gridbugs/modular2/README.md

# Modular 2

A modular synthesizer, where modules are designed as close to bare PCBs as is
practical/safe. This is the spiritual successor to the [briefcase modular
synthesizer](https://github.com/gridbugs/briefcase-synth/).
