gridbugs/modular2/low-pass-filter/README.md

# Low-pass Filter

## Quirks

### V1

- The "Cutoff" potentiometer is reversed.
