gridbugs/modular2/oscillator/README.md

# Oscillator

## Quirks

### V1

- All the potentiometers are connected backwards, so use a flipped pot socket
  to connect them.
- The IDC power sockets don't connect the 5V rail between them. Connect a wire
  here so modules can be daisy chained after this one.
