gridbugs/modular2/power-supply/README.md

# Power Supply

## Quirks

### V1

- U1 is flipped on the silkscreen from how it should be connected. This means
  there's no space for a heat sink.
