gridbugs/modular2/flipped-pot-socket/README.md

# Flipped Pot Socket

The same as the Pot Socket but the sides of the potentiometer are flipped.
