gridbugs/modular2/pot-socket/pcb.stl

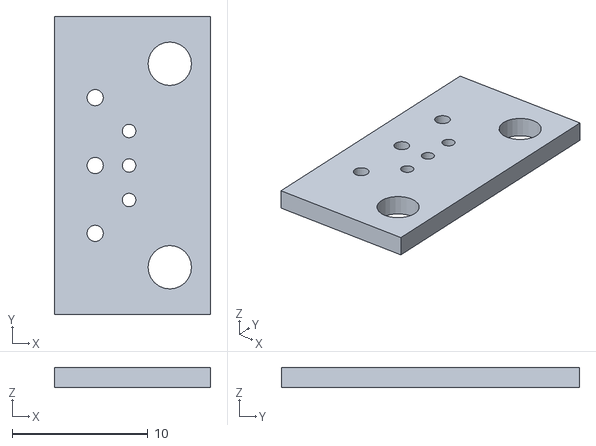
[picture p3: CAD file, 2025-12-11]
pot-socket/pcb.stl
11.5 x 22.0 x 1.51
