gridbugs/modular2/pot-socket/pot-socket.FCStd

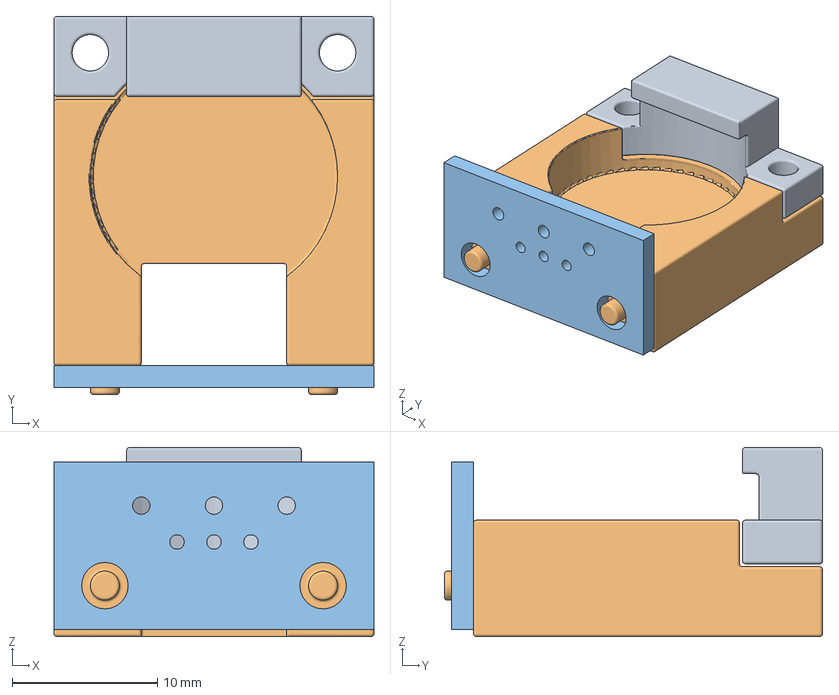
[picture p4: CAD file, 2025-12-11]
pot-socket/pot-socket.FCStd
22.0 x 26.0 x 13.0 mm
Base
pcb
