gridbugs/modular2/pot-socket/base.stl

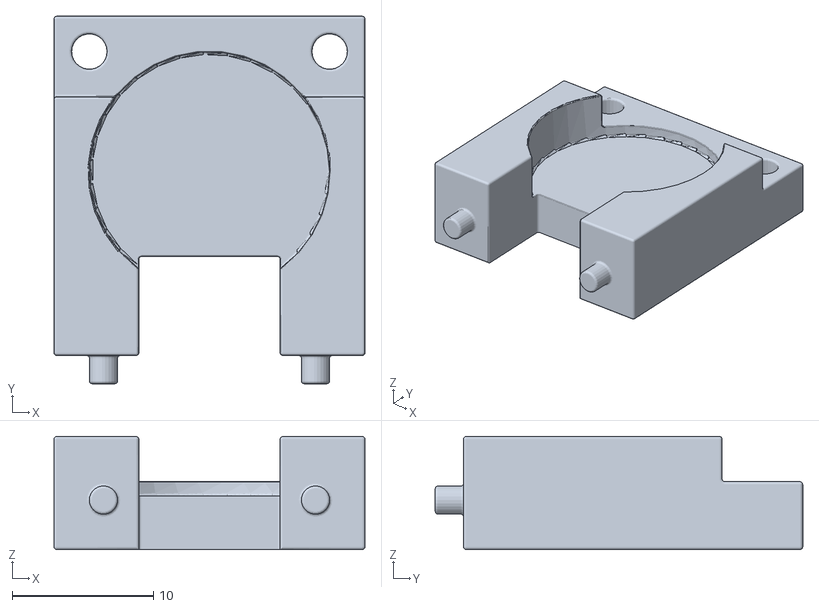
[picture p5: CAD file, 2025-12-03]
pot-socket/base.stl
22.0 x 26.0 x 8.00
