gridbugs/modular2/pot-socket/shell.stl

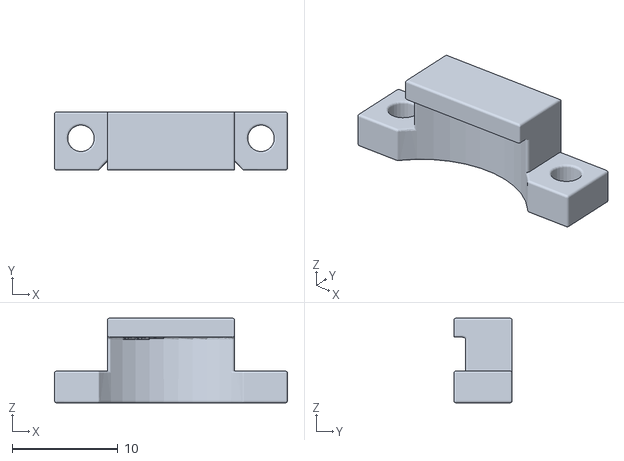
[picture p6: CAD file, 2025-12-03]
pot-socket/shell.stl
22.0 x 5.50 x 8.00
