gridbugs/modular2/gate-sequencer/output.pdf

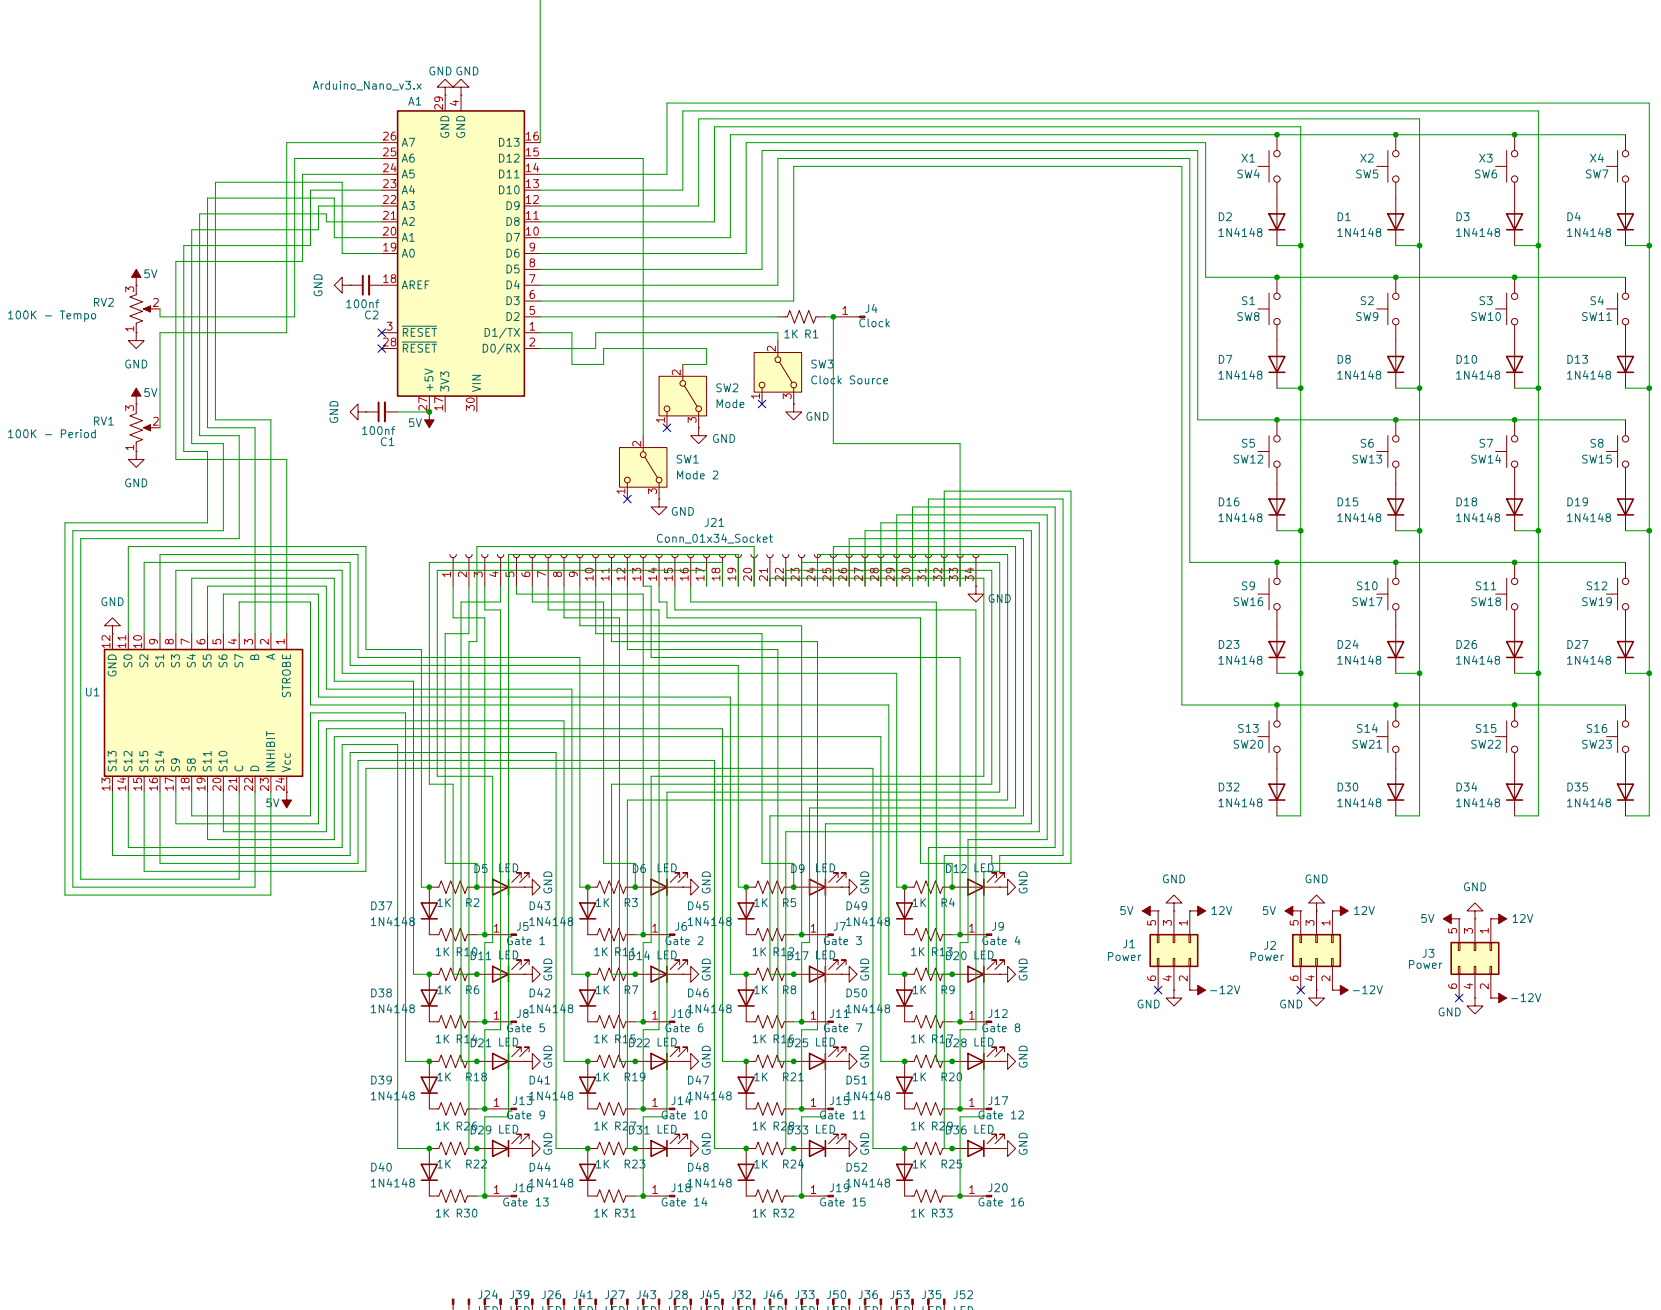
[picture p7: page 1]
