gridbugs/modular2/note-sequencer/output.pdf

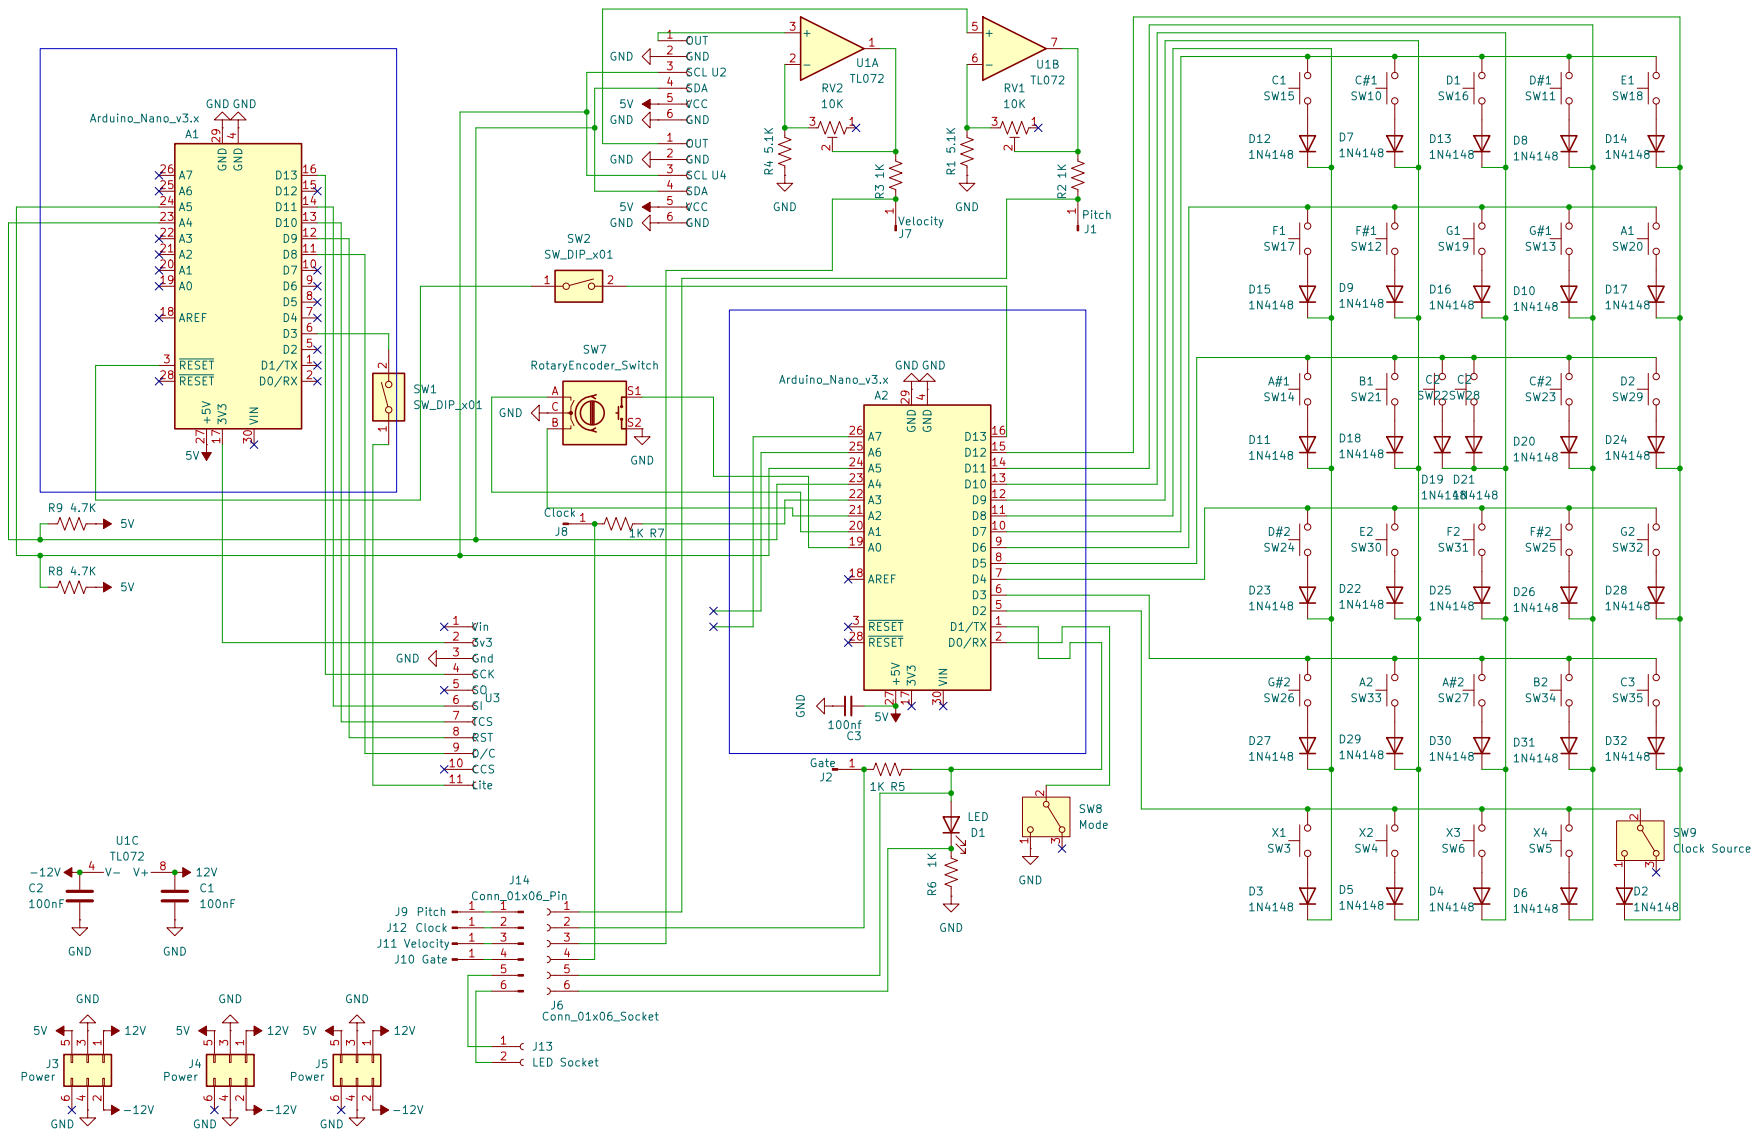
[picture p8: page 1]
