gridbugs/modular2/arduino-delay/output.pdf

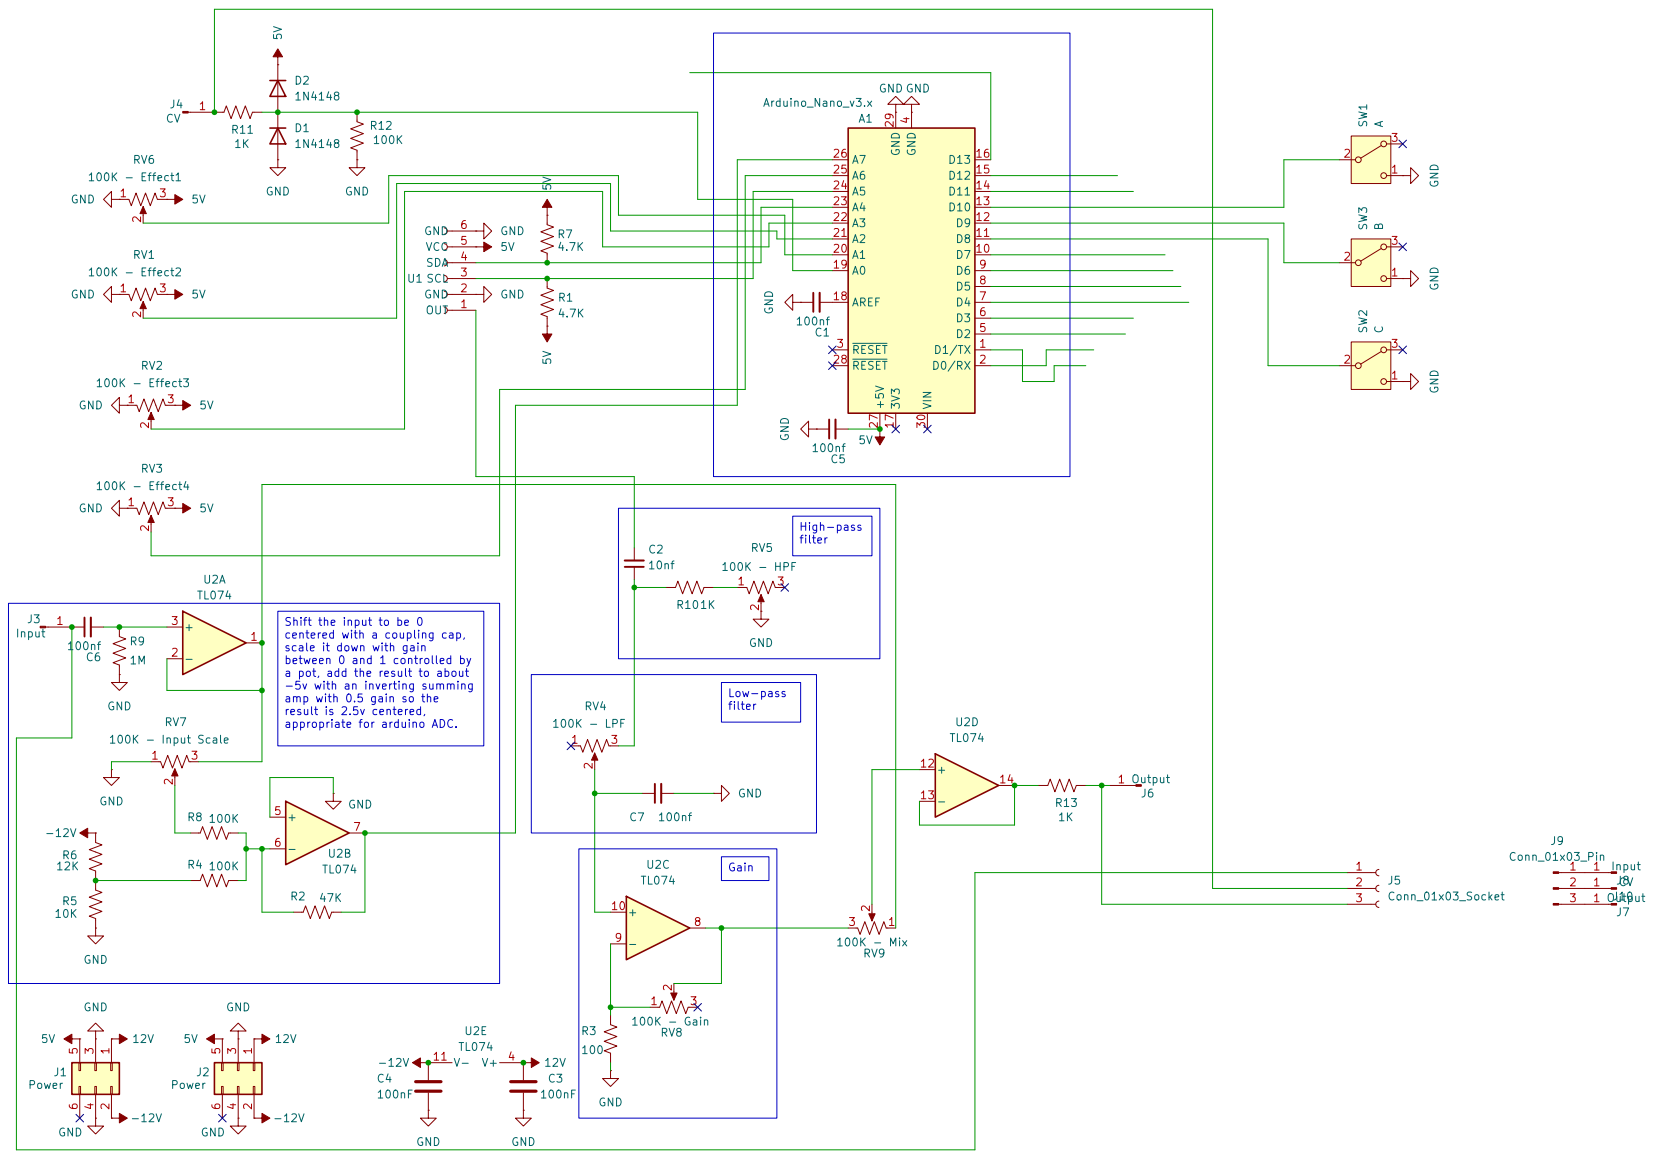
[picture p9: page 1]
