gridbugs/modular2/audio-mixer/output.pdf

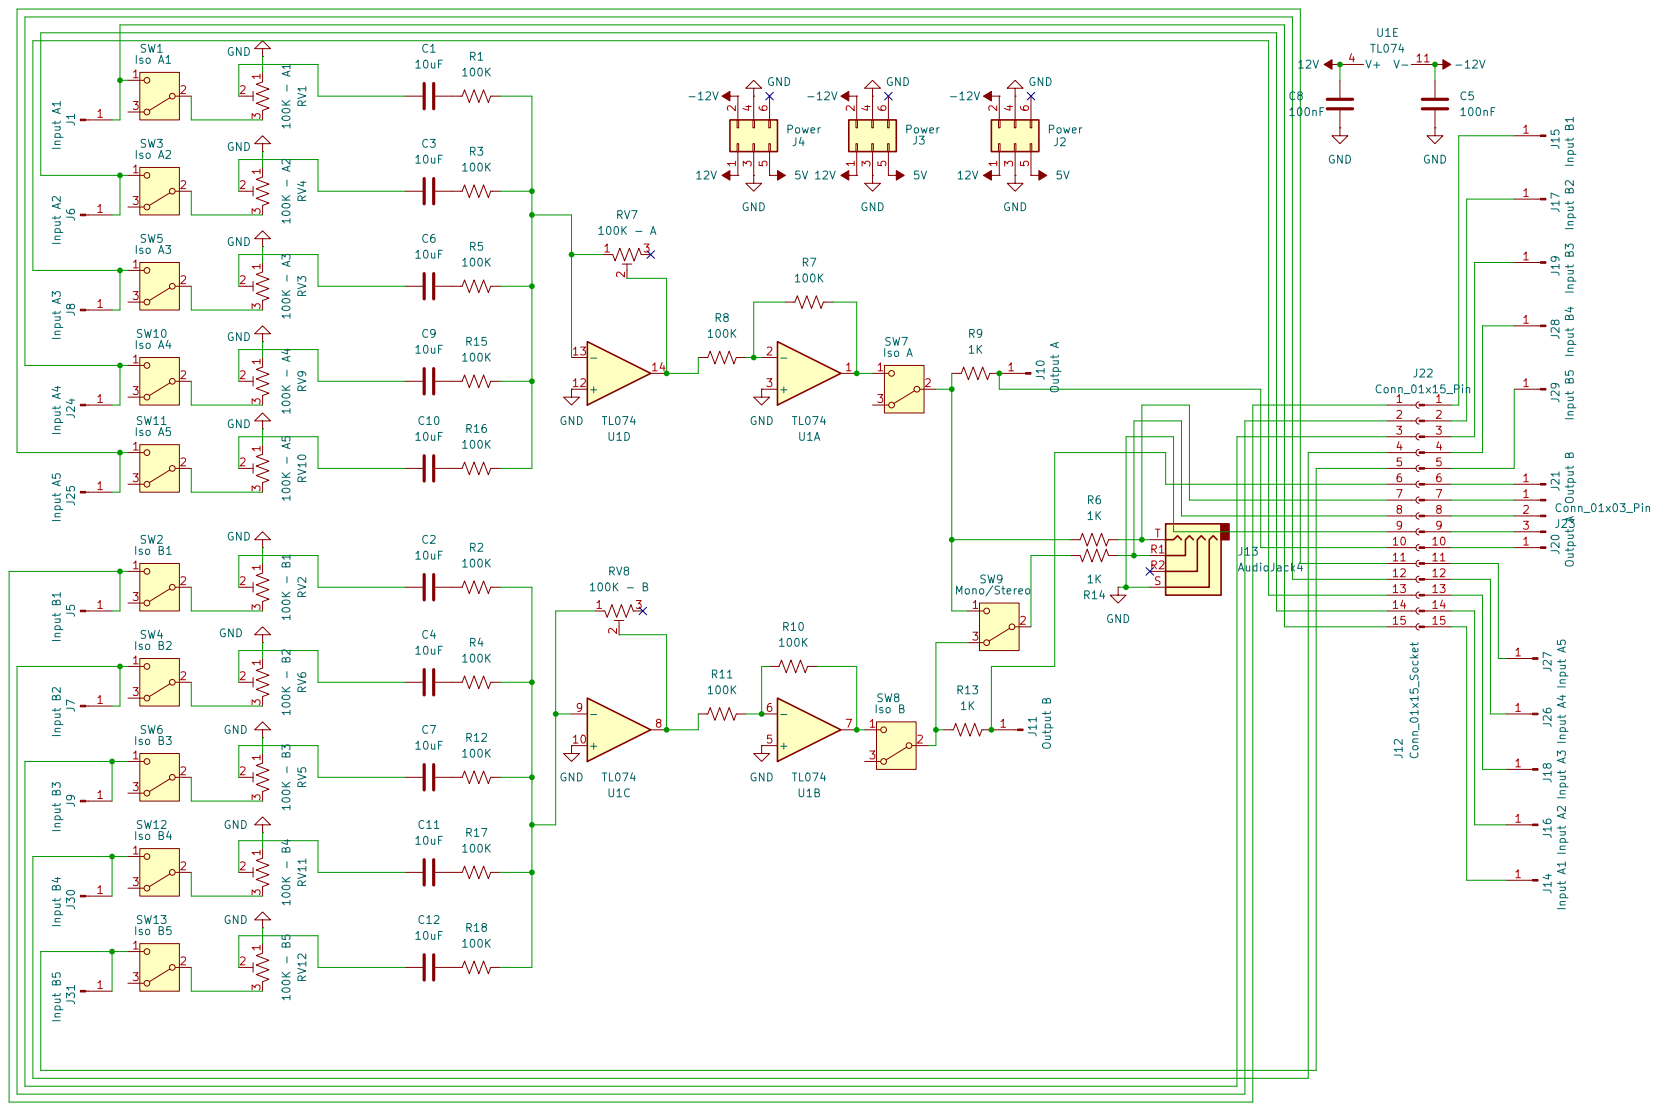
[picture p10: page 1]
