gridbugs/modular2/cv-mixer/output.pdf

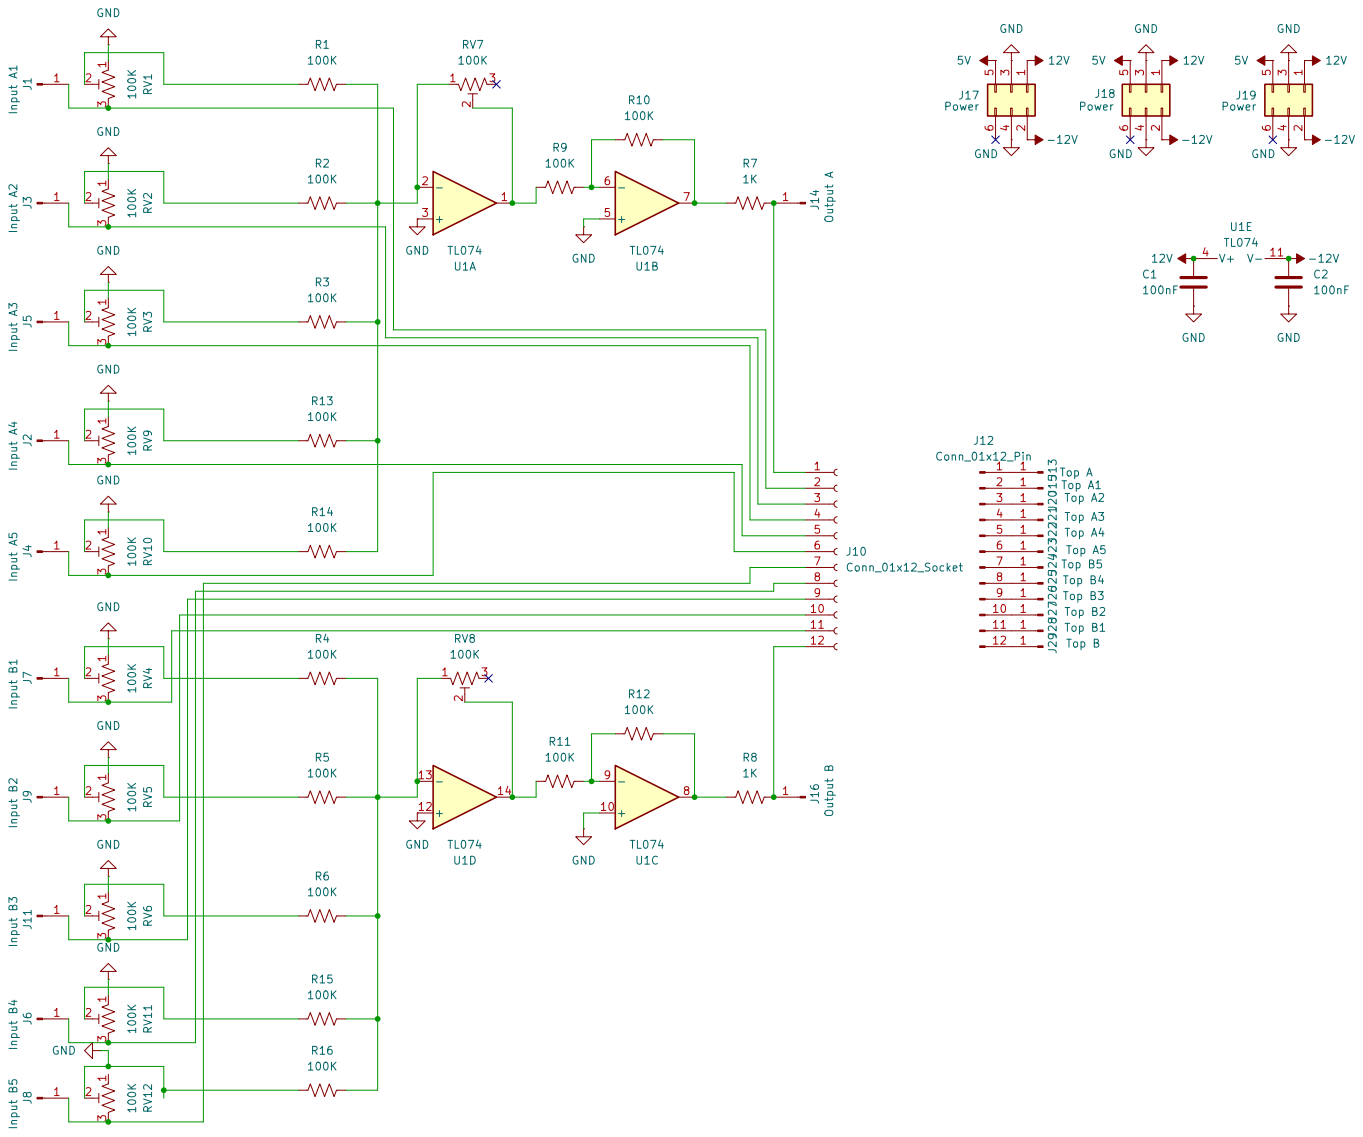
[picture p11: page 1]
