gridbugs/modular2/oscillator/output.pdf

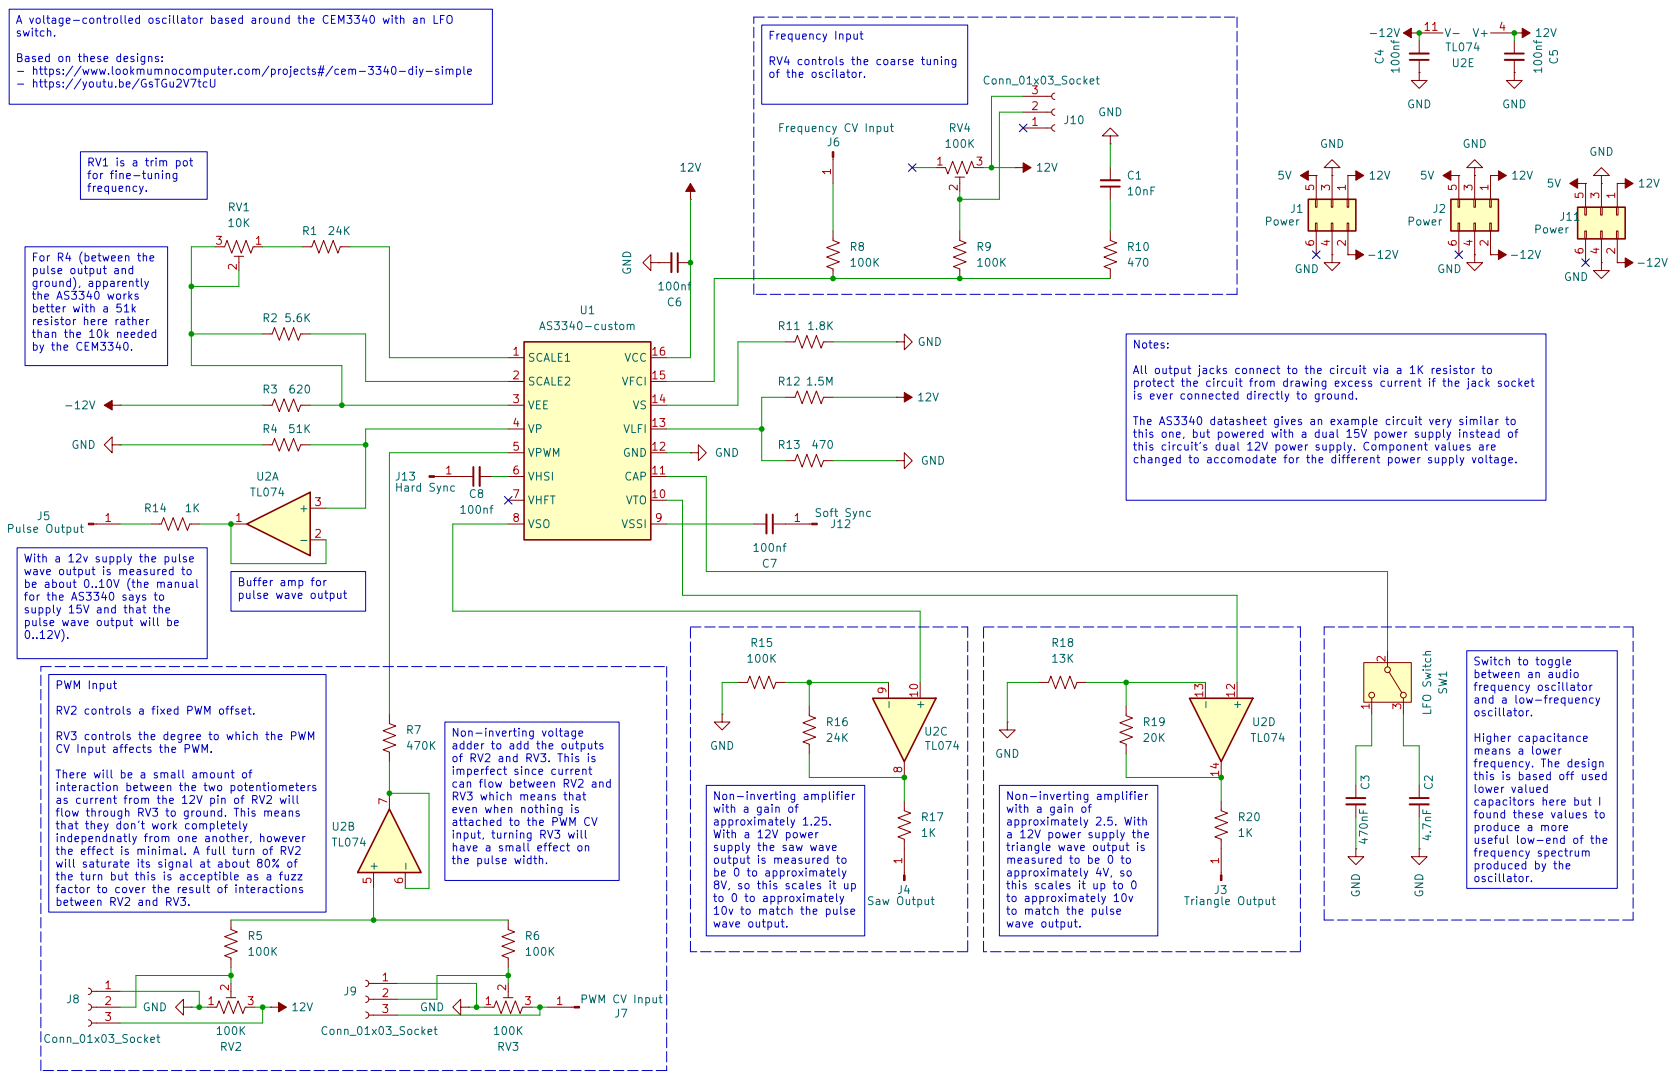
[picture p12: page 1]
