gridbugs/modular2/diode-ladder-filter/output.pdf

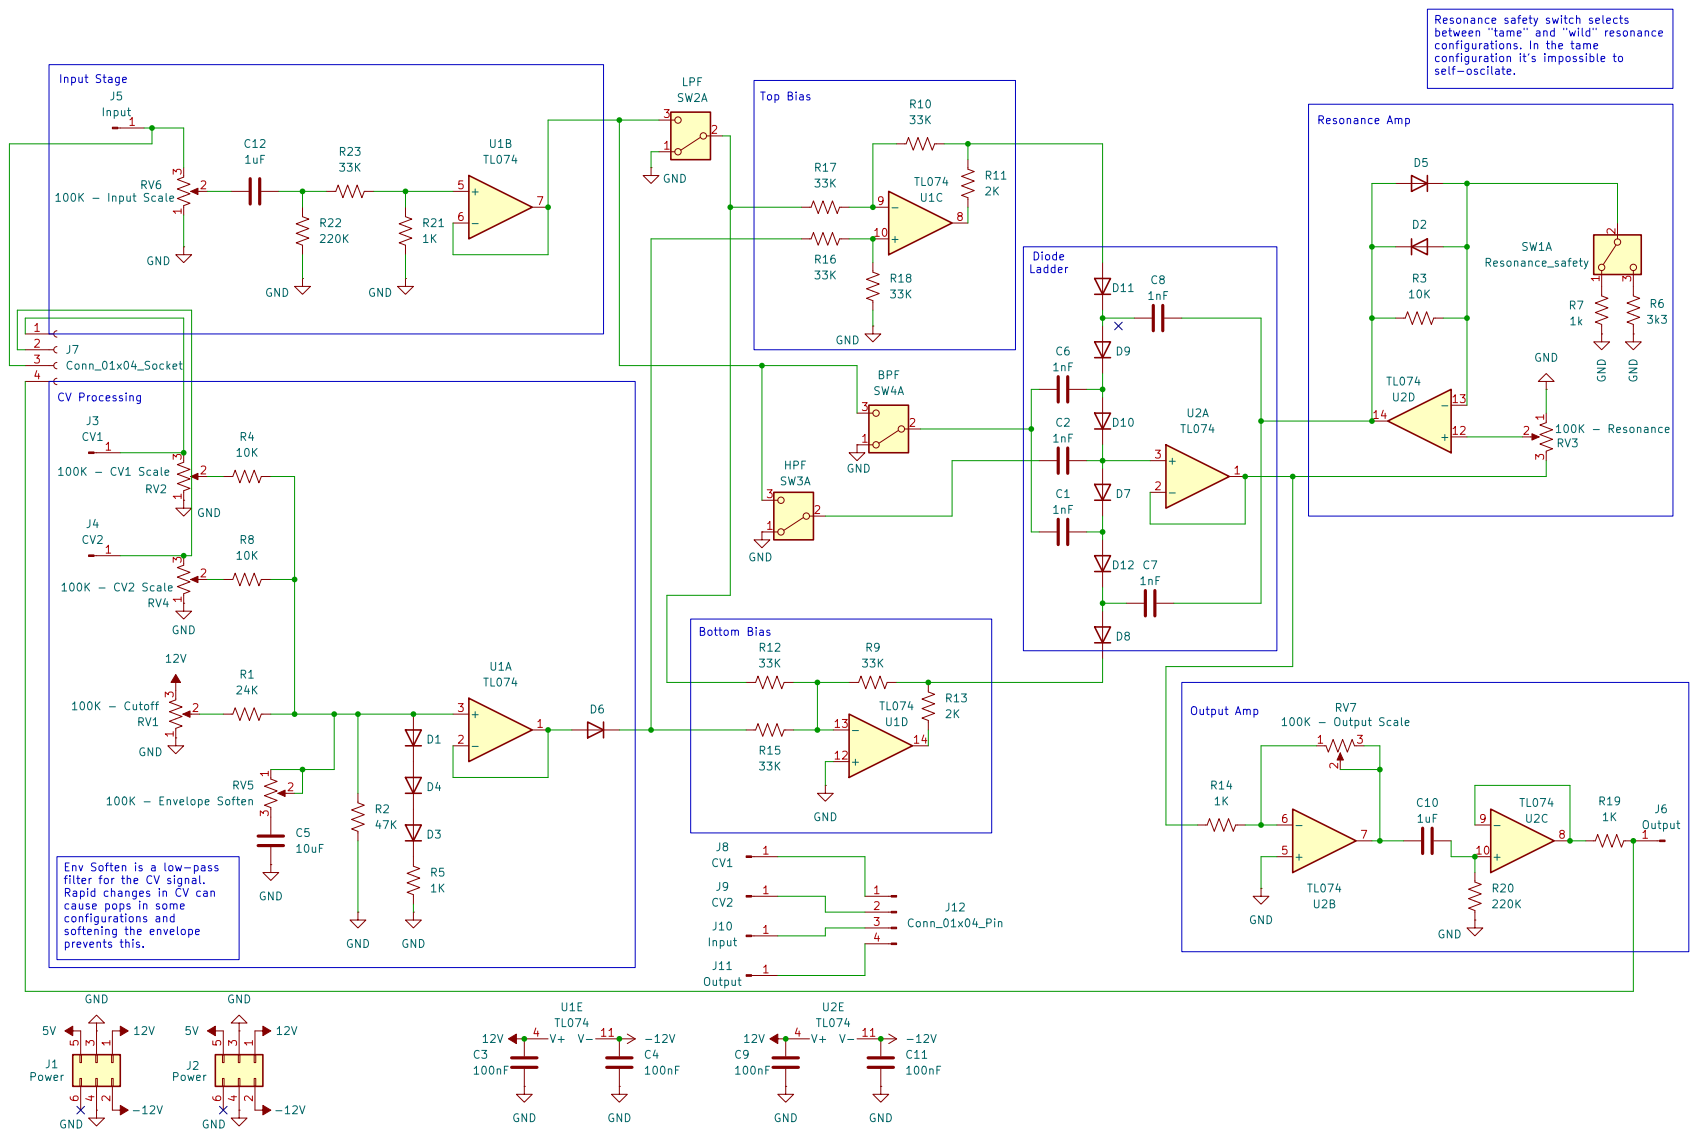
[picture p13: page 1]
