gridbugs/modular2/attenuverter/output.pdf

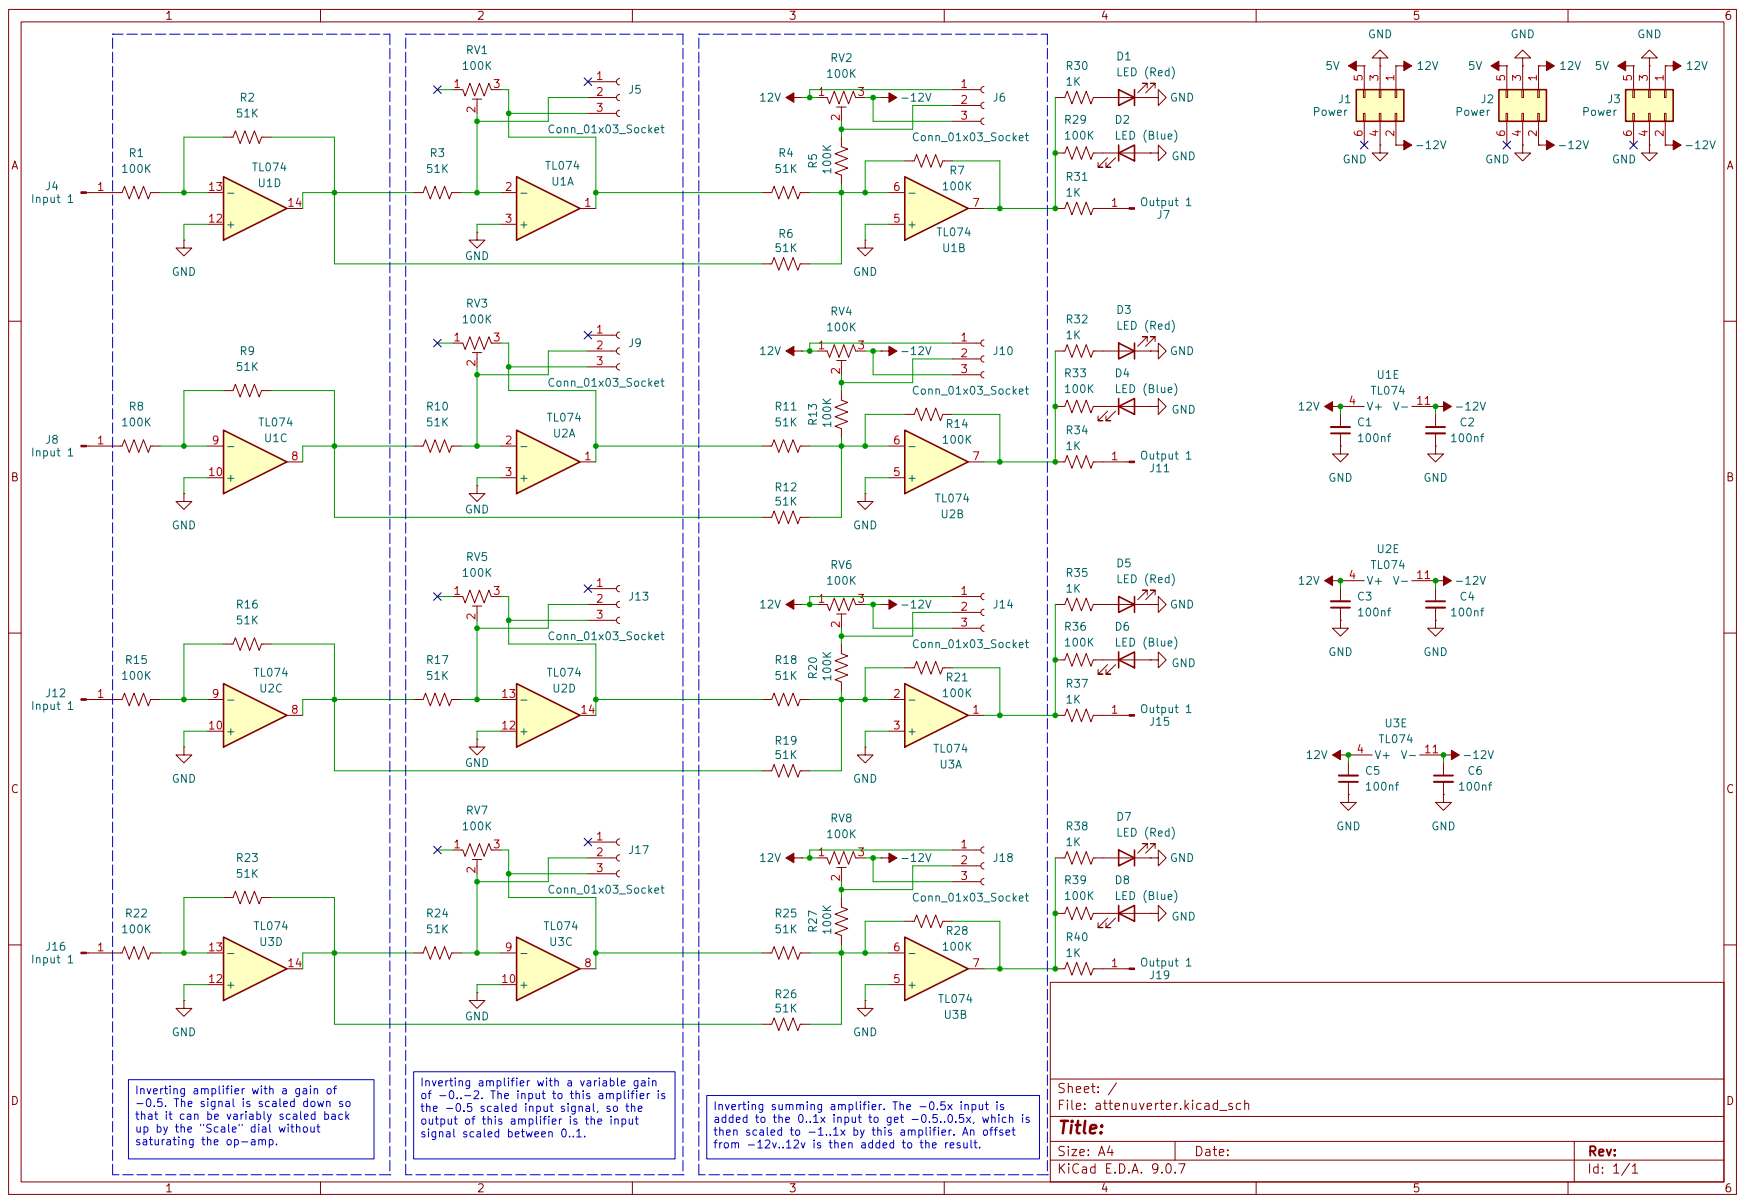
[picture p14: page 1]
