gridbugs/modular2/pattern-sequencer/output.pdf

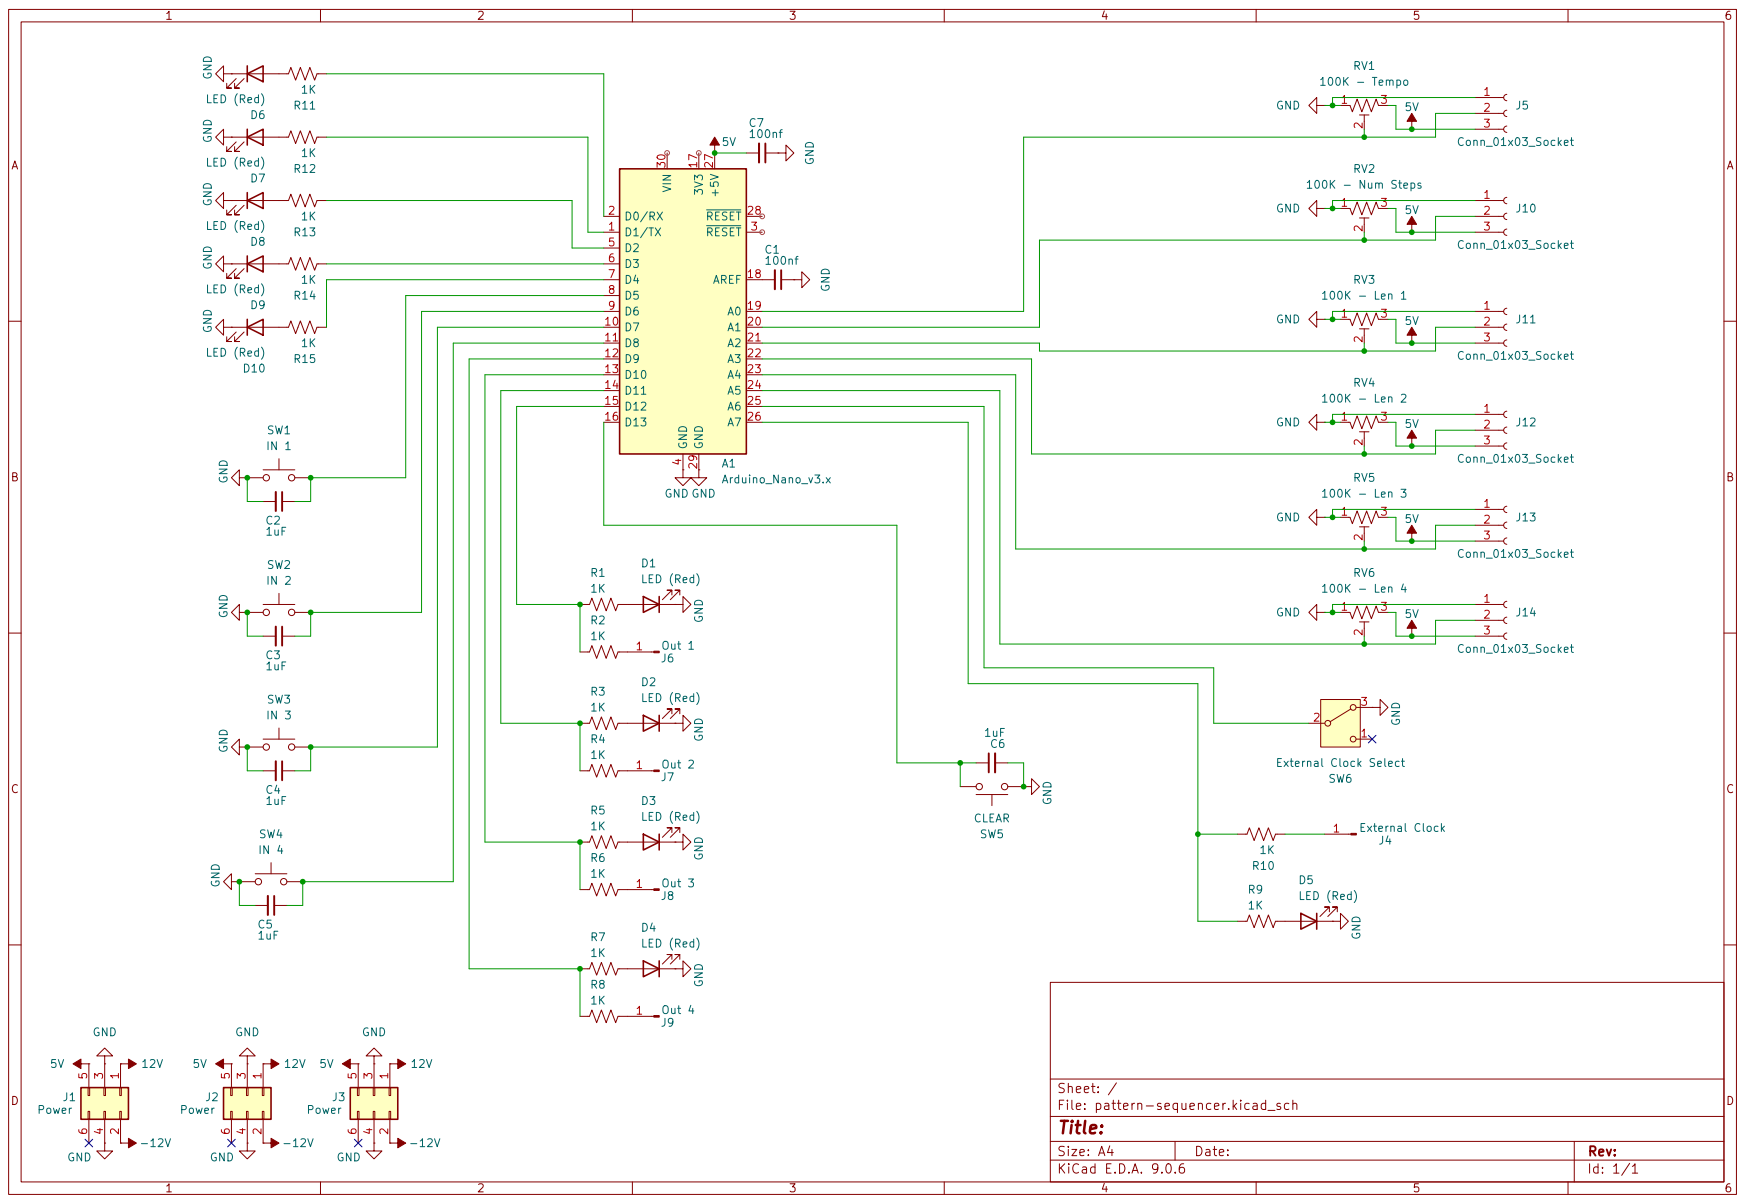
[picture p15: page 1]
