gridbugs/modular2/low-pass-filter/output.pdf

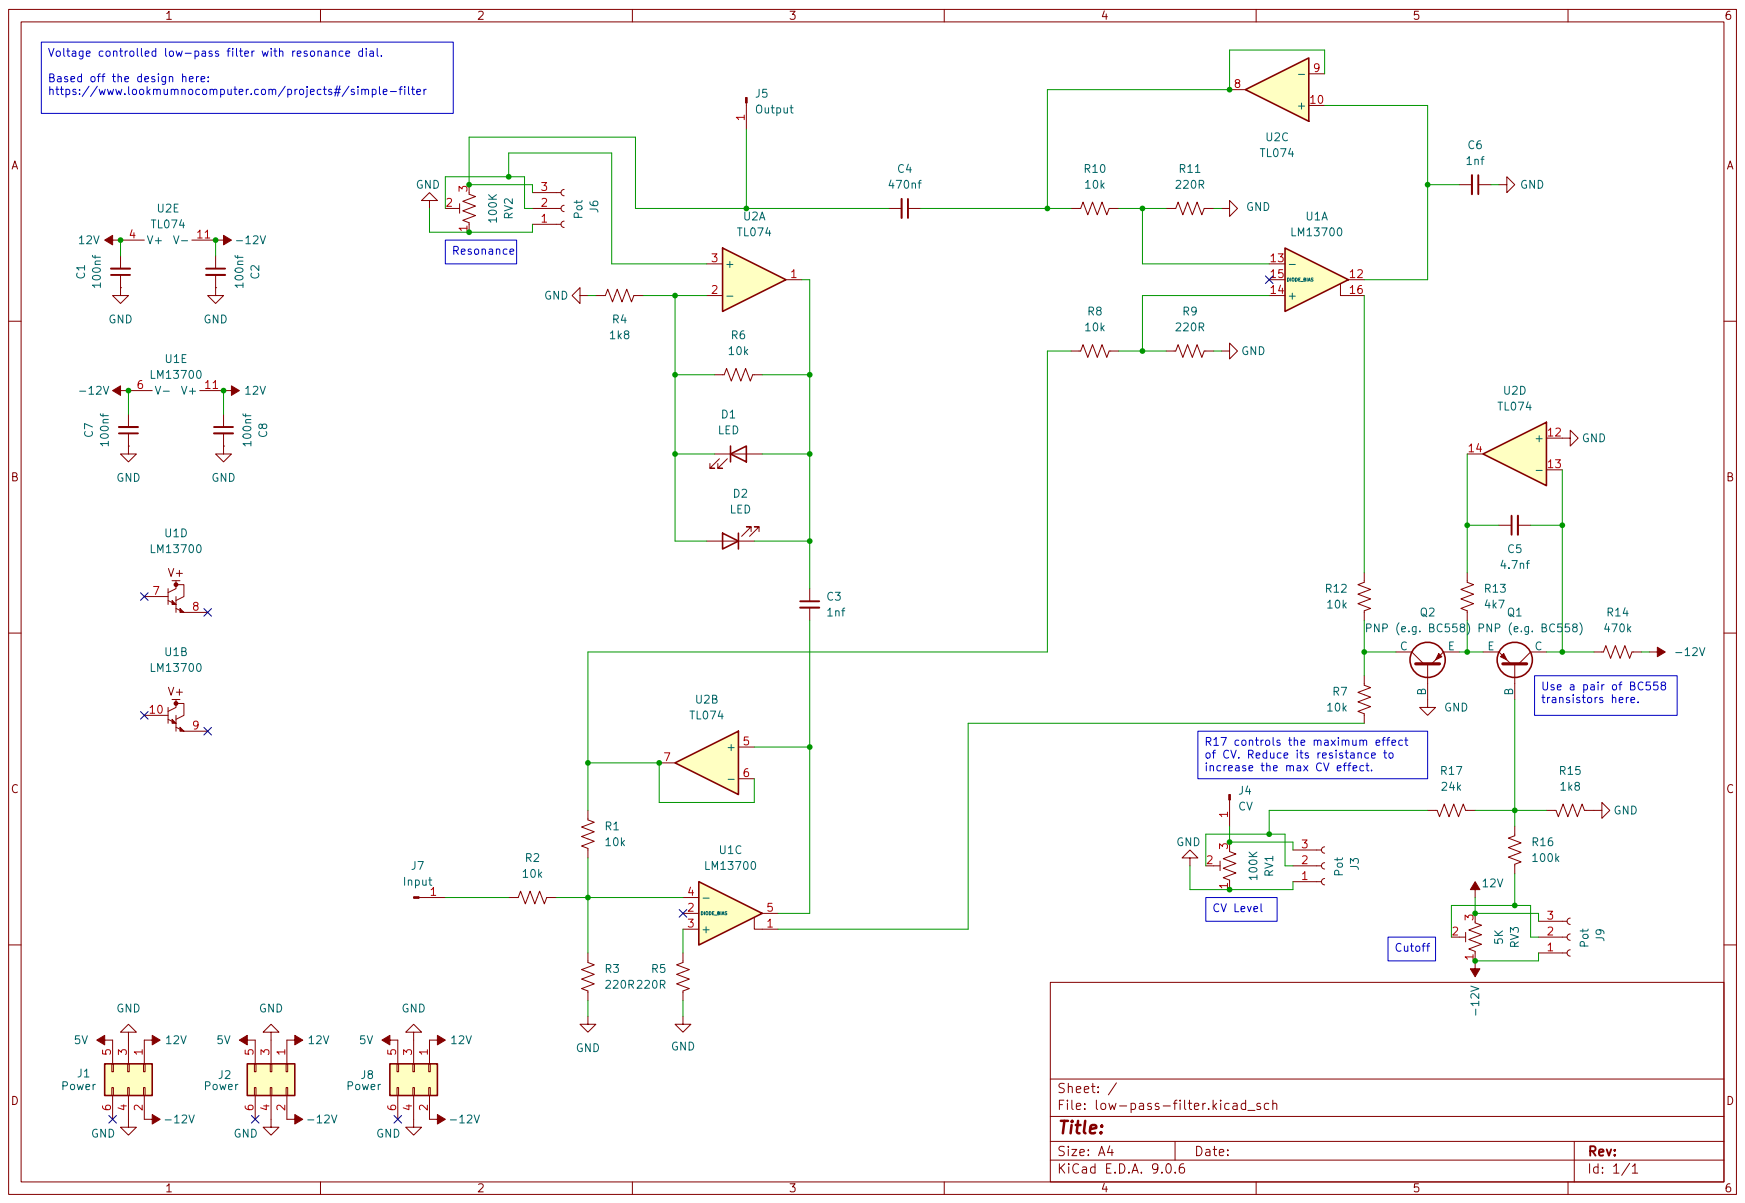
[picture p16: page 1]
