gridbugs/modular2/power-supply/output.pdf

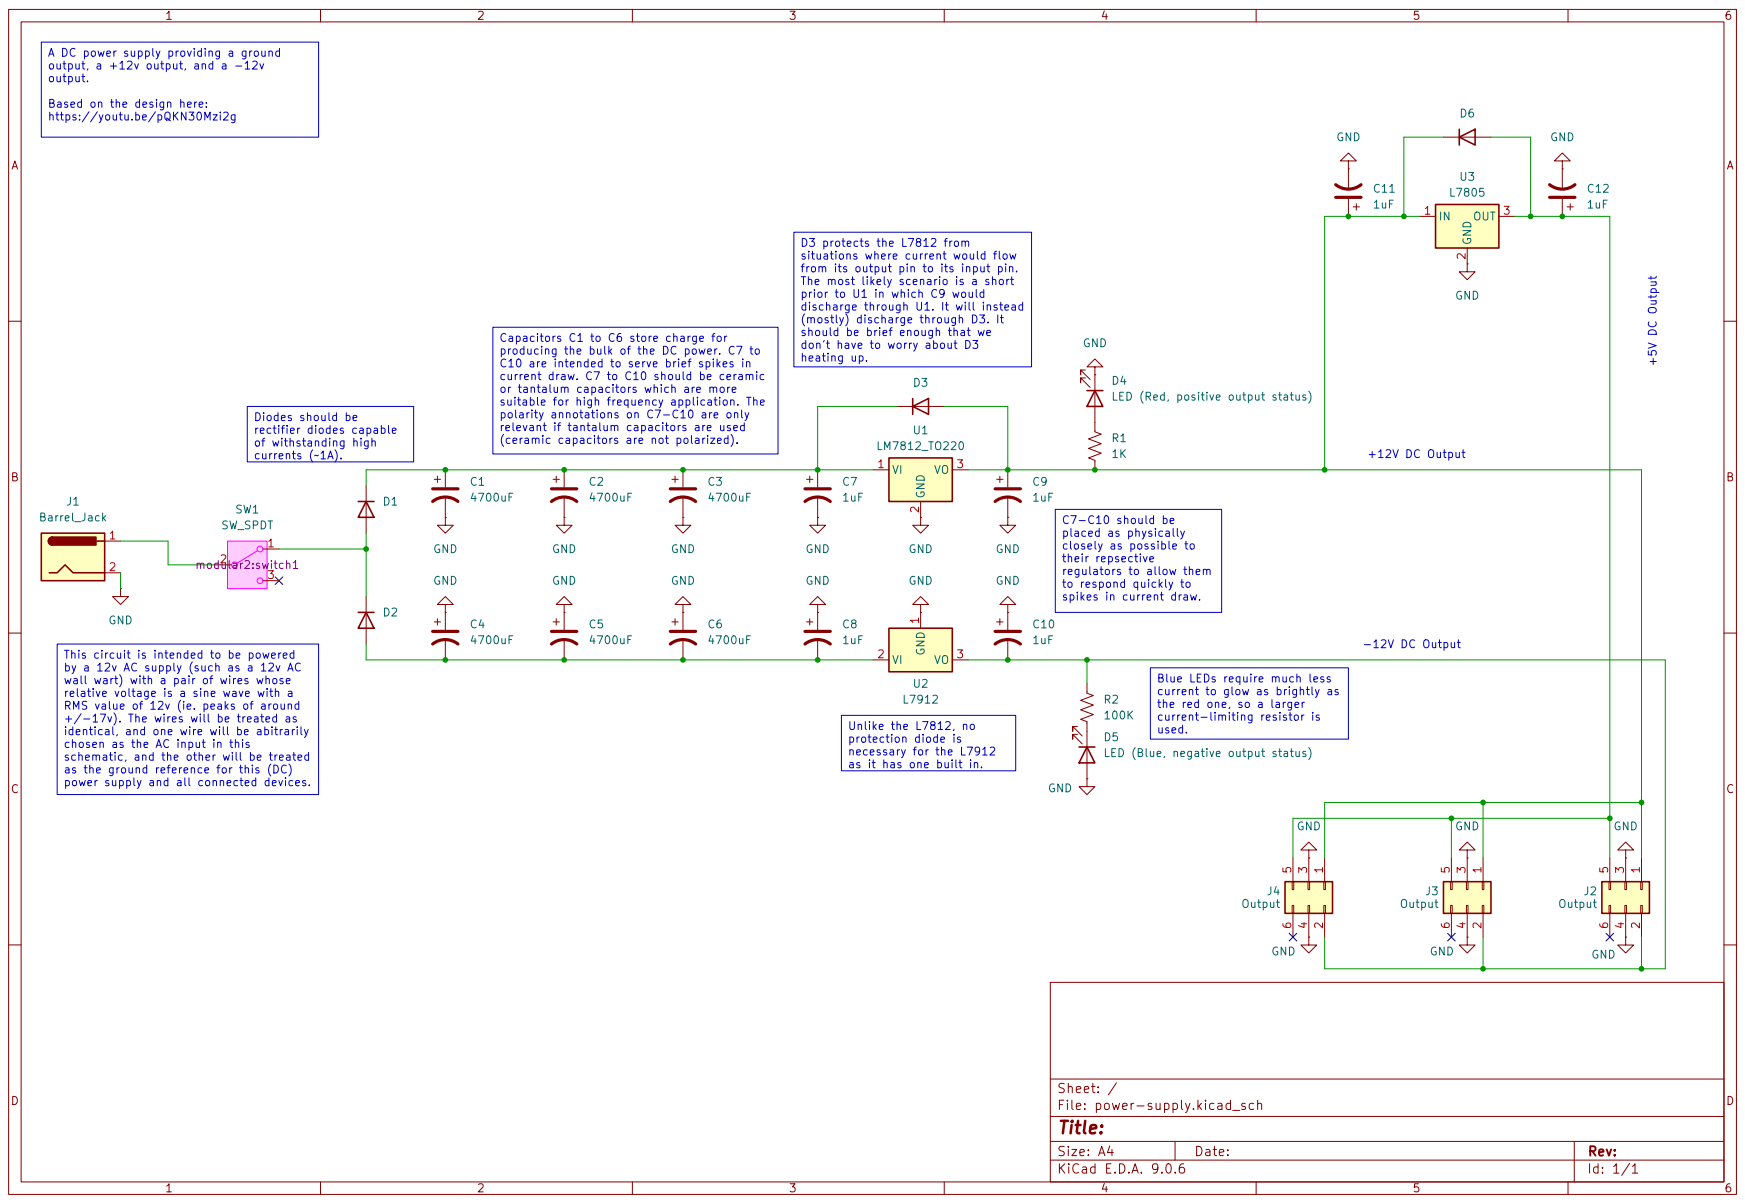
[picture p17: page 1]
