gridbugs/modular2/envelope-generator/output.pdf

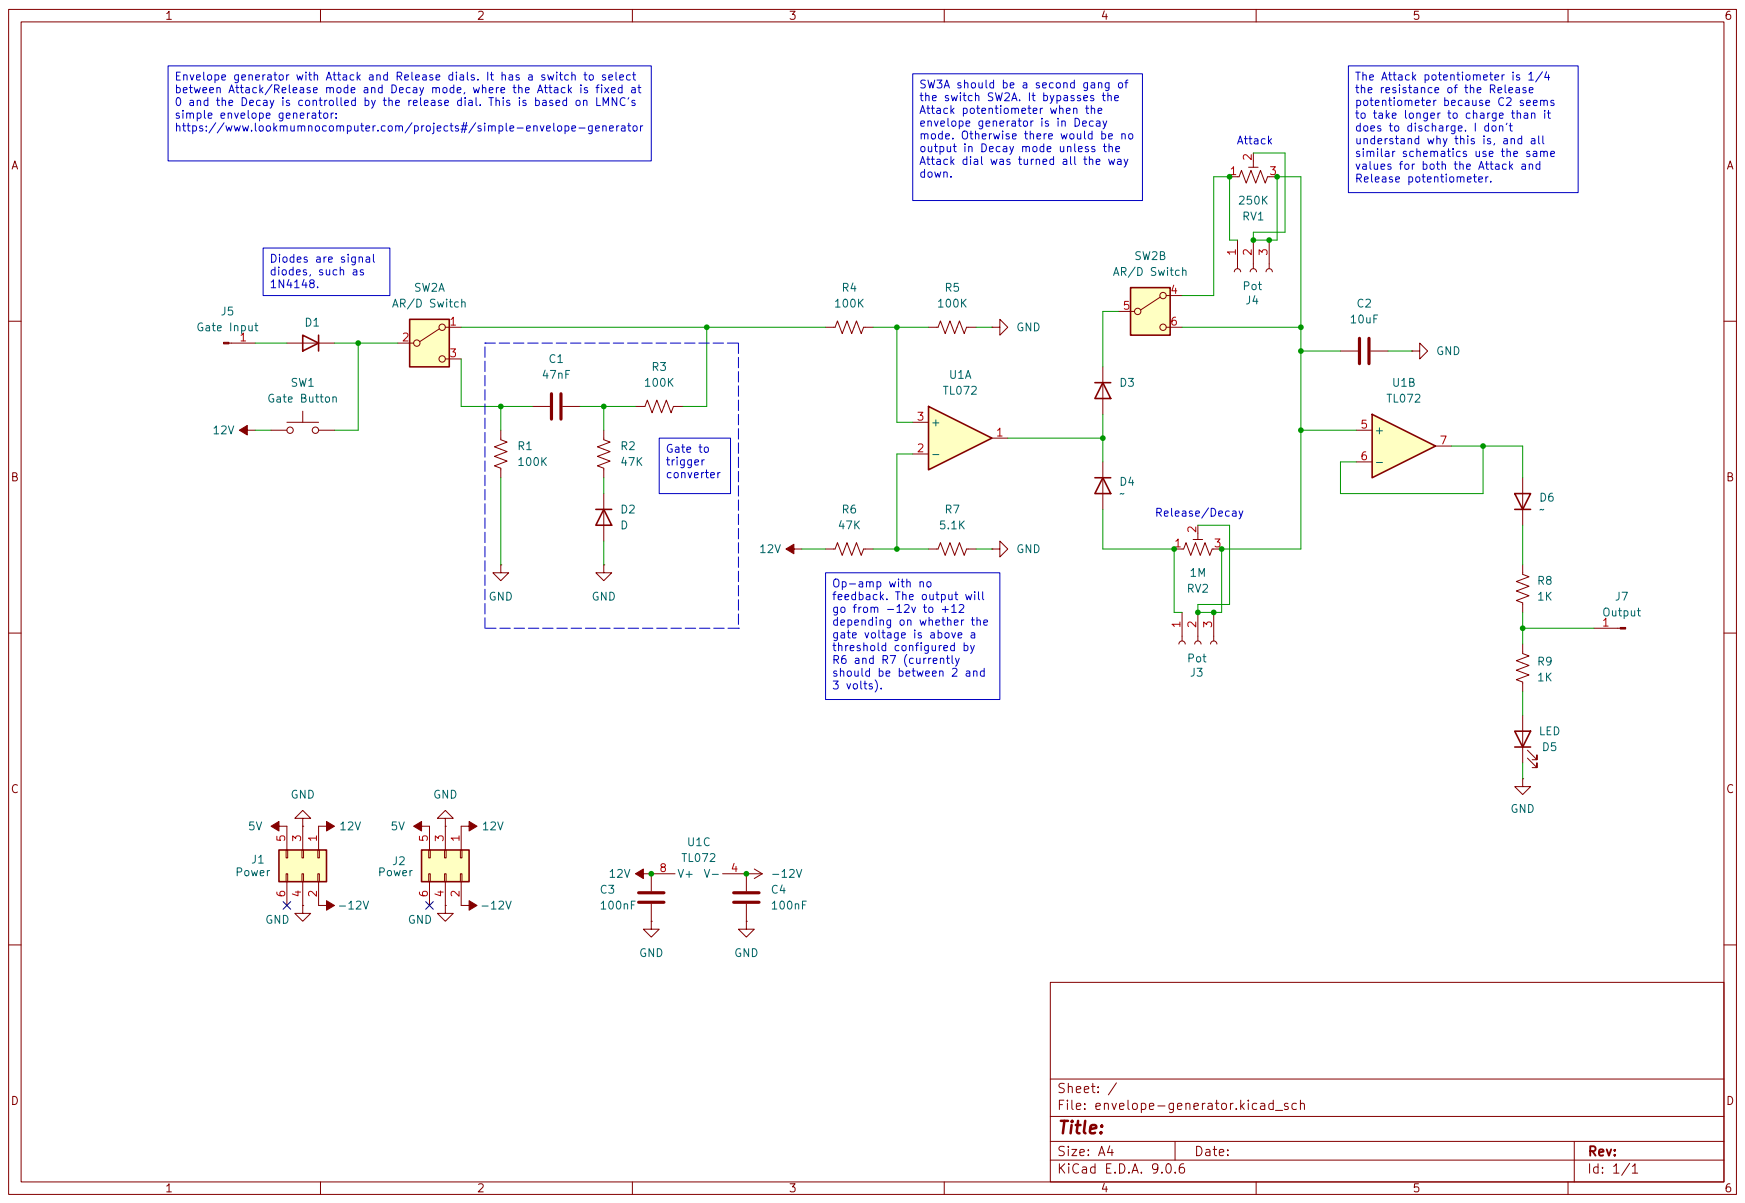
[picture p18: page 1]
