gridbugs/modular2/flipped-pot-socket/output.pdf

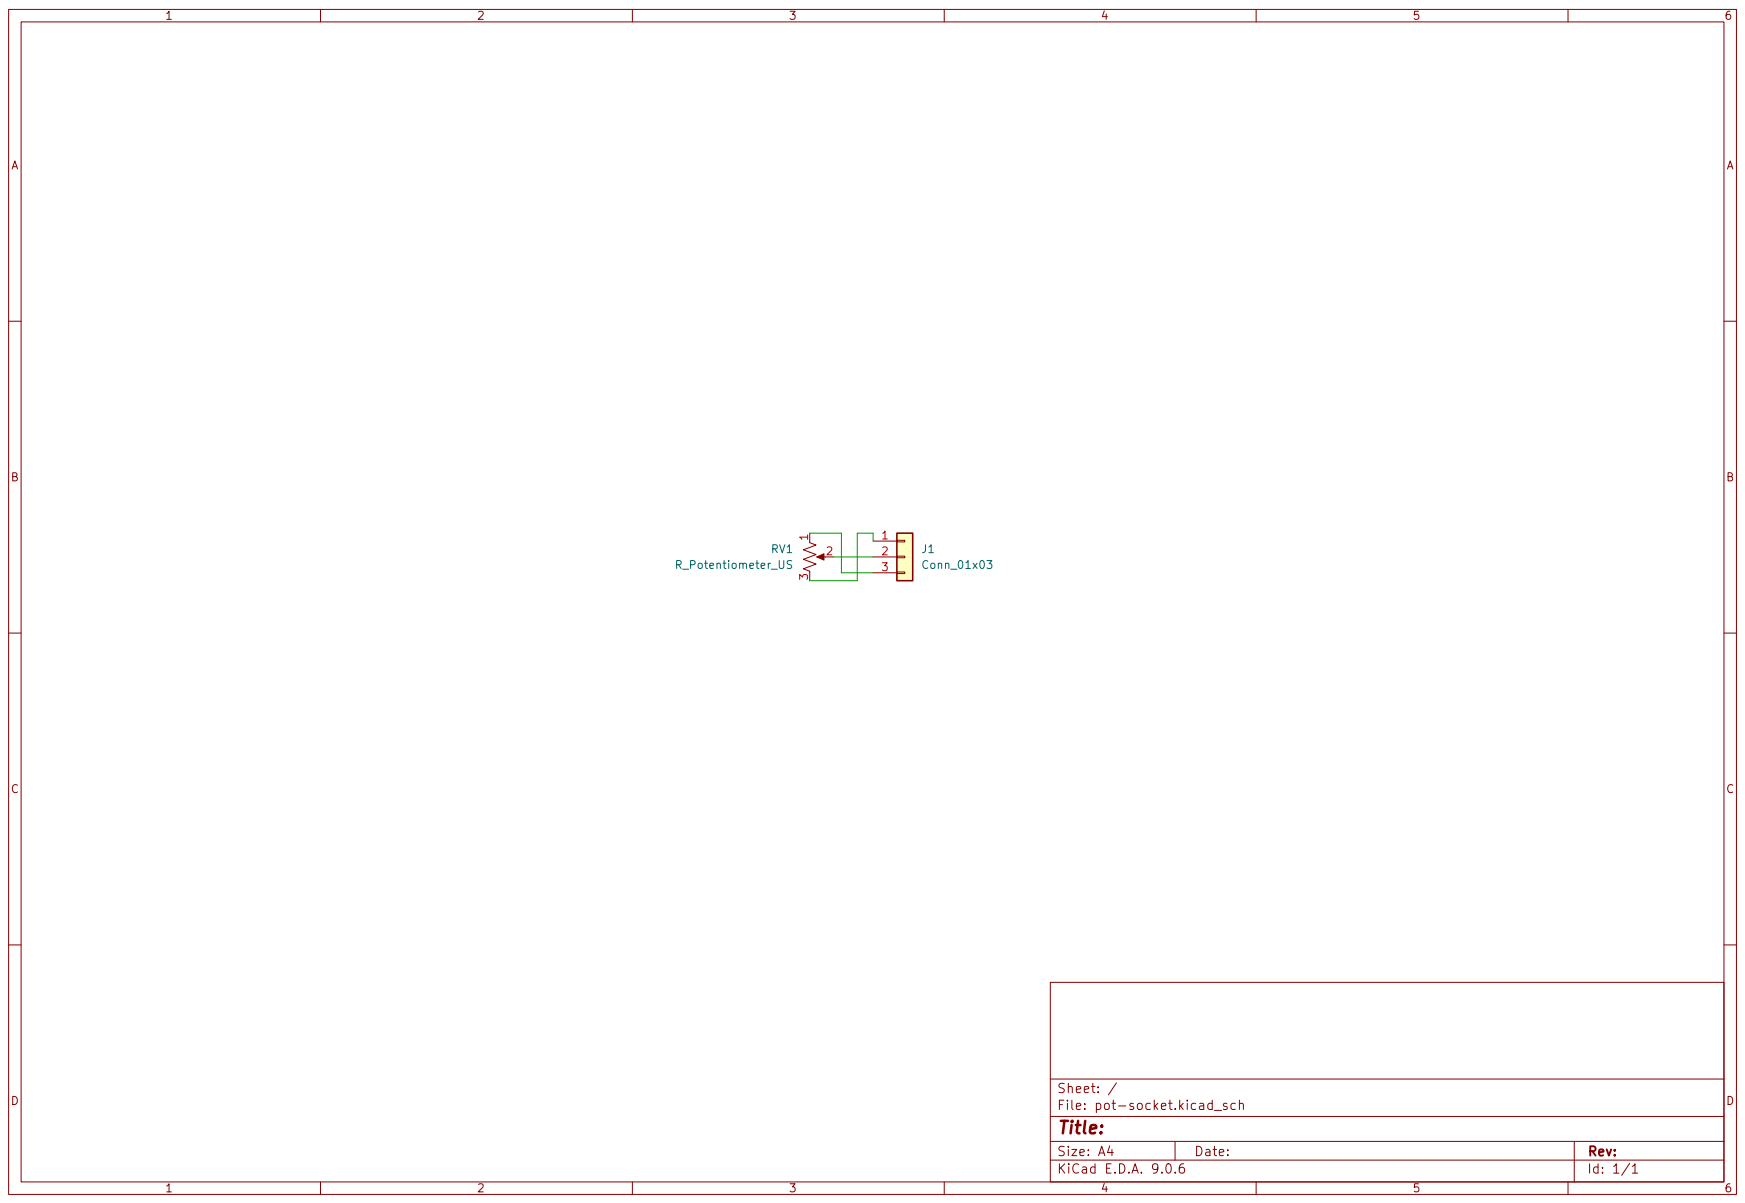
[picture p19: page 1]
