gridbugs/modular2/pot-socket/output.pdf

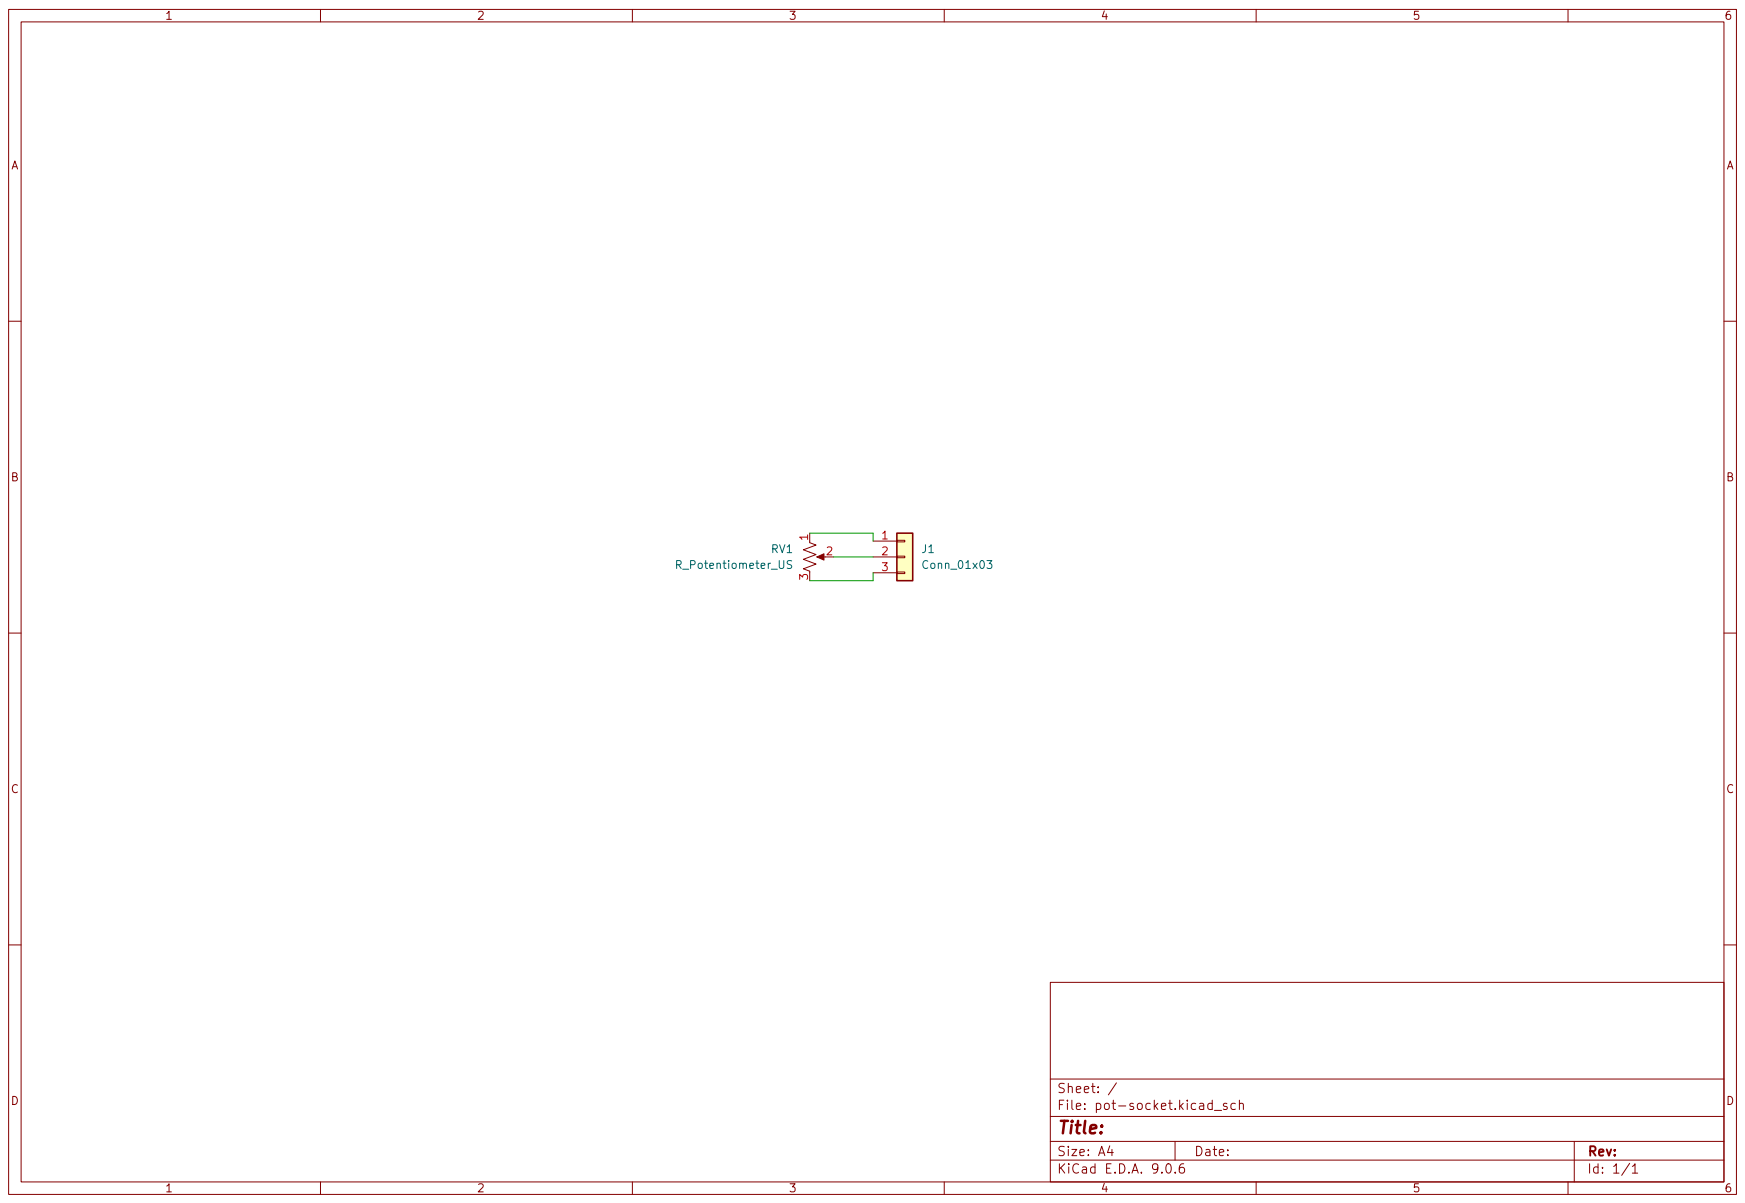
[picture p20: page 1]
