gridbugs/modular2/power-expander/output.pdf

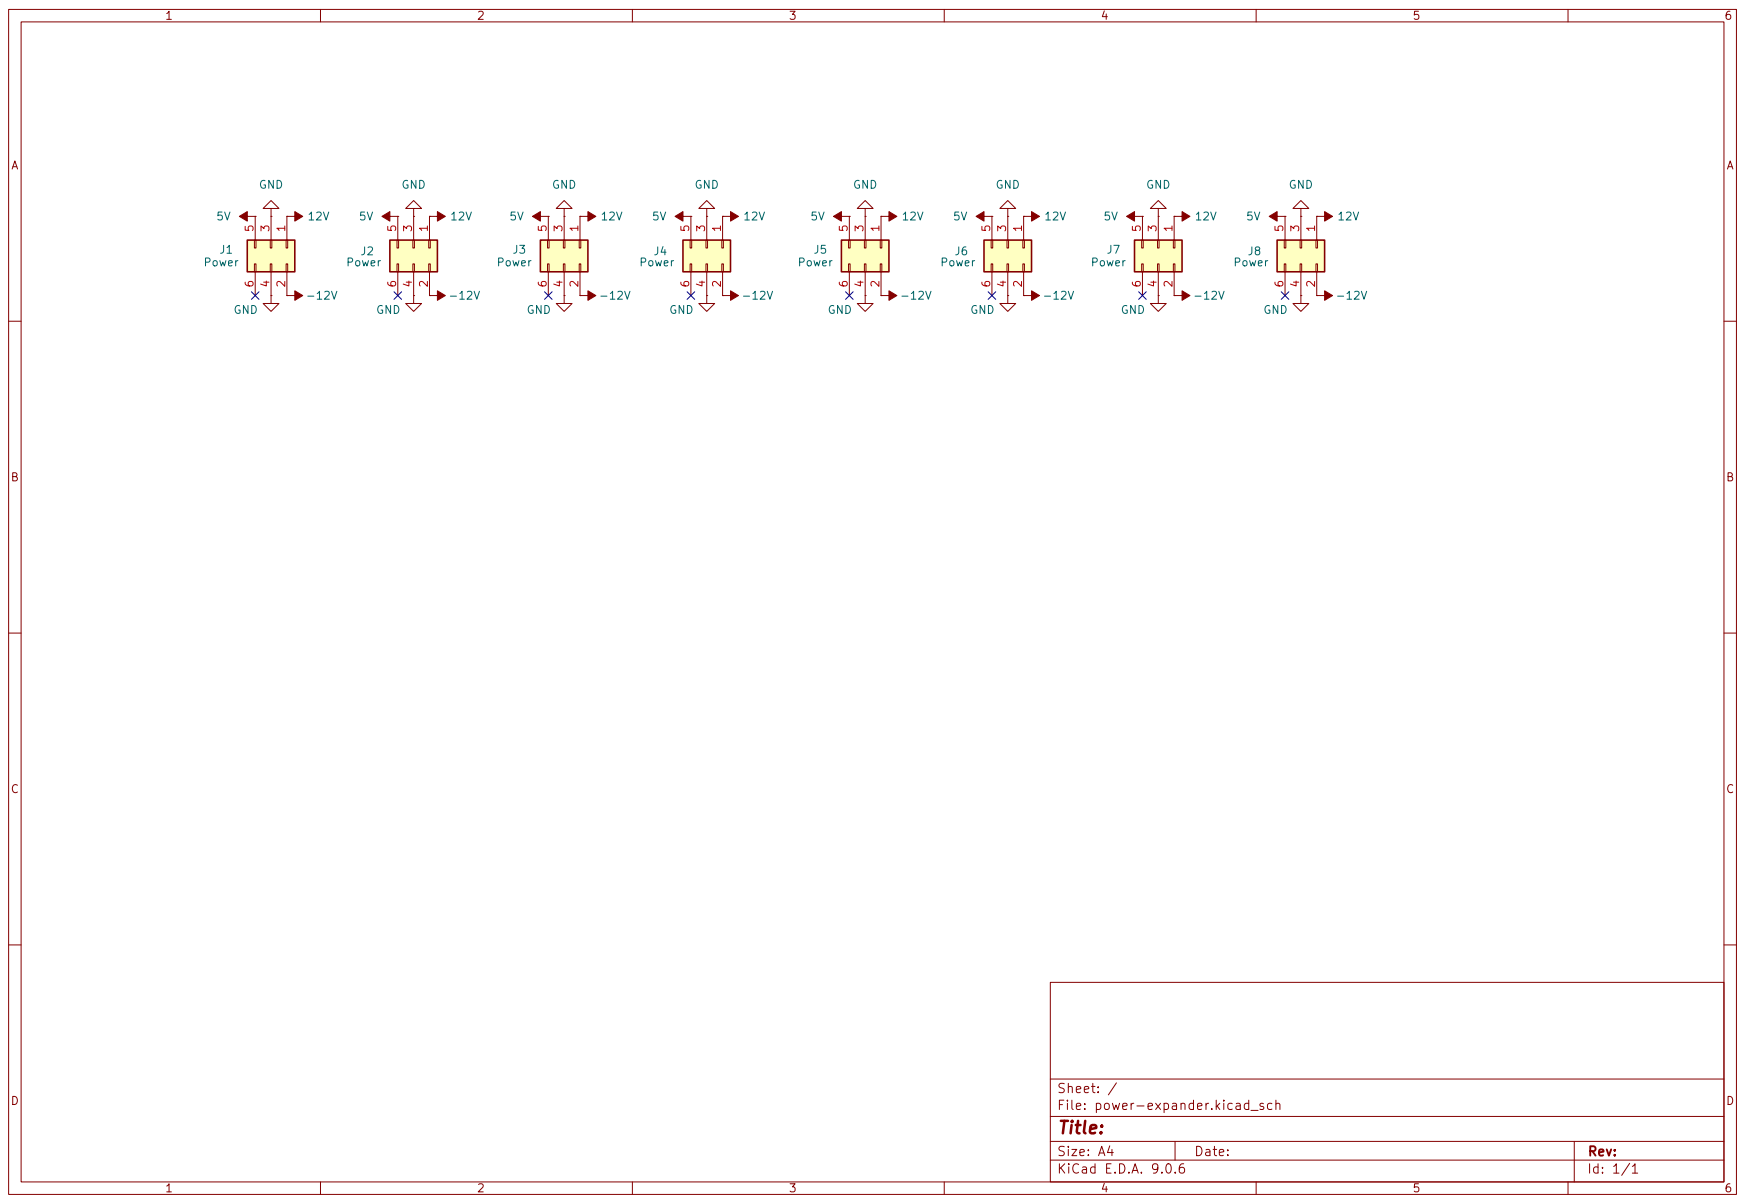
[picture p21: page 1]
