gridbugs/modular2/voltage-controlled-amplifier/output.pdf

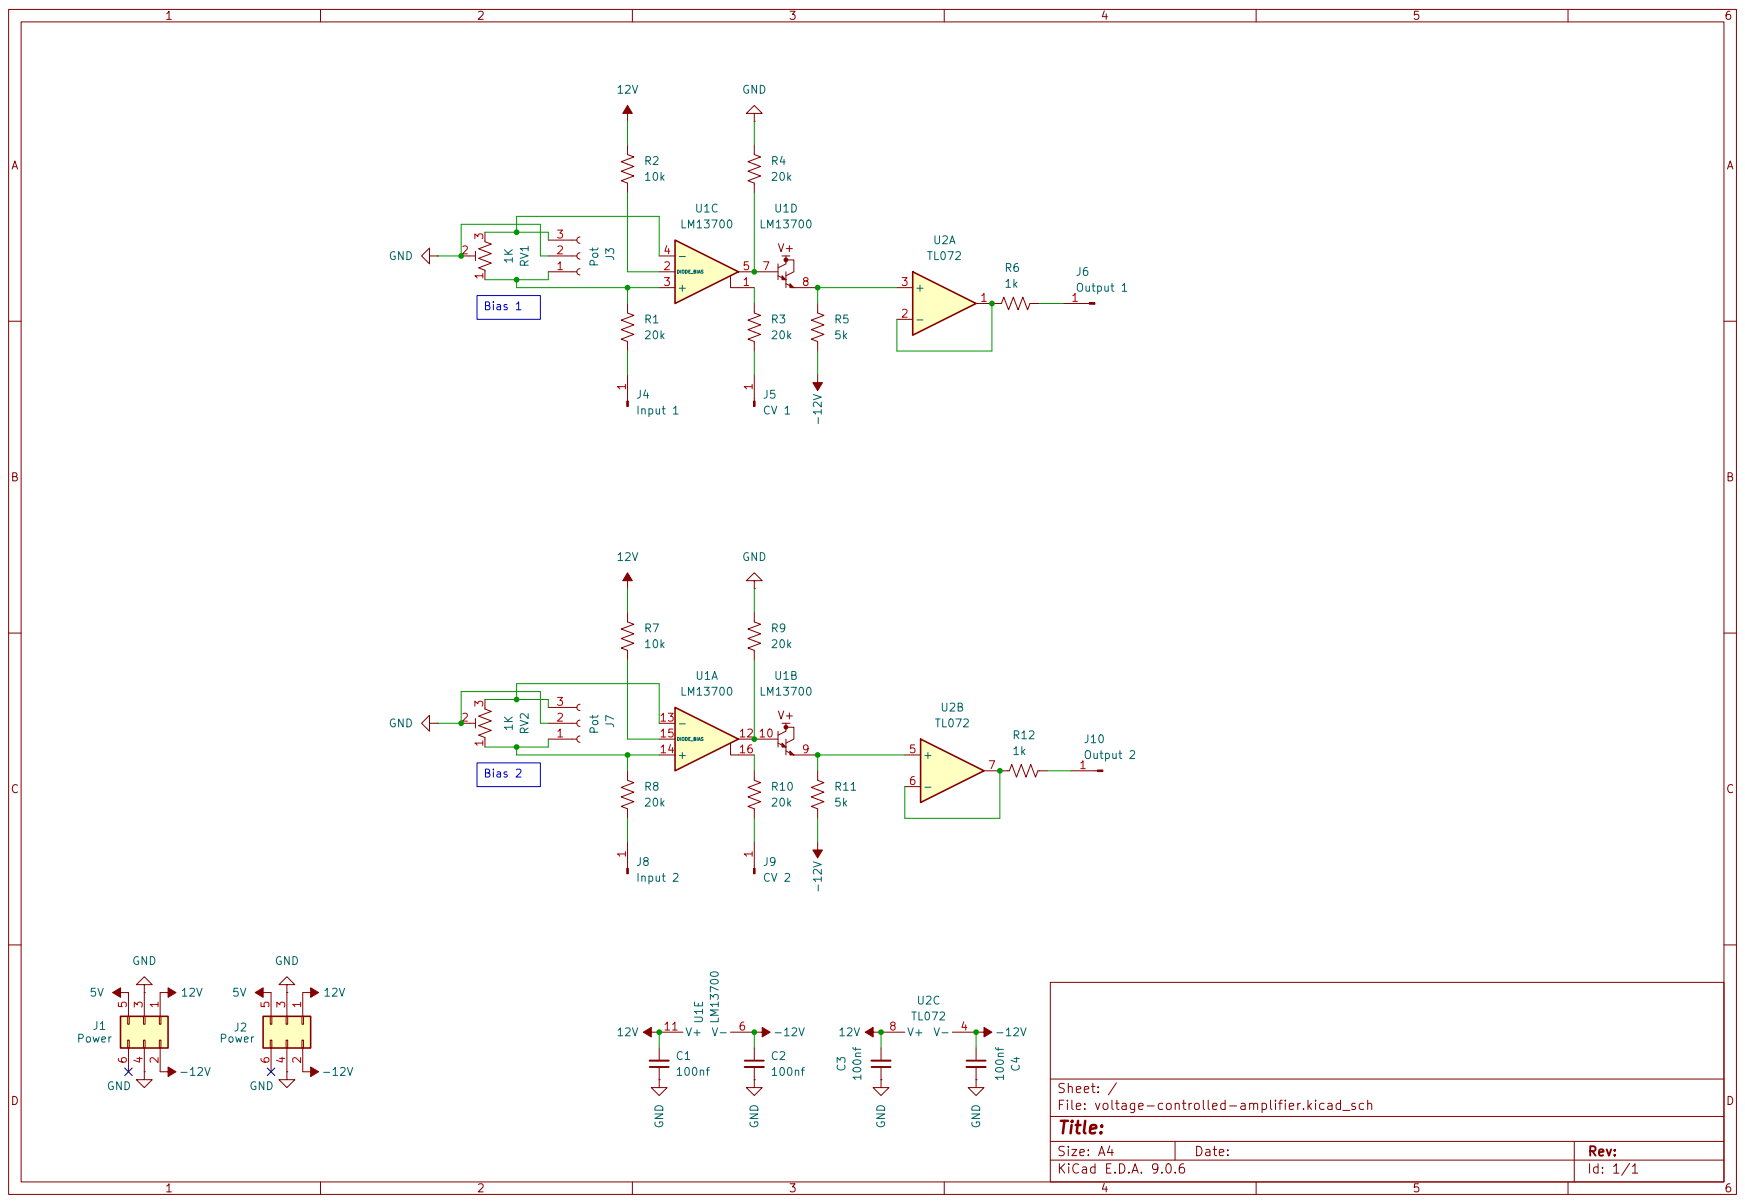
[picture p22: page 1]
