gridbugs/modular2/arduino-delay/arduino-delay.kicad_pcb

## KiCad design arduino-delay/arduino-delay.kicad_pcb (2026-07-06)

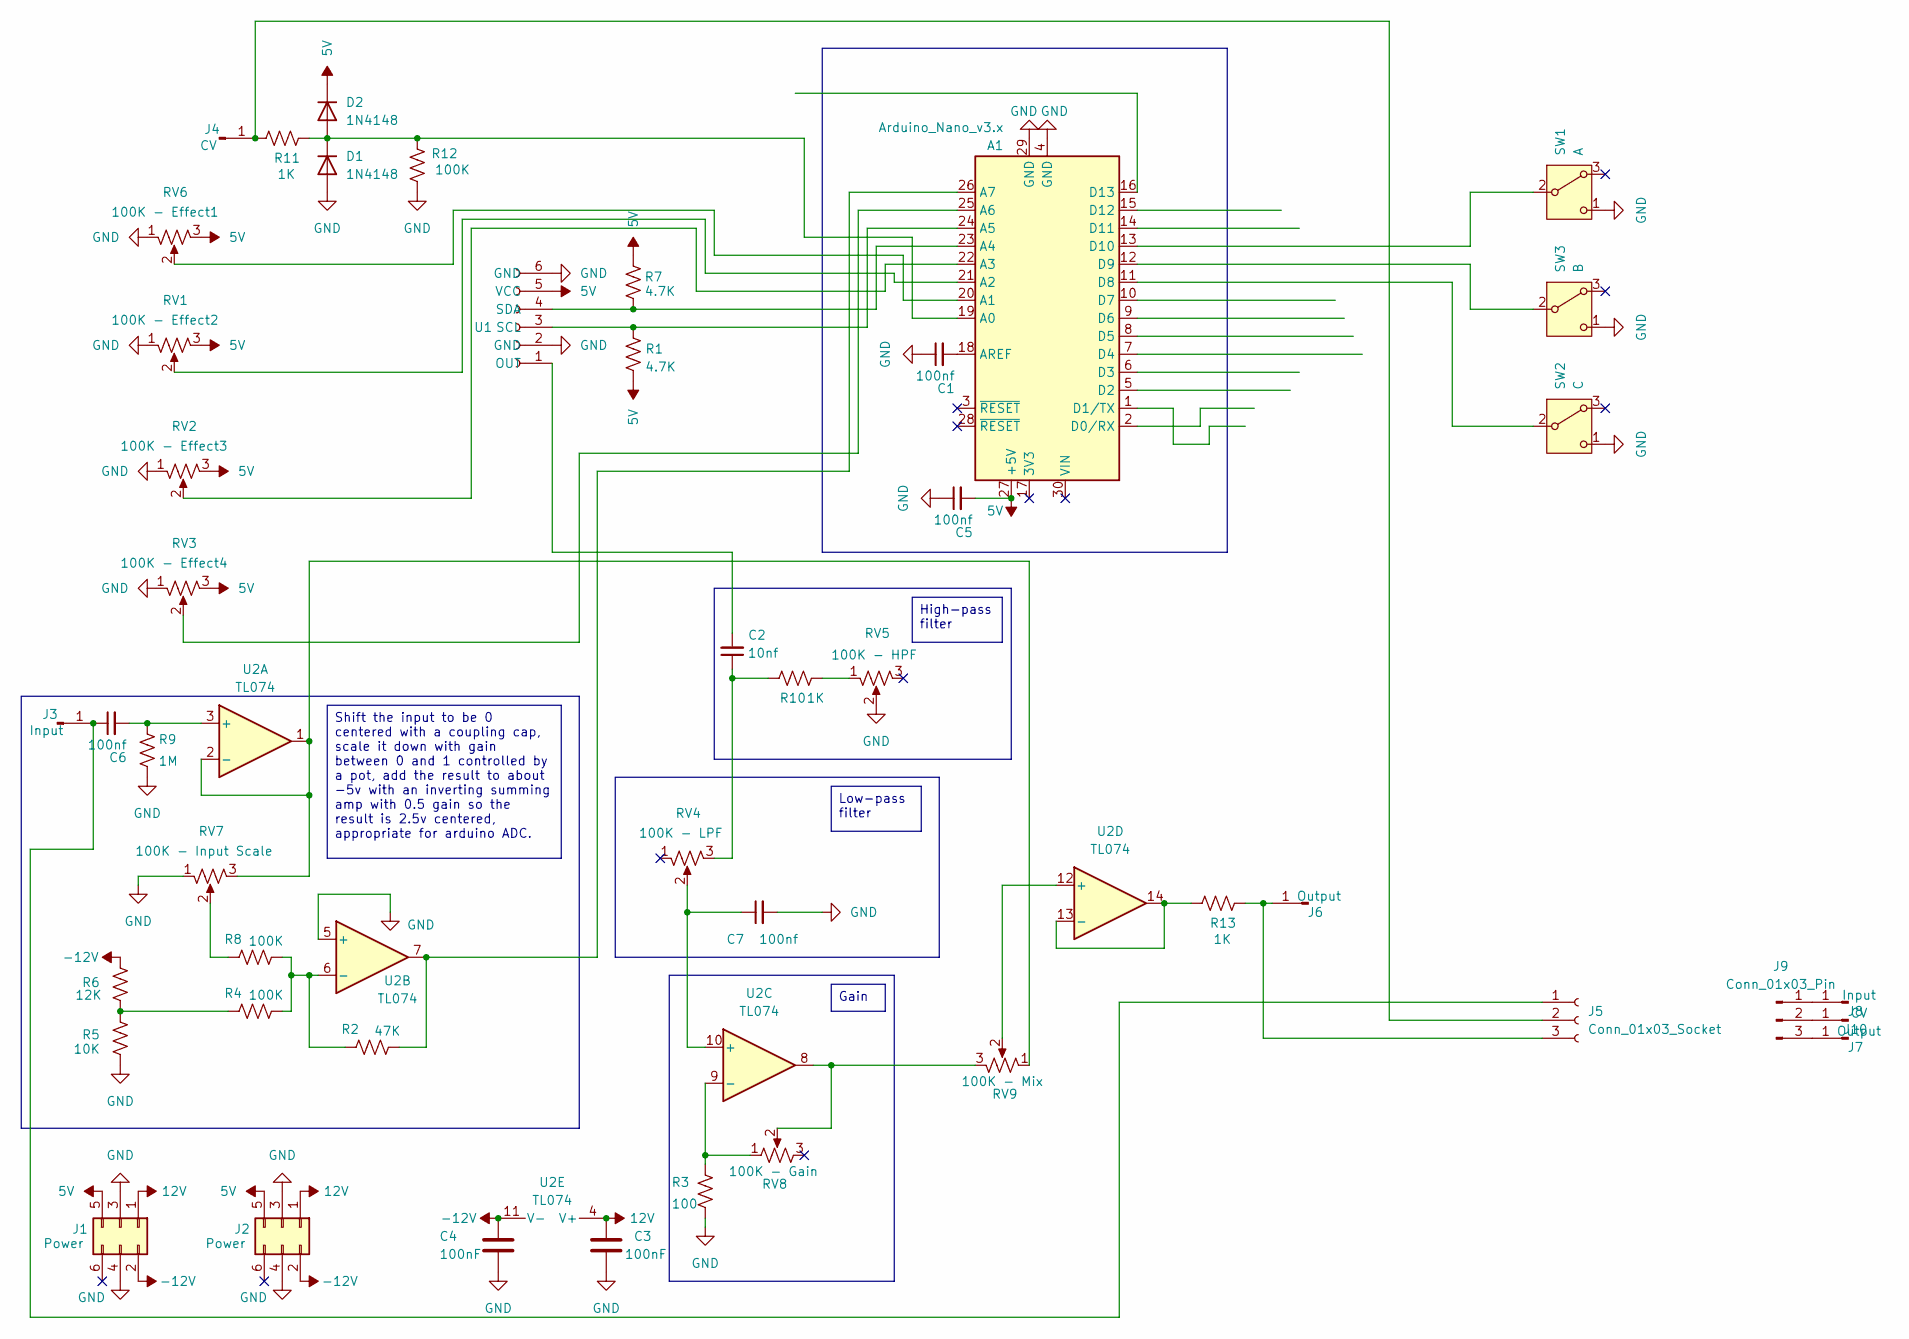
[picture p23: schematic arduino-delay.kicad_sch]

Parts:
A1: Arduino_Nano_v3.x; Arduino_Nano_sockets
C1, C5, C6, C7: 100nf; C_Disc_D4.3mm_W1.9mm_P5.00mm
C2: 10nf; C_Disc_D4.3mm_W1.9mm_P5.00mm
C3, C4: 100nF; C_Disc_D4.3mm_W1.9mm_P5.00mm
D1, D2: 1N4148; D_DO-35_SOD27_P7.62mm_Horizontal
J1, J2: Power; IDC-Header_2x03_P2.54mm_Vertical
J3, J8: Input; banana-jack
J4, J10: CV; banana-jack
J5: Conn_01x03_Socket; PinSocket_1x03_P2.54mm_Vertical
J6, J7: Output; banana-jack
J9: Conn_01x03_Pin; PinHeader_1x03_P2.54mm_Vertical
R1, R7: 4.7K; R_Axial_DIN0207_L6.3mm_D2.5mm_P10.16mm_Horizontal
R2: 47K; R_Axial_DIN0207_L6.3mm_D2.5mm_P10.16mm_Horizontal
R3: 100; R_Axial_DIN0207_L6.3mm_D2.5mm_P10.16mm_Horizontal
R4, R8, R12: 100K; R_Axial_DIN0207_L6.3mm_D2.5mm_P10.16mm_Horizontal
R5: 10K; R_Axial_DIN0207_L6.3mm_D2.5mm_P10.16mm_Horizontal
R6: 12K; R_Axial_DIN0207_L6.3mm_D2.5mm_P10.16mm_Horizontal
R9: 1M; R_Axial_DIN0207_L6.3mm_D2.5mm_P10.16mm_Horizontal
R10, R11, R13: 1K; R_Axial_DIN0207_L6.3mm_D2.5mm_P10.16mm_Horizontal
RV1: 100K - Effect2; Potentiometer_Alps_RK09K_Single_Vertical - knob padding
RV2: 100K - Effect3; Potentiometer_Alps_RK09K_Single_Vertical - knob padding
RV3: 100K - Effect4; Potentiometer_Alps_RK09K_Single_Vertical - knob padding
RV4: 100K - LPF; Potentiometer_Alps_RK09K_Single_Vertical - knob padding
RV5: 100K - HPF; Potentiometer_Alps_RK09K_Single_Vertical - knob padding
RV6: 100K - Effect1; Potentiometer_Alps_RK09K_Single_Vertical - knob padding
RV7: 100K - Input Scale; Potentiometer_Alps_RK09K_Single_Vertical - knob padding
RV8: 100K - Gain; Potentiometer_Alps_RK09K_Single_Vertical - knob padding
RV9: 100K - Mix; Potentiometer_Alps_RK09K_Single_Vertical - knob padding
SW1: A; switch1
SW2: C; switch1
SW3: B; switch1
U1: mcp4725_breakout
U2: TL074; DIP-14_W7.62mm_Socket

Connections:
5V: A1.27 (+5V), C5.2, D2.1 (K), J1.5, J2.5, R1.2, R7.2, RV1.3, RV2.3, RV3.3, RV6.3, U1.5 (VCC)
12V: C3.2, J1.1, J2.1, U2.4 (V+)
-12V: C4.2, J1.2, J2.2, R6.2, U2.11 (V-)
GND: A1.4 (GND), A1.29 (GND), C1.1, C3.1, C4.1, C5.1, C7.2, D1.2 (A), J1.3, J1.4, J2.3, J2.4, R3.1, R5.1, R9.2, R12.2, RV1.1, RV2.1, RV3.1, RV5.2, RV6.1, RV7.1, SW1.1 (C), SW2.1 (C), SW3.1 (C), U1.2 (GND), U1.6 (GND), U2.5 (+)
unnamed: A1.19 (A0), D1.1 (K), D2.2 (A), R11.1, R12.1
unnamed: A1.20 (A1), RV6.2
unnamed: A1.21 (A2), RV1.2
unnamed: A1.22 (A3), RV2.2
unnamed: A1.23 (A4), R7.1, U1.4 (SDA)
unnamed: A1.24 (A5), R1.1, U1.3 (SCL)
unnamed: A1.25 (A6), RV3.2
unnamed: A1.26 (A7), R2.2, U2.7
unnamed: A1.18 (AREF), C1.2
unnamed: A1.11 (D8), SW2.2 (B)
unnamed: A1.12 (D9), SW3.2 (B)
unnamed: A1.13 (D10), SW1.2 (B)
unnamed: C2.1, R10.2, RV4.3
unnamed: C6.1, J3.1, J5.1
unnamed: J4.1, J5.2, R11.2
unnamed: J5.3, J6.1, R13.1
unnamed: J7.1, J9.3
unnamed: J8.1, J9.1
unnamed: J9.2, J10.1
unnamed: R4.1, R5.2, R6.1
unnamed: R8.1, RV7.2
unnamed: R10.1, RV5.1
unnamed: RV8.2, RV9.3, U2.8
unnamed: C2.2, U1.1 (OUT)
unnamed: C6.2, R9.1, U2.3 (+)
unnamed: RV7.3, RV9.1, U2.1, U2.2 (-)
unnamed: R2.1, R4.2, R8.2, U2.6 (-)
unnamed: C7.1, RV4.2, U2.10 (+)
unnamed: R3.2, RV8.1, U2.9 (-)
unnamed: RV9.2, U2.12 (+)
unnamed: R13.2, U2.13 (-), U2.14

Notes on the sheet:
Shift the input to be 0 centered with a coupling cap, scale it down with gain between 0 and 1 controlled by a pot, add the result to about -5v with an inverting summing amp with 0.5 gain so the result is 2.5v centered, appropriate for arduino ADC.
High-pass filter
Gain
Low-pass filter

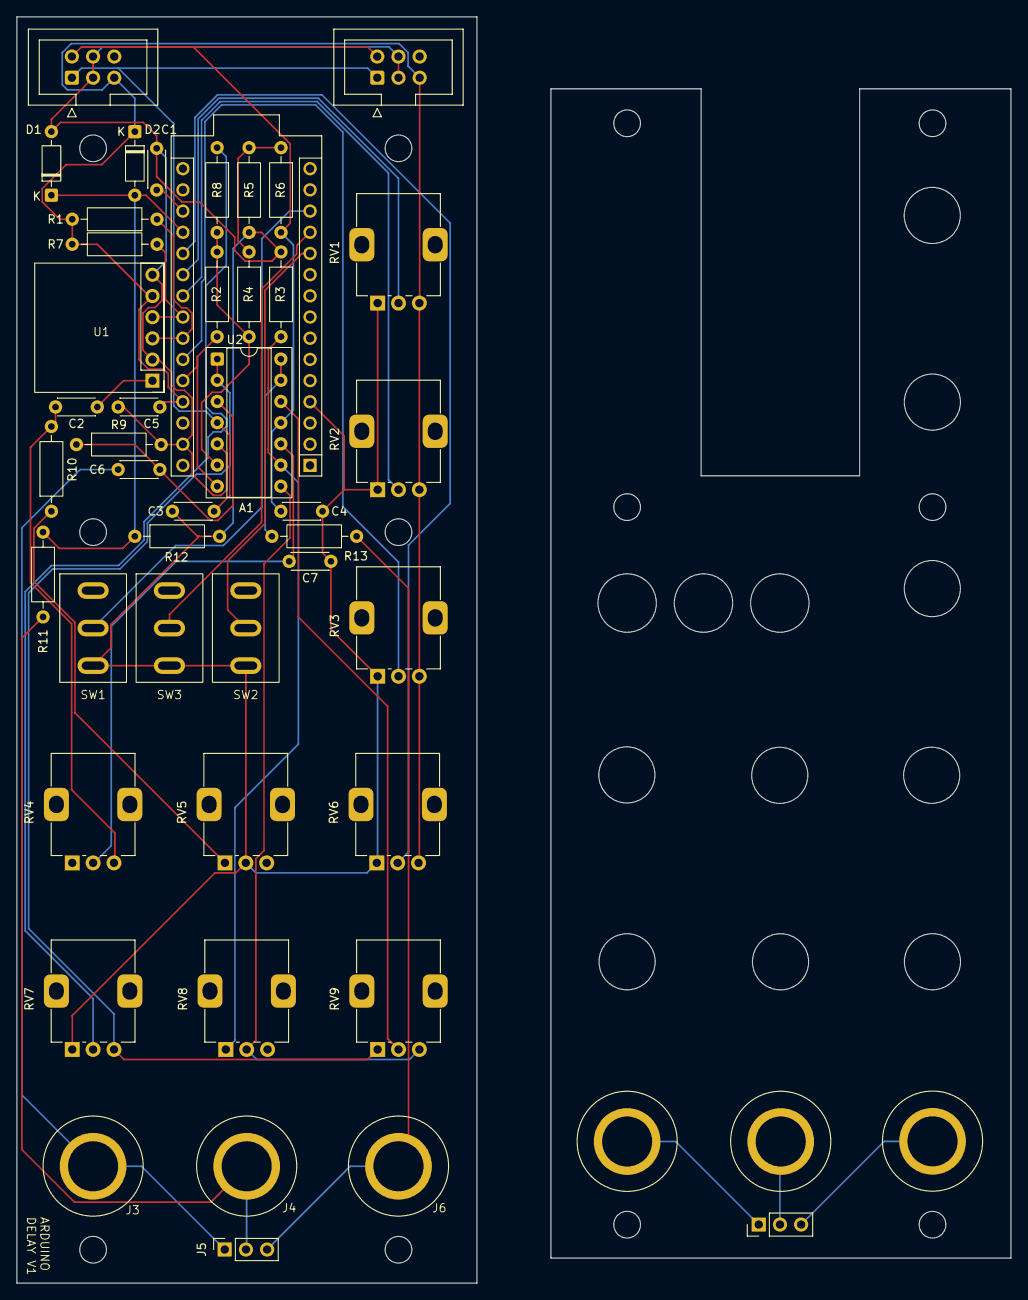
[picture p24: board arduino-delay.kicad_pcb from above]

Board: 2 copper layers, 55.1 x 151.8 mm, 47 parts (0 on the bottom side), 35 nets.
