gridbugs/modular2/cv-mixer/cv-mixer.kicad_pcb

## KiCad design cv-mixer/cv-mixer.kicad_pcb (2026-07-05)

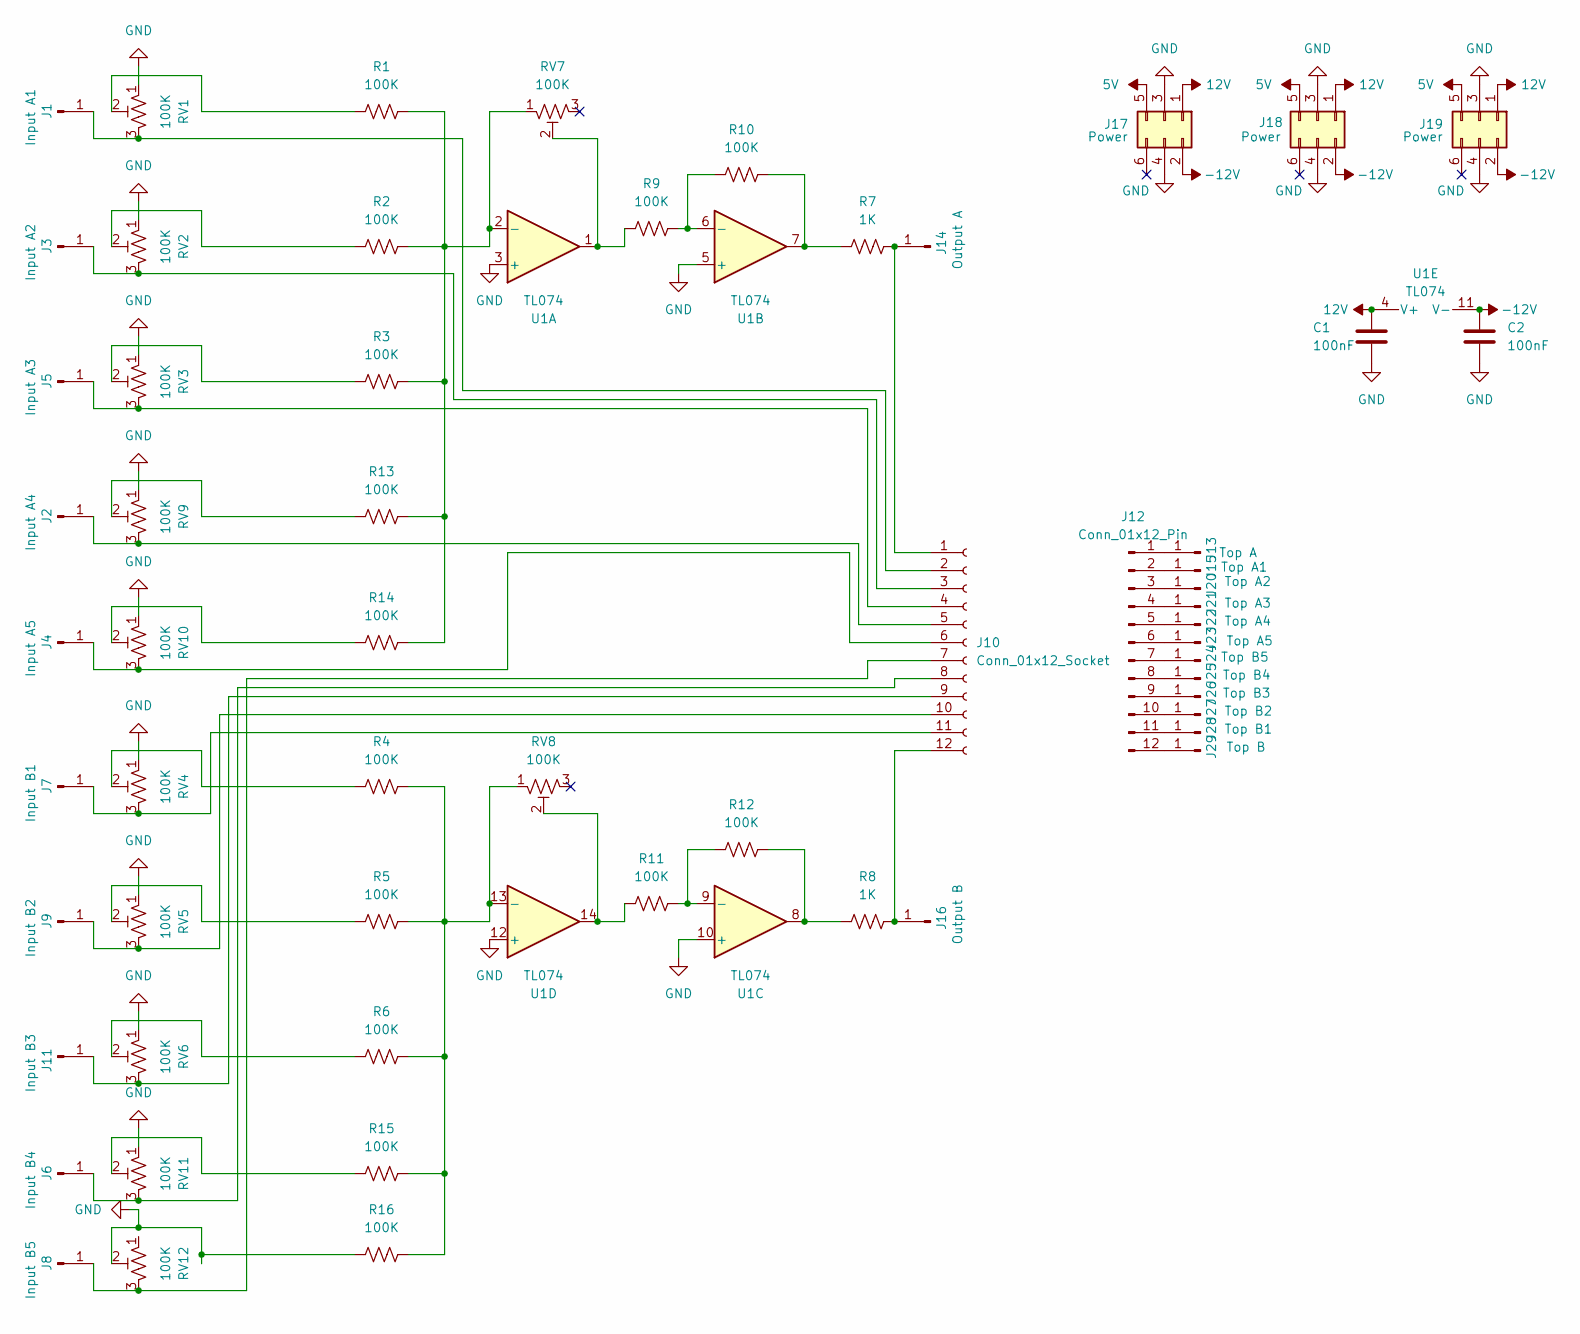
[picture p25: schematic cv-mixer.kicad_sch]

Parts:
C1, C2: 100nF; C_Disc_D4.3mm_W1.9mm_P5.00mm
J1: Input A1; banana-jack
J2: Input A4; banana-jack
J3: Input A2; banana-jack
J4: Input A5; banana-jack
J5: Input A3; banana-jack
J6: Input B4; banana-jack
J7: Input B1; banana-jack
J8: Input B5; banana-jack
J9: Input B2; banana-jack
J10: Conn_01x12_Socket; PinSocket_1x12_P2.54mm_Vertical
J11: Input B3; banana-jack
J12: Conn_01x12_Pin; PinHeader_1x12_P2.54mm_Vertical
J13: Top A; banana-jack
J14: Output A; banana-jack
J15: Top A1; banana-jack
J16: Output B; banana-jack
J17, J18, J19: Power; IDC-Header_2x03_P2.54mm_Vertical
J20: Top A2; banana-jack
J21: Top A3; banana-jack
J22: Top A4; banana-jack
J23: Top A5; banana-jack
J24: Top B5; banana-jack
J25: Top B4; banana-jack
J26: Top B3; banana-jack
J27: Top B2; banana-jack
J28: Top B1; banana-jack
J29: Top B; banana-jack
R1, R2, R3, R4, R5, R6, R9, R10, R11, R12, R13, R14, R15, R16: 100K; R_Axial_DIN0207_L6.3mm_D2.5mm_P10.16mm_Horizontal
R7, R8: 1K; R_Axial_DIN0207_L6.3mm_D2.5mm_P10.16mm_Horizontal
RV1, RV2, RV3, RV4, RV5, RV6, RV7, RV8, RV9, RV10, RV11, RV12: 100K; Potentiometer_Alps_RK09K_Single_Vertical - knob padding
U1: TL074; DIP-14_W7.62mm_Socket

Connections:
5V: J17.5, J18.5, J19.5
12V: C1.2, J17.1, J18.1, J19.1, U1.4 (V+)
-12V: C2.2, J17.2, J18.2, J19.2, U1.11 (V-)
GND: C1.1, C2.1, J17.3, J17.4, J18.3, J18.4, J19.3, J19.4, R16.1, RV1.1, RV2.1, RV3.1, RV4.1, RV5.1, RV6.1, RV9.1, RV10.1, RV11.1, RV12.2, U1.3 (+), U1.5 (+), U1.10 (+), U1.12 (+)
unnamed: J1.1, J10.2, RV1.3
unnamed: J10.1, J14.1, R7.2
unnamed: J3.1, J10.3, RV2.3
unnamed: J5.1, J10.4, RV3.3
unnamed: J2.1, J10.5, RV9.3
unnamed: J4.1, J10.6, RV10.3
unnamed: J8.1, J10.7, RV12.3
unnamed: J6.1, J10.8, RV11.3
unnamed: J10.9, J11.1, RV6.3
unnamed: J9.1, J10.10, RV5.3
unnamed: J7.1, J10.11, RV4.3
unnamed: J10.12, J16.1, R8.2
unnamed: J12.1, J13.1
unnamed: J12.2, J15.1
unnamed: J12.3, J20.1
unnamed: J12.4, J21.1
unnamed: J12.5, J22.1
unnamed: J12.6, J23.1
unnamed: J12.7, J24.1
unnamed: J12.8, J25.1
unnamed: J12.9, J26.1
unnamed: J12.10, J27.1
unnamed: J12.11, J28.1
unnamed: J12.12, J29.1
unnamed: R1.1, RV1.2
unnamed: R2.1, RV2.2
unnamed: R3.1, RV3.2
unnamed: R4.1, RV4.2
unnamed: R5.1, RV5.2
unnamed: R6.1, RV6.2
unnamed: R9.1, RV7.2, U1.1
unnamed: R7.1, R10.2, U1.7
unnamed: R11.1, RV8.2, U1.14
unnamed: R8.1, R12.2, U1.8
unnamed: R13.1, RV9.2
unnamed: R14.1, RV10.2
unnamed: R15.1, RV11.2
unnamed: R1.2, R2.2, R3.2, R13.2, R14.2, RV7.1, U1.2 (-)
unnamed: R9.2, R10.1, U1.6 (-)
unnamed: R11.2, R12.1, U1.9 (-)
unnamed: R4.2, R5.2, R6.2, R15.2, R16.2, RV8.1, U1.13 (-)

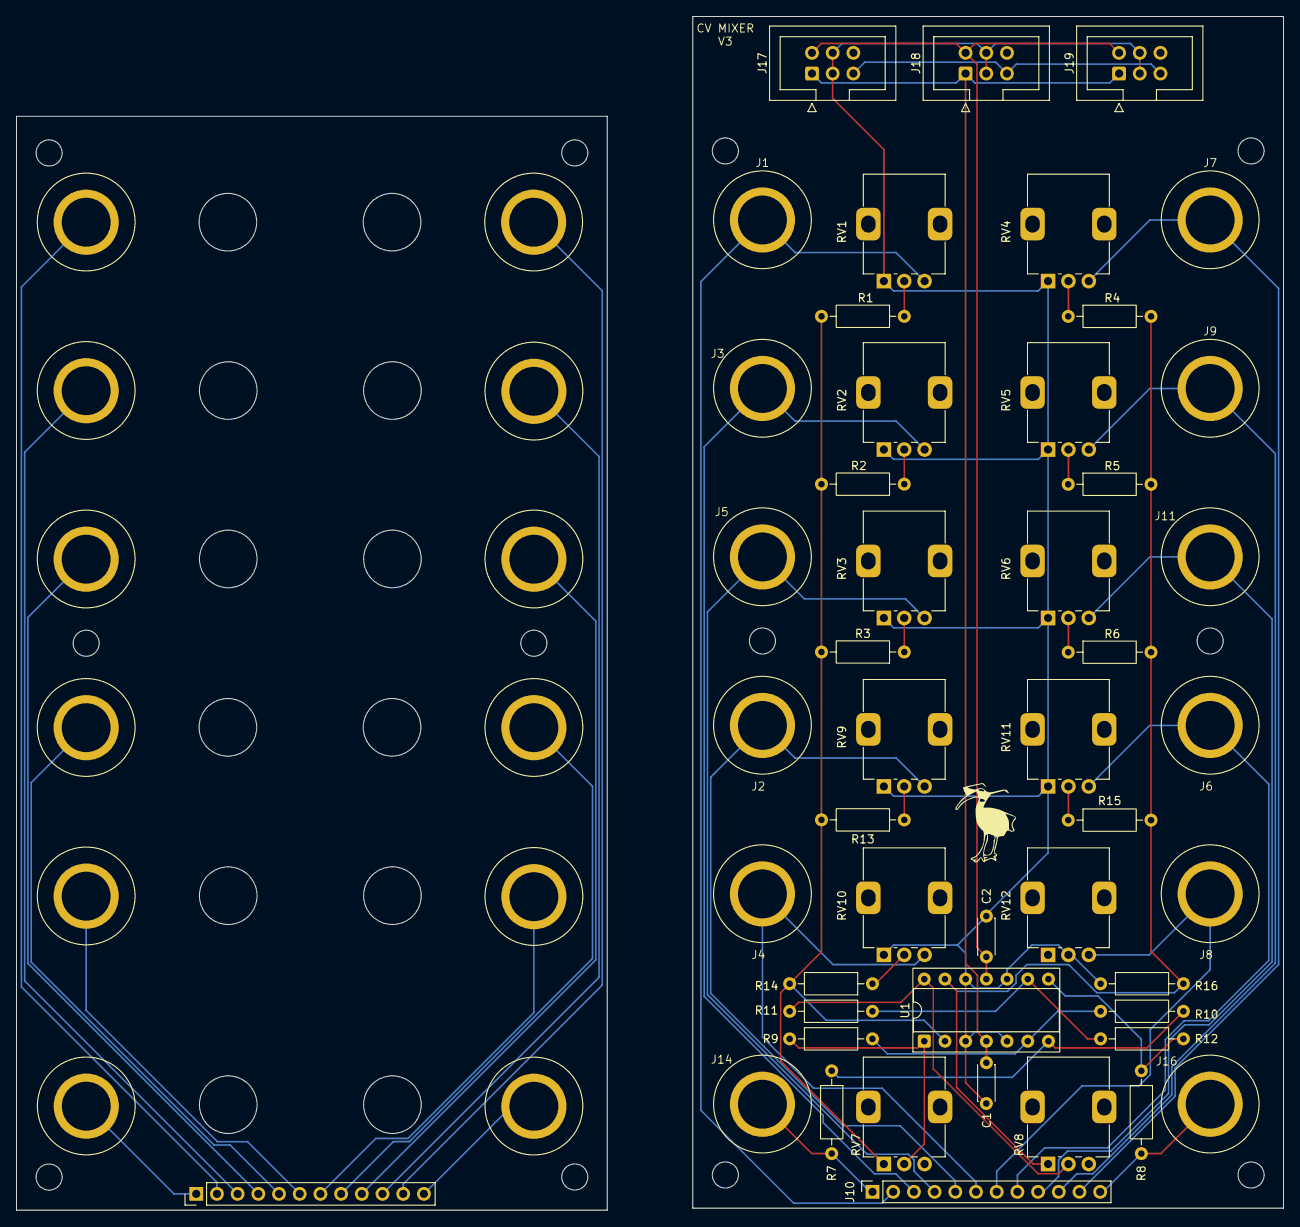
[picture p26: board cv-mixer.kicad_pcb from above]

Board: 2 copper layers, 155.5 x 146.5 mm, 60 parts (0 on the bottom side), 45 nets.
