gridbugs/modular2/audio-mixer/audio-mixer.kicad_pcb

## KiCad design audio-mixer/audio-mixer.kicad_pcb (2026-07-03)

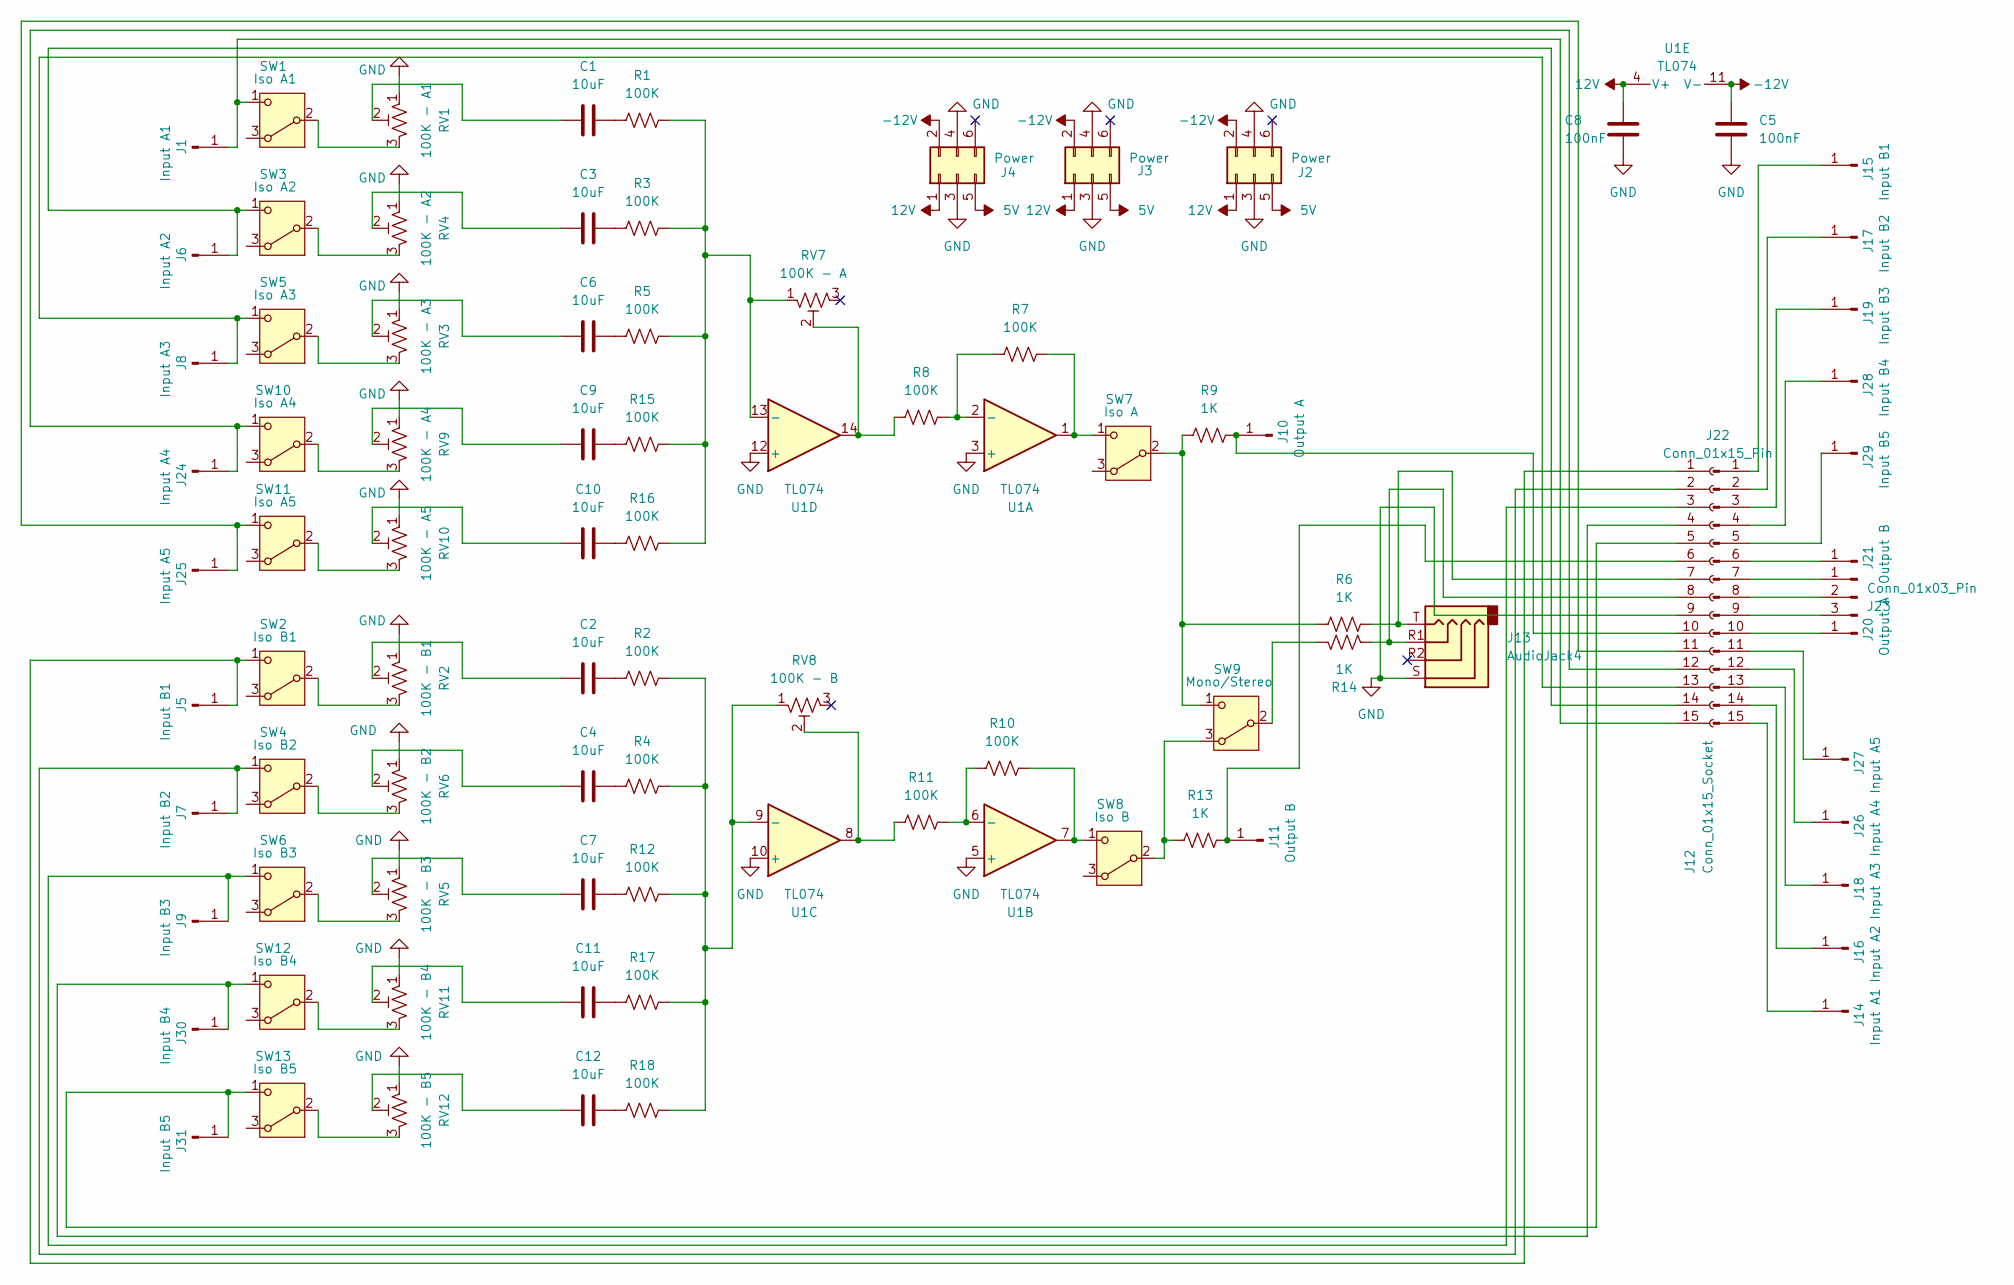
[picture p27: schematic audio-mixer.kicad_sch]

Parts:
C1, C2, C3, C4, C6, C7, C9, C10, C11, C12: 10uF; C_Disc_D4.3mm_W1.9mm_P5.00mm
C5, C8: 100nF; C_Disc_D4.3mm_W1.9mm_P5.00mm
J1, J14: Input A1; banana-jack
J2, J3, J4: Power; IDC-Header_2x03_P2.54mm_Vertical
J5, J15: Input B1; banana-jack
J6, J16: Input A2; banana-jack
J7, J17: Input B2; banana-jack
J8, J18: Input A3; banana-jack
J9, J19: Input B3; banana-jack
J10, J20: Output A; banana-jack
J11, J21: Output B; banana-jack
J12: Conn_01x15_Socket; PinSocket_1x15_P2.54mm_Vertical
J13: AudioJack4; audio jack breakout
J22: Conn_01x15_Pin; PinHeader_1x15_P2.54mm_Vertical
J23: Conn_01x03_Pin; PinHeader_1x03_P2.54mm_Vertical
J24, J26: Input A4; banana-jack
J25, J27: Input A5; banana-jack
J28, J30: Input B4; banana-jack
J29, J31: Input B5; banana-jack
R1, R2, R3, R4, R5, R7, R8, R10, R11, R12, R15, R16, R17, R18: 100K; R_Axial_DIN0207_L6.3mm_D2.5mm_P10.16mm_Horizontal
R6, R9, R13, R14: 1K; R_Axial_DIN0207_L6.3mm_D2.5mm_P10.16mm_Horizontal
RV1: 100K - A1; Potentiometer_Alps_RK09K_Single_Vertical - knob padding
RV2: 100K - B1; Potentiometer_Alps_RK09K_Single_Vertical - knob padding
RV3: 100K - A3; Potentiometer_Alps_RK09K_Single_Vertical - knob padding
RV4: 100K - A2; Potentiometer_Alps_RK09K_Single_Vertical - knob padding
RV5: 100K - B3; Potentiometer_Alps_RK09K_Single_Vertical - knob padding
RV6: 100K - B2; Potentiometer_Alps_RK09K_Single_Vertical - knob padding
RV7: 100K - A; Potentiometer_Alps_RK09K_Single_Vertical - knob padding
RV8: 100K - B; Potentiometer_Alps_RK09K_Single_Vertical - knob padding
RV9: 100K - A4; Potentiometer_Alps_RK09K_Single_Vertical - knob padding
RV10: 100K - A5; Potentiometer_Alps_RK09K_Single_Vertical - knob padding
RV11: 100K - B4; Potentiometer_Alps_RK09K_Single_Vertical - knob padding
RV12: 100K - B5; Potentiometer_Alps_RK09K_Single_Vertical - knob padding
SW1: Iso A1; switch1
SW2: Iso B1; switch1
SW3: Iso A2; switch1
SW4: Iso B2; switch1
SW5: Iso A3; switch1
SW6: Iso B3; switch1
SW7: Iso A; switch1
SW8: Iso B; switch1
SW9: Mono/Stereo; switch1
SW10: Iso A4; switch1
SW11: Iso A5; switch1
SW12: Iso B4; switch1
SW13: Iso B5; switch1
U1: TL074; DIP-14_W7.62mm_Socket

Connections:
5V: J2.5, J3.5, J4.5
12V: C8.2, J2.1, J3.1, J4.1, U1.4 (V+)
-12V: C5.2, J2.2, J3.2, J4.2, U1.11 (V-)
GND: C5.1, C8.1, J2.3, J2.4, J3.3, J3.4, J4.3, J4.4, J12.9, J13.S, RV1.1, RV2.1, RV3.1, RV4.1, RV5.1, RV6.1, RV9.1, RV10.1, RV11.1, RV12.1, U1.3 (+), U1.5 (+), U1.10 (+), U1.12 (+)
unnamed: C1.1, RV1.2
unnamed: C1.2, R1.1
unnamed: C2.1, RV2.2
unnamed: C2.2, R2.1
unnamed: C3.1, RV4.2
unnamed: C3.2, R3.1
unnamed: C4.1, RV6.2
unnamed: C4.2, R4.1
unnamed: C6.1, RV3.2
unnamed: C6.2, R5.1
unnamed: C7.1, RV5.2
unnamed: C7.2, R12.1
unnamed: C9.1, RV9.2
unnamed: C9.2, R15.1
unnamed: C10.1, RV10.2
unnamed: C10.2, R16.1
unnamed: C11.1, RV11.2
unnamed: C11.2, R17.1
unnamed: C12.1, RV12.2
unnamed: C12.2, R18.1
unnamed: J1.1 (Pin_1_1), J12.15, SW1.1 (C)
unnamed: J10.1 (Pin_1_1), J12.10, R9.2
unnamed: J11.1 (Pin_1_1), J12.6, R13.2
unnamed: J5.1 (Pin_1_1), J12.1, SW2.1 (C)
unnamed: J7.1 (Pin_1_1), J12.2, SW4.1 (C)
unnamed: J9.1 (Pin_1_1), J12.3, SW6.1 (C)
unnamed: J12.4, J30.1 (Pin_1_1), SW12.1 (C)
unnamed: J12.5, J31.1 (Pin_1_1), SW13.1 (C)
unnamed: J12.7, J13.T, R6.2
unnamed: J12.8, J13.R1, R14.2
unnamed: J12.11, J25.1 (Pin_1_1), SW11.1 (C)
unnamed: J12.12, J24.1 (Pin_1_1), SW10.1 (C)
unnamed: J8.1 (Pin_1_1), J12.13, SW5.1 (C)
unnamed: J6.1 (Pin_1_1), J12.14, SW3.1 (C)
unnamed: J14.1 (Pin_1_1), J22.15
unnamed: J15.1 (Pin_1_1), J22.1
unnamed: J16.1 (Pin_1_1), J22.14
unnamed: J17.1 (Pin_1_1), J22.2
unnamed: J18.1 (Pin_1_1), J22.13
unnamed: J19.1 (Pin_1_1), J22.3
unnamed: J20.1 (Pin_1_1), J22.10
unnamed: J21.1 (Pin_1_1), J22.6
unnamed: J22.4, J28.1 (Pin_1_1)
unnamed: J22.5, J29.1 (Pin_1_1)
unnamed: J22.7, J23.1
unnamed: J22.8, J23.2
unnamed: J22.9, J23.3
unnamed: J22.11, J27.1 (Pin_1_1)
unnamed: J22.12, J26.1 (Pin_1_1)
unnamed: R8.1, RV7.2, U1.14
unnamed: R11.1, RV8.2, U1.8
unnamed: RV1.3, SW1.2 (B)
unnamed: RV2.3, SW2.2 (B)
unnamed: RV4.3, SW3.2 (B)
unnamed: RV6.3, SW4.2 (B)
unnamed: RV3.3, SW5.2 (B)
unnamed: RV5.3, SW6.2 (B)
unnamed: R6.1, R9.1, SW7.2 (B), SW9.1 (C)
unnamed: R7.2, SW7.1 (C), U1.1
unnamed: R13.1, SW8.2 (B), SW9.3 (A)
unnamed: R10.2, SW8.1 (C), U1.7
unnamed: R14.1, SW9.2 (B)
unnamed: RV9.3, SW10.2 (B)
unnamed: RV10.3, SW11.2 (B)
unnamed: RV11.3, SW12.2 (B)
unnamed: RV12.3, SW13.2 (B)
unnamed: R7.1, R8.2, U1.2 (-)
unnamed: R10.1, R11.2, U1.6 (-)
unnamed: R2.2, R4.2, R12.2, R17.2, R18.2, RV8.1, U1.9 (-)
unnamed: R1.2, R3.2, R5.2, R15.2, R16.2, RV7.1, U1.13 (-)

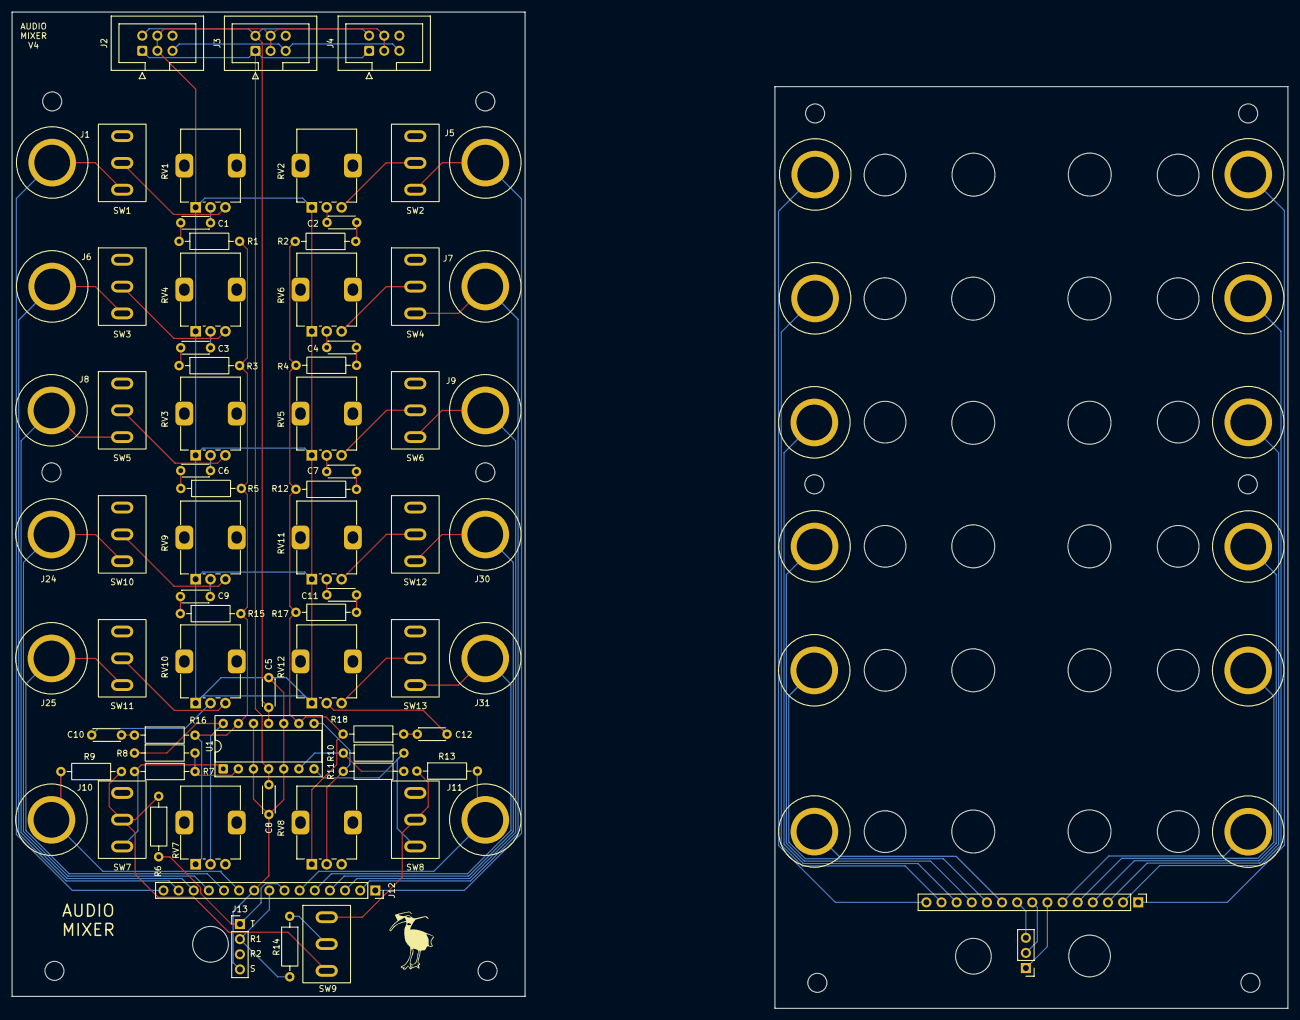
[picture p28: board audio-mixer.kicad_pcb from above]

Board: 2 copper layers, 86.1 x 165.2 mm, 87 parts (0 on the bottom side), 74 nets.
