gridbugs/modular2/pattern-sequencer/pattern-sequencer.kicad_pcb

## KiCad design pattern-sequencer/pattern-sequencer.kicad_pcb (2026-06-13)

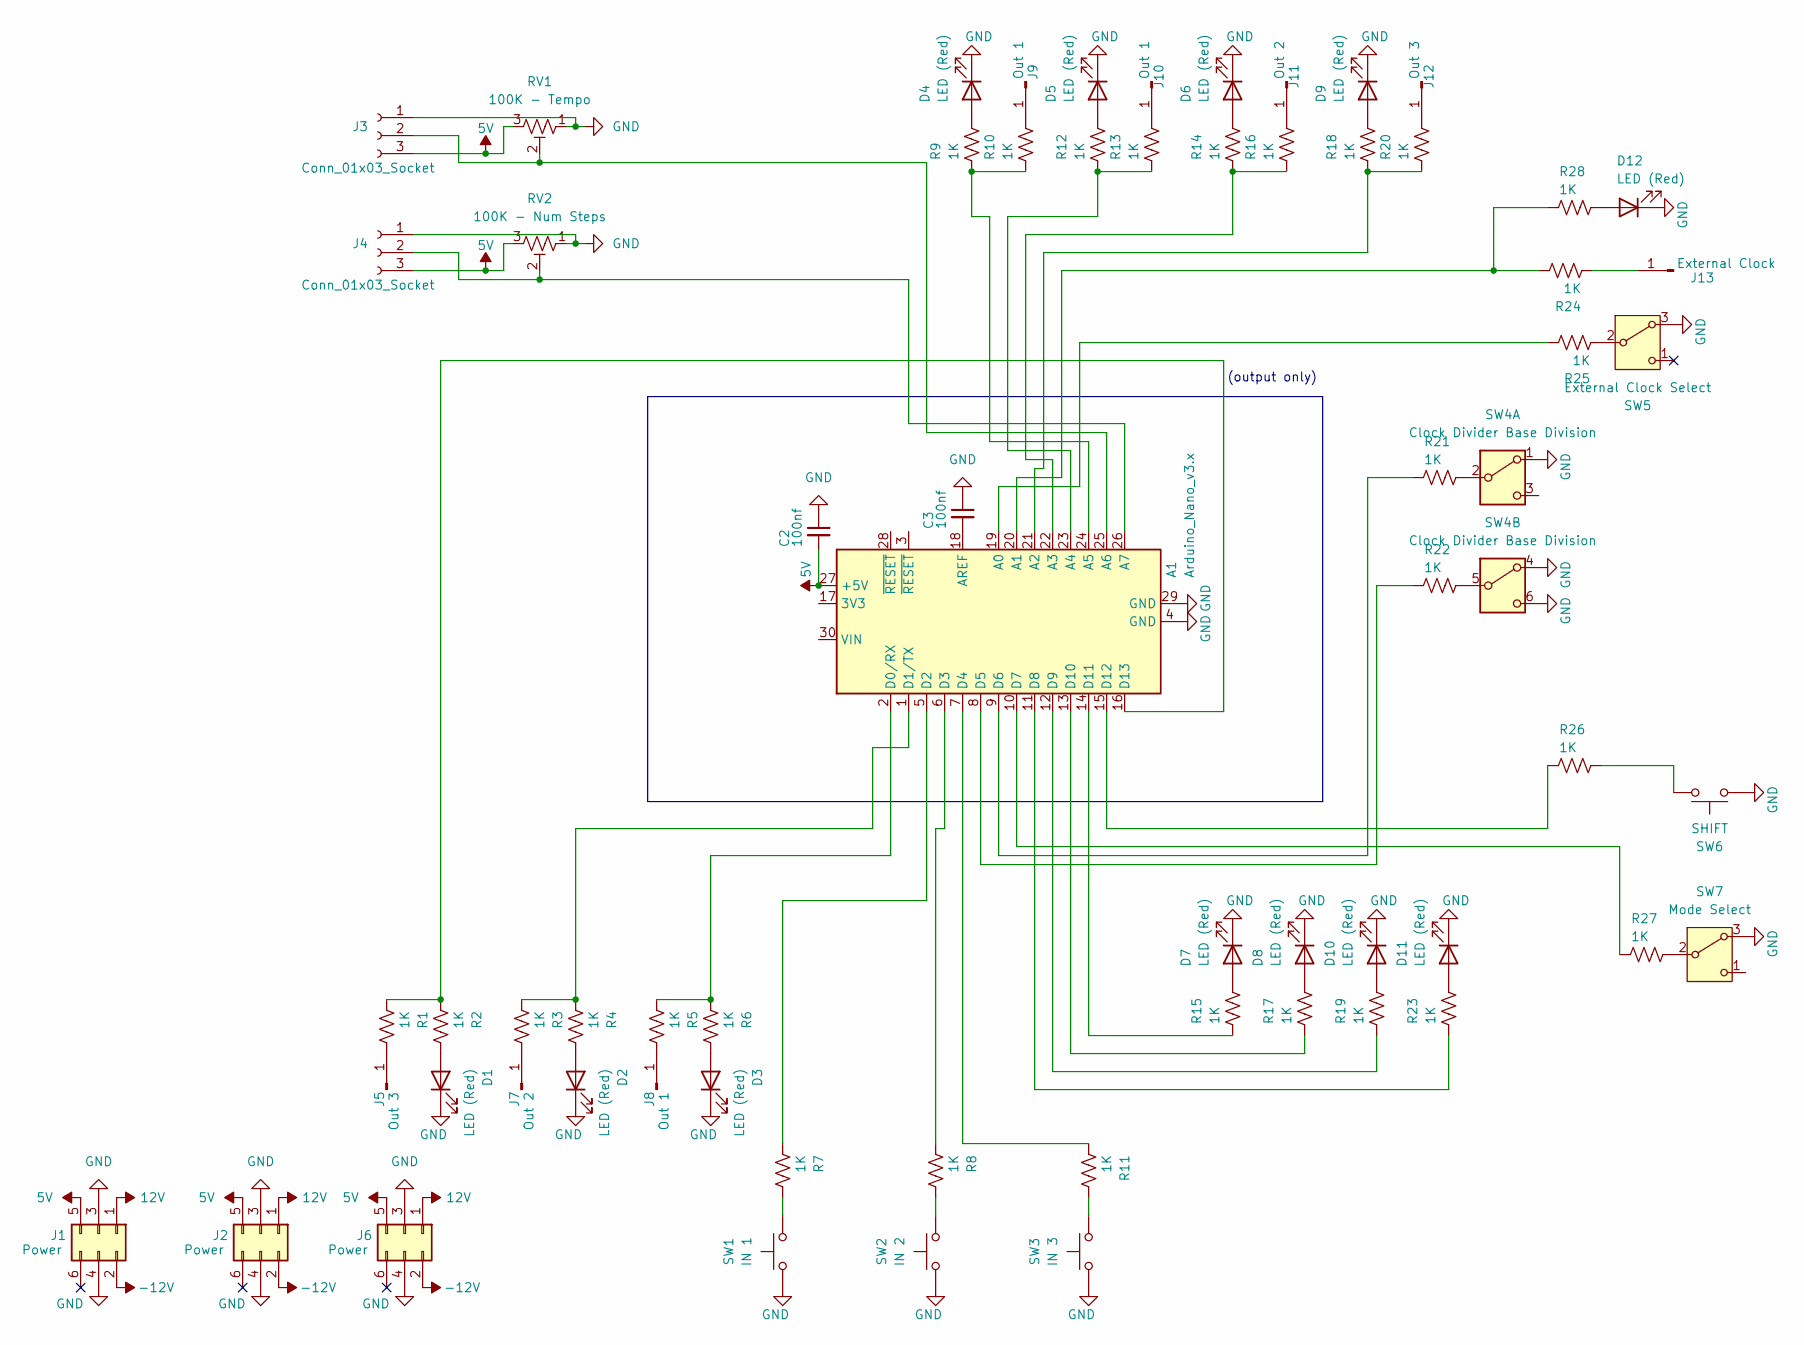
[picture p29: schematic pattern-sequencer.kicad_sch]

Parts:
A1: Arduino_Nano_v3.x; Arduino_Nano
C2, C3: 100nf; C_Disc_D4.3mm_W1.9mm_P5.00mm
D1, D2, D3, D4, D5, D6, D7, D8, D9, D10, D11, D12: LED (Red); LED_D5.0mm
J1, J2, J6: Power; IDC-Header_2x03_P2.54mm_Vertical
J3, J4: Conn_01x03_Socket; pot
J5, J12: Out 3; banana-jack
J7, J11: Out 2; banana-jack
J8, J9, J10: Out 1; banana-jack
J13: External Clock; banana-jack
R1, R2, R3, R4, R5, R6, R7, R8, R9, R10, R11, R12, R13, R14, R15, R16, R17, R18, R19, R20, R21, R22, R23, R24, R25, R26, R27, R28: 1K; R_Axial_DIN0207_L6.3mm_D2.5mm_P10.16mm_Horizontal
RV1: 100K - Tempo; pot-socket
RV2: 100K - Num Steps; pot-socket
SW1: IN 1; SW_Cherry_MX_1.00u_PCB
SW2: IN 2; SW_Cherry_MX_1.00u_PCB
SW3: IN 3; SW_Cherry_MX_1.00u_PCB
SW4: Clock Divider Base Division; switch2
SW5: External Clock Select; switch1
SW6: SHIFT; SW_Cherry_MX_1.00u_PCB
SW7: Mode Select; switch1

Connections:
5V: A1.27 (+5V), C2.2, J1.5, J2.5, J3.3, J4.3, J6.5, RV1.3, RV2.3
12V: J1.1, J2.1, J6.1
-12V: J1.2, J2.2, J6.2
GND: A1.4 (GND), A1.29 (GND), C2.1, C3.1, D1.1 (K), D2.1 (K), D3.1 (K), D4.1 (K), D5.1 (K), D6.1 (K), D7.1 (K), D8.1 (K), D9.1 (K), D10.1 (K), D11.1 (K), D12.1 (K), J1.3, J1.4, J2.3, J2.4, J3.1, J4.1, J6.3, J6.4, RV1.1, RV2.1, SW1.1, SW2.1, SW3.1, SW4.1 (A), SW4.4 (A), SW4.6 (C), SW5.3 (A), SW6.1, SW7.3 (A)
unnamed: A1.19 (A0), R25.1
unnamed: A1.20 (A1), R24.1, R28.2
unnamed: A1.21 (A2), R18.2, R20.2
unnamed: A1.22 (A3), R14.2, R16.2
unnamed: A1.23 (A4), R12.2, R13.2
unnamed: A1.24 (A5), R9.2, R10.2
unnamed: A1.25 (A6), J3.2, RV1.2
unnamed: A1.26 (A7), J4.2, RV2.2
unnamed: A1.18 (AREF), C3.2
unnamed: A1.2 (D0/RX), R5.2, R6.2
unnamed: A1.1 (D1/TX), R3.2, R4.2
unnamed: A1.5 (D2), R7.2
unnamed: A1.6 (D3), R8.2
unnamed: A1.7 (D4), R11.2
unnamed: A1.8 (D5), R22.2
unnamed: A1.9 (D6), R21.2
unnamed: A1.10 (D7), R27.2
unnamed: A1.11 (D8), R23.2
unnamed: A1.12 (D9), R19.2
unnamed: A1.13 (D10), R17.2
unnamed: A1.14 (D11), R15.2
unnamed: A1.15 (D12), R26.2
unnamed: A1.16 (D13), R1.2, R2.2
unnamed: D1.2 (A), R2.1
unnamed: D2.2 (A), R4.1
unnamed: D3.2 (A), R6.1
unnamed: D4.2 (A), R9.1
unnamed: D5.2 (A), R12.1
unnamed: D6.2 (A), R14.1
unnamed: D7.2 (A), R15.1
unnamed: D8.2 (A), R17.1
unnamed: D9.2 (A), R18.1
unnamed: D10.2 (A), R19.1
unnamed: D11.2 (A), R23.1
unnamed: D12.2 (A), R28.1
unnamed: J5.1 (Pin_1_1), R1.1
unnamed: J7.1 (Pin_1_1), R3.1
unnamed: J8.1 (Pin_1_1), R5.1
unnamed: J9.1 (Pin_1_1), R10.1
unnamed: J10.1 (Pin_1_1), R13.1
unnamed: J11.1 (Pin_1_1), R16.1
unnamed: J12.1 (Pin_1_1), R20.1
unnamed: J13.1 (Pin_1_1), R24.2
unnamed: R7.1, SW1.2
unnamed: R8.1, SW2.2
unnamed: R11.1, SW3.2
unnamed: R26.1, SW6.2
unnamed: R21.1, SW4.2 (B)
unnamed: R22.1, SW4.5 (B)
unnamed: R25.2, SW5.2 (B)
unnamed: R27.1, SW7.2 (B)

Notes on the sheet:
(output only)
