gridbugs/modular2/pattern-sequencer/pattern-sequencer.kicad_pcb

## KiCad design pattern-sequencer/pattern-sequencer.kicad_pcb (continued)

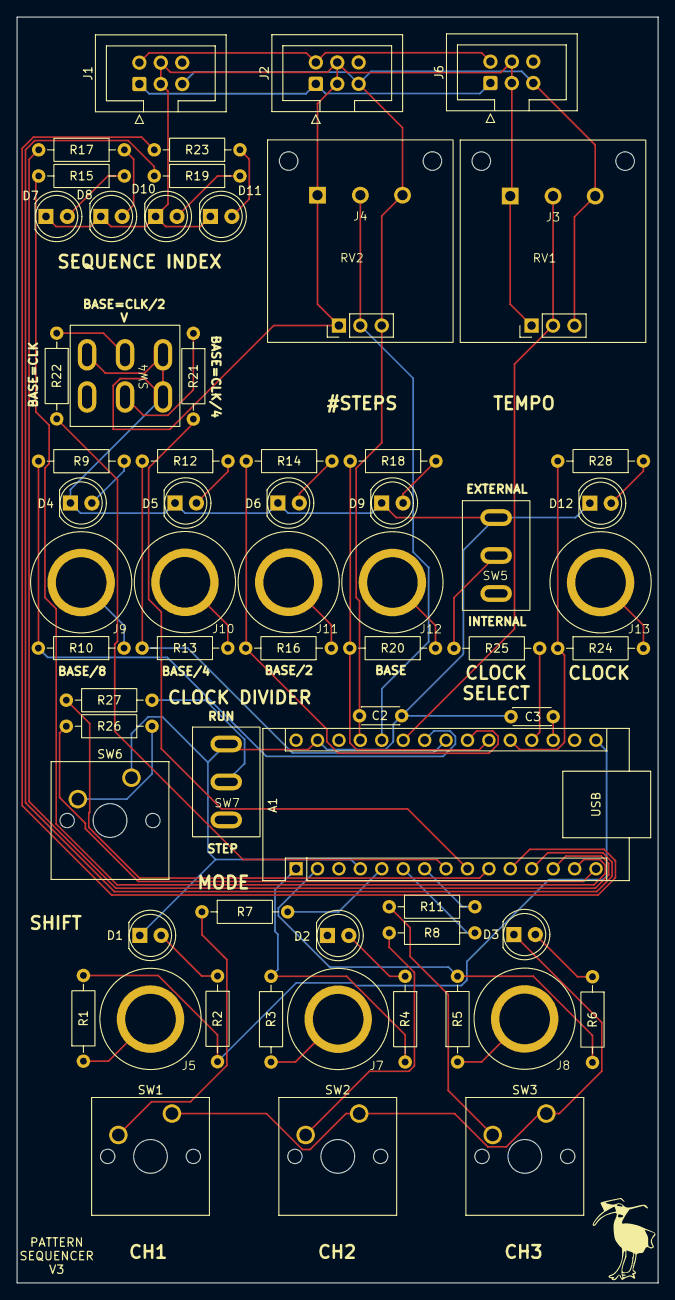
[picture p30: board pattern-sequencer.kicad_pcb from above]

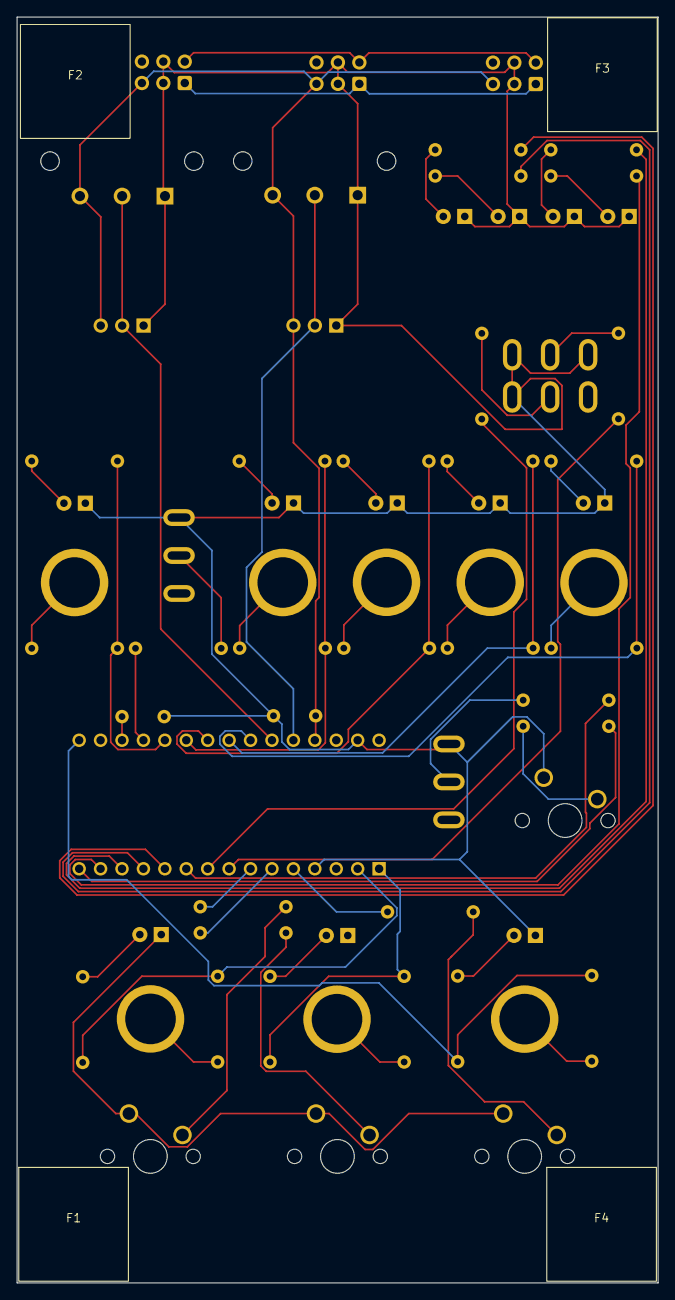
[picture p31: board pattern-sequencer.kicad_pcb from below]

Board: 2 copper layers, 76.0 x 150.1 mm, 69 parts (4 on the bottom side), 55 nets.

Other parts of the board:
F1, F2, F3, F4: foot
