gridbugs/modular2/gate-sequencer/gate-sequencer.kicad_pcb

## KiCad design gate-sequencer/gate-sequencer.kicad_pcb (2026-06-07)

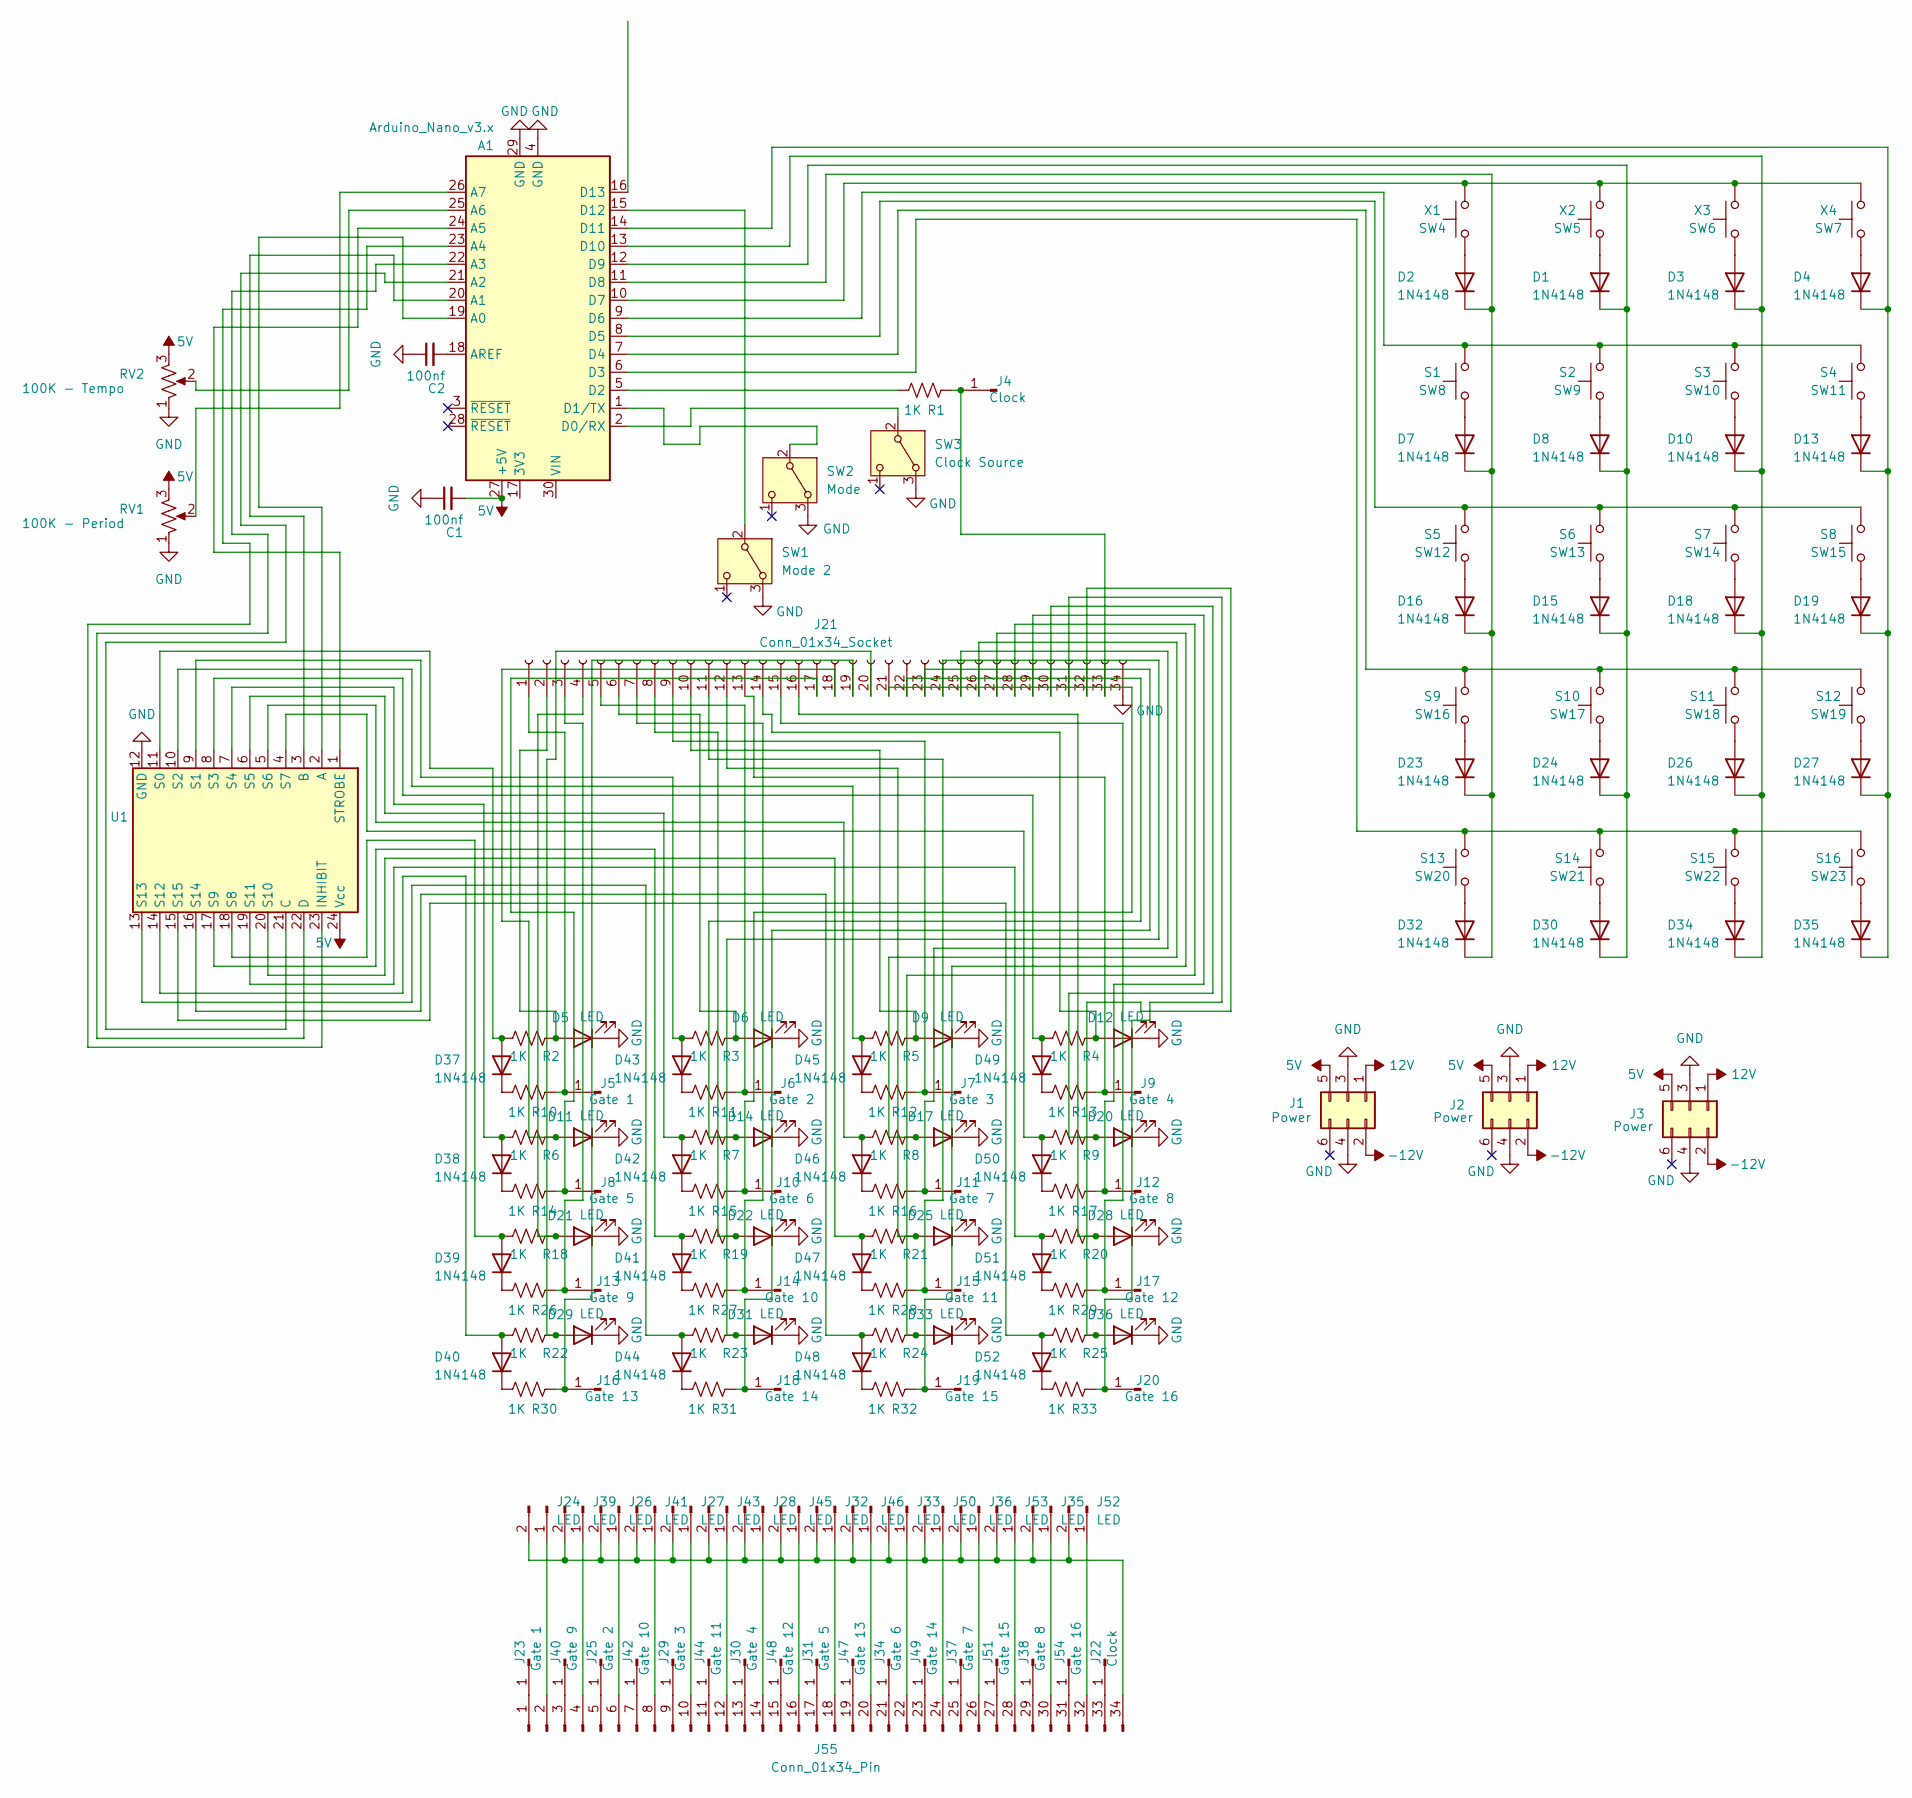
[picture p32: schematic gate-sequencer.kicad_sch]

Parts:
A1: Arduino_Nano_v3.x; Arduino_Nano
C1, C2: 100nf; C_Disc_D4.3mm_W1.9mm_P5.00mm
D1, D2, D3, D4, D7, D8, D10, D13, D15, D16, D18, D19, D23, D24, D26, D27, D30, D32, D34, D35, D37, D38, D39, D40, D41, D42, D43, D44, D45, D46, D47, D48, D49, D50, D51, D52: 1N4148; D_DO-35_SOD27_P7.62mm_Horizontal
D5, D6, D9, D11, D12, D14, D17, D20, D21, D22, D25, D28, D29, D31, D33, D36: LED; LED_D5.0mm
J1, J2, J3: Power; IDC-Header_2x03_P2.54mm_Vertical
J4, J22: Clock; banana-jack
J5, J23: Gate 1; banana-jack
J6, J25: Gate 2; banana-jack
J7, J29: Gate 3; banana-jack
J8, J31: Gate 5; banana-jack
J9, J30: Gate 4; banana-jack
J10, J34: Gate 6; banana-jack
J11, J37: Gate 7; banana-jack
J12, J38: Gate 8; banana-jack
J13, J40: Gate 9; banana-jack
J14, J42: Gate 10; banana-jack
J15, J44: Gate 11; banana-jack
J16, J47: Gate 13; banana-jack
J17, J48: Gate 12; banana-jack
J18, J49: Gate 14; banana-jack
J19, J51: Gate 15; banana-jack
J20, J54: Gate 16; banana-jack
J21: Conn_01x34_Socket; PinSocket_1x34_P2.54mm_Vertical
J24, J26, J27, J28, J32, J33, J35, J36, J39, J41, J43, J45, J46, J50, J52, J53: LED; PinHeader_1x02_P2.54mm_Vertical
J55: Conn_01x34_Pin; PinHeader_1x34_P2.54mm_Vertical
R1, R2, R3, R4, R5, R6, R7, R8, R9, R10, R11, R12, R13, R14, R15, R16, R17, R18, R19, R20, R21, R22, R23, R24, R25, R26, R27, R28, R29, R30, R31, R32, R33: 1K; R_Axial_DIN0207_L6.3mm_D2.5mm_P10.16mm_Horizontal
RV1: 100K - Period; Potentiometer_Alps_RK09K_Single_Vertical
RV2: 100K - Tempo; Potentiometer_Alps_RK09K_Single_Vertical
SW1: Mode 2; switch1
SW2: Mode; switch1
SW3: Clock Source; switch1
SW4: X1; SW_Cherry_MX_1.00u_PCB
SW5: X2; SW_Cherry_MX_1.00u_PCB
SW6: X3; SW_Cherry_MX_1.00u_PCB
SW7: X4; SW_Cherry_MX_1.00u_PCB
SW8: S1; SW_Cherry_MX_1.00u_PCB
SW9: S2; SW_Cherry_MX_1.00u_PCB
SW10: S3; SW_Cherry_MX_1.00u_PCB
SW11: S4; SW_Cherry_MX_1.00u_PCB
SW12: S5; SW_Cherry_MX_1.00u_PCB
SW13: S6; SW_Cherry_MX_1.00u_PCB
SW14: S7; SW_Cherry_MX_1.00u_PCB
SW15: S8; SW_Cherry_MX_1.00u_PCB
SW16: S9; SW_Cherry_MX_1.00u_PCB
SW17: S10; SW_Cherry_MX_1.00u_PCB
SW18: S11; SW_Cherry_MX_1.00u_PCB
SW19: S12; SW_Cherry_MX_1.00u_PCB
SW20: S13; SW_Cherry_MX_1.00u_PCB
SW21: S14; SW_Cherry_MX_1.00u_PCB
SW22: S15; SW_Cherry_MX_1.00u_PCB
SW23: S16; SW_Cherry_MX_1.00u_PCB
U1: DIP-24_W7.62mm_Socket

Connections:
5V: A1.27 (+5V), C1.2, J1.5, J2.5, J3.5, RV1.3, RV2.3, U1.24 (Vcc)
12V: J1.1, J2.1, J3.1
-12V: J1.2, J2.2, J3.2
GND: A1.4 (GND), A1.29 (GND), C1.1, C2.1, D5.1 (K), D6.1 (K), D9.1 (K), D11.1 (K), D12.1 (K), D14.1 (K), D17.1 (K), D20.1 (K), D21.1 (K), D22.1 (K), D25.1 (K), D28.1 (K), D29.1 (K), D31.1 (K), D33.1 (K), D36.1 (K), J1.3, J1.4, J2.3, J2.4, J3.3, J3.4, J21.34, RV1.1, RV2.1, SW1.3 (A), SW2.3 (A), SW3.3 (A), U1.12 (GND)
unnamed: A1.19 (A0), U1.2 (A)
unnamed: A1.20 (A1), U1.3 (B)
unnamed: A1.21 (A2), U1.21 (C)
unnamed: A1.22 (A3), U1.22 (D)
unnamed: A1.23 (A4), U1.23 (INHIBIT)
unnamed: A1.24 (A5), U1.1 (STROBE)
unnamed: A1.25 (A6), RV2.2
unnamed: A1.26 (A7), RV1.2
unnamed: A1.18 (AREF), C2.2
unnamed: A1.2 (D0/RX), SW3.2 (B)
unnamed: A1.1 (D1/TX), SW2.2 (B)
unnamed: A1.5 (D2), R1.2
unnamed: A1.6 (D3), SW20.2, SW21.2, SW22.2, SW23.2
unnamed: A1.7 (D4), SW16.2, SW17.2, SW18.2, SW19.2
unnamed: A1.8 (D5), SW12.2, SW13.2, SW14.2, SW15.2
unnamed: A1.9 (D6), SW8.2, SW9.2, SW10.2, SW11.2
unnamed: A1.10 (D7), SW4.2, SW5.2, SW6.2, SW7.2
unnamed: A1.11 (D8), D2.1 (K), D7.1 (K), D16.1 (K), D23.1 (K), D32.1 (K)
unnamed: A1.12 (D9), D1.1 (K), D8.1 (K), D15.1 (K), D24.1 (K), D30.1 (K)
unnamed: A1.13 (D10), D3.1 (K), D10.1 (K), D18.1 (K), D26.1 (K), D34.1 (K)
unnamed: A1.14 (D11), D4.1 (K), D13.1 (K), D19.1 (K), D27.1 (K), D35.1 (K)
unnamed: A1.15 (D12), SW1.2 (B)
unnamed: D1.2 (A), SW5.1
unnamed: D2.2 (A), SW4.1
unnamed: D3.2 (A), SW6.1
unnamed: D4.2 (A), SW7.1
unnamed: D5.2 (A), J21.2, R2.1
unnamed: D6.2 (A), J21.6, R3.1
unnamed: D7.2 (A), SW8.1
unnamed: D8.2 (A), SW9.1
unnamed: D9.2 (A), J21.10, R5.1
unnamed: D10.2 (A), SW10.1
unnamed: D11.2 (A), J21.18, R6.1
unnamed: D12.2 (A), J21.14, R4.1
unnamed: D13.2 (A), SW11.1
unnamed: D14.2 (A), J21.22, R7.1
unnamed: D15.2 (A), SW13.1
unnamed: D16.2 (A), SW12.1
unnamed: D17.2 (A), J21.26, R8.1
unnamed: D18.2 (A), SW14.1
unnamed: D19.2 (A), SW15.1
unnamed: D20.2 (A), J21.30, R9.1
unnamed: D21.2 (A), J21.4, R18.1
unnamed: D22.2 (A), J21.8, R19.1
unnamed: D23.2 (A), SW16.1
unnamed: D24.2 (A), SW17.1
unnamed: D25.2 (A), J21.12, R21.1
unnamed: D26.2 (A), SW18.1
unnamed: D27.2 (A), SW19.1
unnamed: D28.2 (A), J21.16, R20.1
unnamed: D29.2 (A), J21.20, R22.1
unnamed: D30.2 (A), SW21.1
unnamed: D31.2 (A), J21.24, R23.1
unnamed: D32.2 (A), SW20.1
unnamed: D33.2 (A), J21.28, R24.1
unnamed: D34.2 (A), SW22.1
unnamed: D35.2 (A), SW23.1
unnamed: D36.2 (A), J21.32, R25.1
unnamed: D37.2 (A), R2.2, U1.11 (S0)
unnamed: D37.1 (K), R10.2
unnamed: D38.2 (A), R6.2, U1.7 (S4)
unnamed: D38.1 (K), R14.2
unnamed: D39.2 (A), R18.2, U1.18 (S8)
unnamed: D39.1 (K), R26.2
unnamed: D40.2 (A), R22.2, U1.14 (S12)
unnamed: D40.1 (K), R30.2
unnamed: D41.2 (A), R19.2, U1.17 (S9)
unnamed: D41.1 (K), R27.2
unnamed: D42.2 (A), R7.2, U1.6 (S5)
unnamed: D42.1 (K), R15.2
unnamed: D43.2 (A), R3.2, U1.9 (S1)
unnamed: D43.1 (K), R11.2
unnamed: D44.2 (A), R23.2, U1.13 (S13)
unnamed: D44.1 (K), R31.2
unnamed: D45.2 (A), R5.2, U1.10 (S2)
unnamed: D45.1 (K), R12.2
unnamed: D46.2 (A), R8.2, U1.5 (S6)
unnamed: D46.1 (K), R16.2
unnamed: D47.2 (A), R21.2, U1.20 (S10)
unnamed: D47.1 (K), R28.2
unnamed: D48.2 (A), R24.2, U1.16 (S14)
unnamed: D48.1 (K), R32.2
unnamed: D49.2 (A), R4.2, U1.8 (S3)
unnamed: D49.1 (K), R13.2
unnamed: D50.2 (A), R9.2, U1.4 (S7)
unnamed: D50.1 (K), R17.2
unnamed: D51.2 (A), R20.2, U1.19 (S11)
unnamed: D51.1 (K), R29.2
unnamed: D52.2 (A), R25.2, U1.15 (S15)
unnamed: D52.1 (K), R33.2
unnamed: J10.1 (Pin_1_1), J21.21, R15.1
unnamed: J11.1 (Pin_1_1), J21.25, R16.1
unnamed: J12.1 (Pin_1_1), J21.29, R17.1
unnamed: J13.1 (Pin_1_1), J21.3, R26.1
unnamed: J14.1 (Pin_1_1), J21.7, R27.1
unnamed: J15.1 (Pin_1_1), J21.11, R28.1
unnamed: J16.1 (Pin_1_1), J21.19, R30.1
unnamed: J17.1 (Pin_1_1), J21.15, R29.1
unnamed: J18.1 (Pin_1_1), J21.23, R31.1
unnamed: J19.1 (Pin_1_1), J21.27, R32.1
unnamed: J20.1 (Pin_1_1), J21.31, R33.1
unnamed: J5.1 (Pin_1_1), J21.1, R10.1
unnamed: J6.1 (Pin_1_1), J21.5, R11.1
unnamed: J7.1 (Pin_1_1), J21.9, R12.1
unnamed: J9.1 (Pin_1_1), J21.13, R13.1
unnamed: J8.1 (Pin_1_1), J21.17, R14.1
unnamed: J4.1 (Pin_1_1), J21.33, R1.1
unnamed: J22.1 (Pin_1_1), J55.33
unnamed: J23.1 (Pin_1_1), J55.1
unnamed: J24.1, J55.2
unnamed: J24.2, J26.2, J27.2, J28.2, J32.2, J33.2, J35.2, J36.2, J39.2, J41.2, J43.2, J45.2, J46.2, J50.2, J52.2, J53.2, J55.34
unnamed: J25.1 (Pin_1_1), J55.5
unnamed: J26.1, J55.6
unnamed: J27.1, J55.10
unnamed: J28.1, J55.14
unnamed: J29.1 (Pin_1_1), J55.9
unnamed: J30.1 (Pin_1_1), J55.13
unnamed: J31.1 (Pin_1_1), J55.17
unnamed: J32.1, J55.18
unnamed: J33.1, J55.22
unnamed: J34.1 (Pin_1_1), J55.21
unnamed: J35.1, J55.30
unnamed: J36.1, J55.26
unnamed: J37.1 (Pin_1_1), J55.25
unnamed: J38.1 (Pin_1_1), J55.29
unnamed: J39.1, J55.4
unnamed: J40.1 (Pin_1_1), J55.3
unnamed: J41.1, J55.8
unnamed: J42.1 (Pin_1_1), J55.7
unnamed: J43.1, J55.12
unnamed: J44.1 (Pin_1_1), J55.11
unnamed: J45.1, J55.16
unnamed: J46.1, J55.20
unnamed: J47.1 (Pin_1_1), J55.19
unnamed: J48.1 (Pin_1_1), J55.15
unnamed: J49.1 (Pin_1_1), J55.23
unnamed: J50.1, J55.24
unnamed: J51.1 (Pin_1_1), J55.27
unnamed: J52.1, J55.32
unnamed: J53.1, J55.28
unnamed: J54.1 (Pin_1_1), J55.31

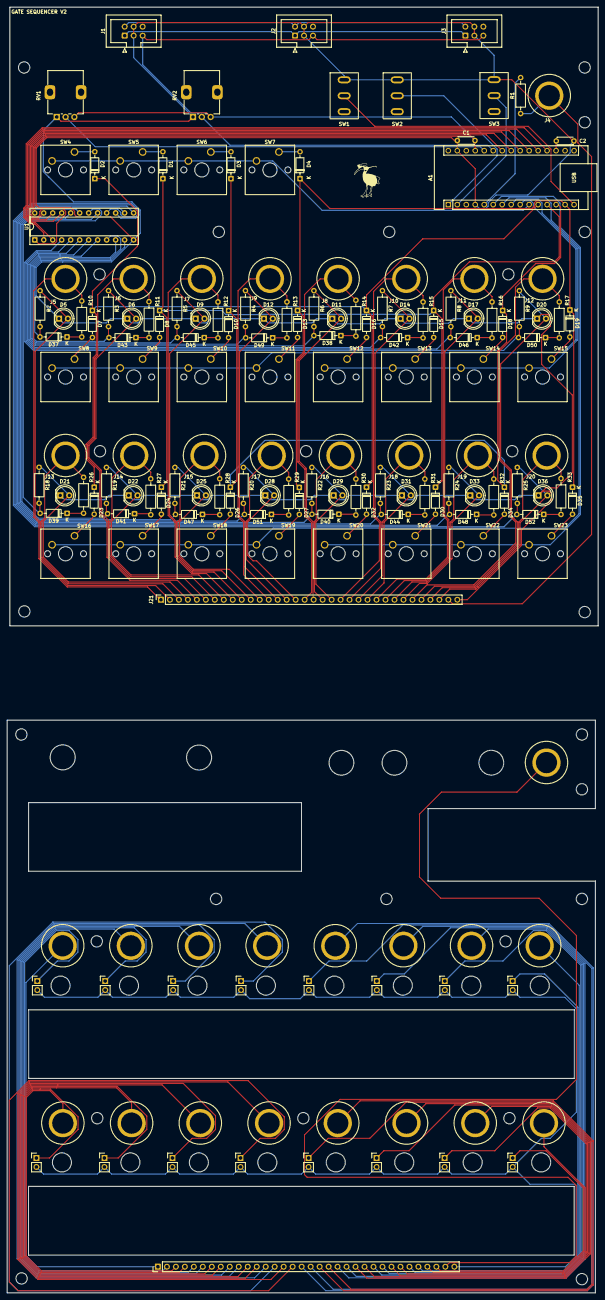
[picture p33: board gate-sequencer.kicad_pcb from above]

Board: 2 copper layers, 167.1 x 363.5 mm, 169 parts (0 on the bottom side), 145 nets.
