gridbugs/modular2/note-sequencer/note-sequencer.kicad_pcb

## KiCad design note-sequencer/note-sequencer.kicad_pcb (2026-06-06)

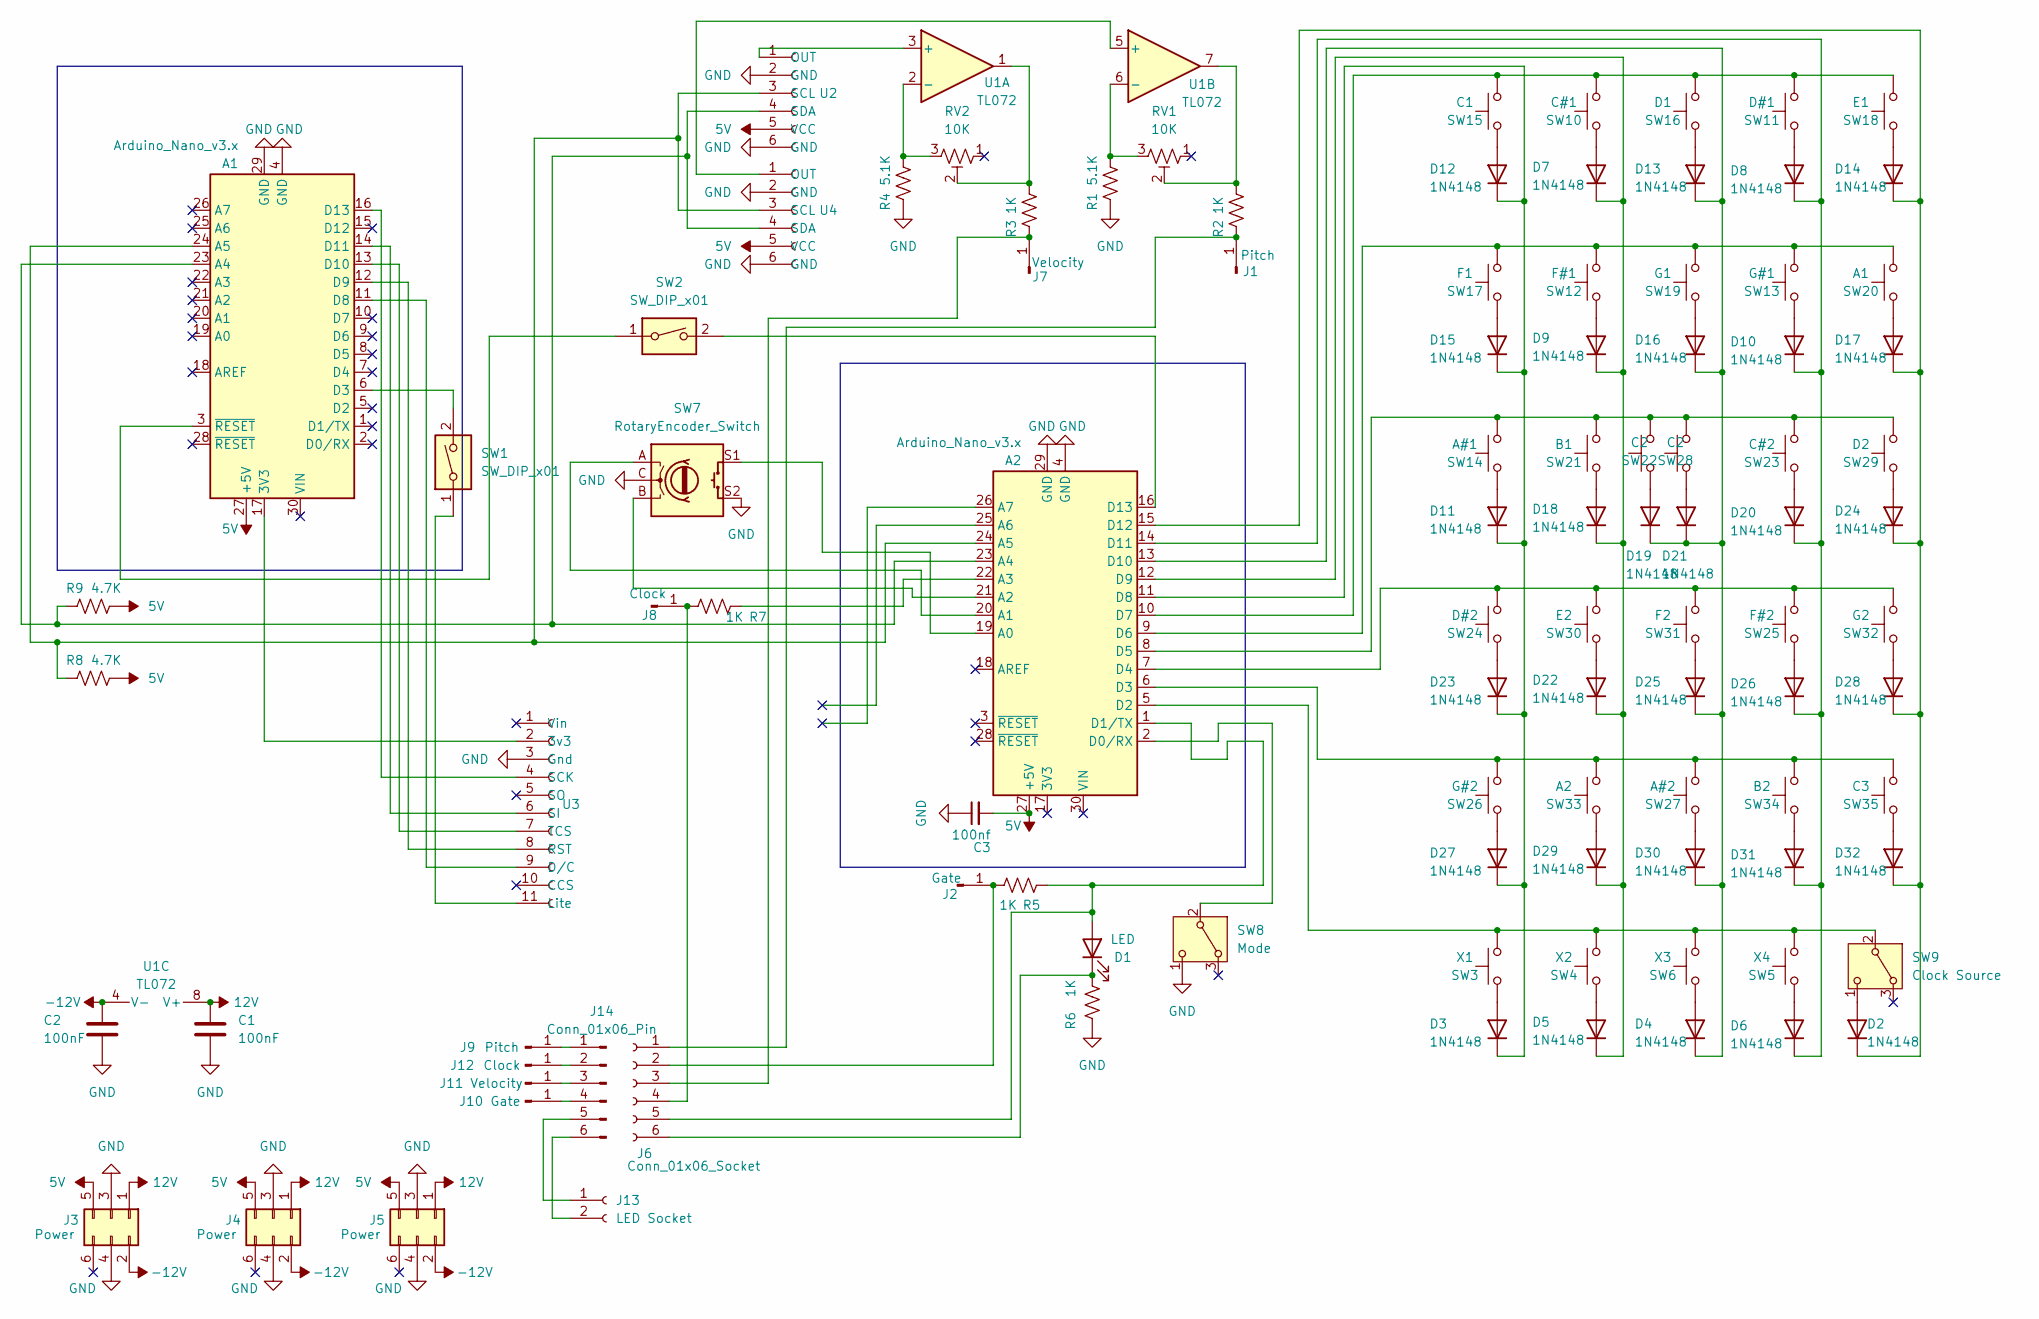
[picture p34: schematic note-sequencer.kicad_sch]

Parts:
A1, A2: Arduino_Nano_v3.x; Arduino_Nano
C1, C2: 100nF; C_Disc_D4.3mm_W1.9mm_P5.00mm
C3: 100nf; C_Disc_D4.3mm_W1.9mm_P5.00mm
D1: LED; LED_D5.0mm
D2, D3, D4, D5, D6, D7, D8, D9, D10, D11, D12, D13, D14, D15, D16, D17, D18, D19, D20, D21, D22, D23, D24, D25, D26, D27, D28, D29, D30, D31, D32: 1N4148; D_DO-35_SOD27_P7.62mm_Horizontal
J1, J9: Pitch; banana-jack
J2, J10: Gate; banana-jack
J3, J4, J5: Power; IDC-Header_2x03_P2.54mm_Vertical
J6: Conn_01x06_Socket; PinSocket_1x06_P2.54mm_Vertical
J7, J11: Velocity; banana-jack
J8, J12: Clock; banana-jack
J13: LED Socket; PinHeader_1x02_P2.54mm_Vertical
J14: Conn_01x06_Pin; PinHeader_1x06_P2.54mm_Vertical
R1, R4: 5.1K; R_Axial_DIN0207_L6.3mm_D2.5mm_P10.16mm_Horizontal
R2, R3, R5, R6, R7: 1K; R_Axial_DIN0207_L6.3mm_D2.5mm_P10.16mm_Horizontal
R8, R9: 4.7K; R_Axial_DIN0207_L6.3mm_D2.5mm_P10.16mm_Horizontal
RV1, RV2: 10K; Potentiometer_Bourns_3296W_Vertical
SW1, SW2: SW_DIP_x01; SW_DIP_SPSTx01_Slide_9.78x4.72mm_W7.62mm_P2.54mm
SW3: X1; SW_Cherry_MX_1.00u_PCB
SW4: X2; SW_Cherry_MX_1.00u_PCB
SW5: X4; SW_Cherry_MX_1.00u_PCB
SW6: X3; SW_Cherry_MX_1.00u_PCB
SW7: RotaryEncoder_Switch; RotaryEncoder_Alps_EC11E-Switch_Vertical_H20mm
SW8: Mode; switch1
SW9: Clock Source; switch1
SW10: C#1; SW_Cherry_MX_1.00u_PCB
SW11: D#1; SW_Cherry_MX_1.00u_PCB
SW12: F#1; SW_Cherry_MX_1.00u_PCB
SW13: G#1; SW_Cherry_MX_1.00u_PCB
SW14: A#1; SW_Cherry_MX_1.00u_PCB
SW15: C1; SW_Cherry_MX_1.00u_PCB
SW16: D1; SW_Cherry_MX_1.00u_PCB
SW17: F1; SW_Cherry_MX_1.00u_PCB
SW18: E1; SW_Cherry_MX_1.00u_PCB
SW19: G1; SW_Cherry_MX_1.00u_PCB
SW20: A1; SW_Cherry_MX_1.00u_PCB
SW21: B1; SW_Cherry_MX_1.00u_PCB
SW22, SW28: C2; SW_Cherry_MX_1.00u_PCB
SW23: C#2; SW_Cherry_MX_1.00u_PCB
SW24: D#2; SW_Cherry_MX_1.00u_PCB
SW25: F#2; SW_Cherry_MX_1.00u_PCB
SW26: G#2; SW_Cherry_MX_1.00u_PCB
SW27: A#2; SW_Cherry_MX_1.00u_PCB
SW29: D2; SW_Cherry_MX_1.00u_PCB
SW30: E2; SW_Cherry_MX_1.00u_PCB
SW31: F2; SW_Cherry_MX_1.00u_PCB
SW32: G2; SW_Cherry_MX_1.00u_PCB
SW33: A2; SW_Cherry_MX_1.00u_PCB
SW34: B2; SW_Cherry_MX_1.00u_PCB
SW35: C3; SW_Cherry_MX_1.00u_PCB
U1: TL072; DIP-8_W7.62mm_Socket
U2, U4: mcp4725_breakout
U3: st7735

Connections:
5V: A1.27 (+5V), A2.27 (+5V), C3.2, J3.5, J4.5, J5.5, R8.2, R9.2, U2.5 (VCC), U4.5 (VCC)
12V: C1.2, J3.1, J4.1, J5.1, U1.8 (V+)
-12V: C2.2, J3.2, J4.2, J5.2, U1.4 (V-)
GND: A1.4 (GND), A1.29 (GND), A2.4 (GND), A2.29 (GND), C1.1, C2.1, C3.1, J3.3, J3.4, J4.3, J4.4, J5.3, J5.4, R1.1, R4.1, R6.1, SW7.C, SW7.S2, SW8.1 (C), U2.2 (GND), U2.6 (GND), U3.3 (Gnd), U4.2 (GND), U4.6 (GND)
unnamed: A1.17 (3V3), U3.2 (3v3)
unnamed: A1.23 (A4), A2.23 (A4), R9.1, U2.4 (SDA), U4.4 (SDA)
unnamed: A1.24 (A5), A2.24 (A5), R8.1, U2.3 (SCL), U4.3 (SCL)
unnamed: A1.6 (D3), SW1.2
unnamed: A1.11 (D8), U3.9 (D/C)
unnamed: A1.12 (D9), U3.8 (RST)
unnamed: A1.13 (D10), U3.7 (TCS)
unnamed: A1.14 (D11), U3.6 (SI)
unnamed: A1.16 (D13), U3.4 (SCK)
unnamed: A1.3 (~RESET), SW2.1
unnamed: A2.19 (A0), SW7.S1
unnamed: A2.20 (A1), SW7.A
unnamed: A2.21 (A2), SW7.B
unnamed: A2.22 (A3), R7.1
unnamed: A2.2 (D0/RX), SW8.2 (B)
unnamed: A2.1 (D1/TX), D1.2 (A), J6.5, R5.1
unnamed: A2.5 (D2), SW3.2, SW4.2, SW5.2, SW6.2, SW9.2 (B)
unnamed: A2.6 (D3), SW26.2, SW27.2, SW33.2, SW34.2, SW35.2
unnamed: A2.7 (D4), SW24.2, SW25.2, SW30.2, SW31.2, SW32.2
unnamed: A2.8 (D5), SW14.2, SW21.2, SW22.2, SW23.2, SW28.2, SW29.2
unnamed: A2.9 (D6), SW12.2, SW13.2, SW17.2, SW19.2, SW20.2
unnamed: A2.10 (D7), SW10.2, SW11.2, SW15.2, SW16.2, SW18.2
unnamed: A2.11 (D8), D3.1 (K), D11.1 (K), D12.1 (K), D15.1 (K), D23.1 (K), D27.1 (K)
unnamed: A2.12 (D9), D5.1 (K), D7.1 (K), D9.1 (K), D18.1 (K), D22.1 (K), D29.1 (K)
unnamed: A2.13 (D10), D4.1 (K), D13.1 (K), D16.1 (K), D19.1 (K), D21.1 (K), D25.1 (K), D30.1 (K)
unnamed: A2.14 (D11), D6.1 (K), D8.1 (K), D10.1 (K), D20.1 (K), D26.1 (K), D31.1 (K)
unnamed: A2.15 (D12), D2.1 (K), D14.1 (K), D17.1 (K), D24.1 (K), D28.1 (K), D32.1 (K)
unnamed: A2.16 (D13), SW2.2
unnamed: D1.1 (K), J6.6, R6.2
unnamed: D2.2 (A), SW9.1 (C)
unnamed: D3.2 (A), SW3.1
unnamed: D4.2 (A), SW6.1
unnamed: D5.2 (A), SW4.1
unnamed: D6.2 (A), SW5.1
unnamed: D7.2 (A), SW10.1
unnamed: D8.2 (A), SW11.1
unnamed: D9.2 (A), SW12.1
unnamed: D10.2 (A), SW13.1
unnamed: D11.2 (A), SW14.1
unnamed: D12.2 (A), SW15.1
unnamed: D13.2 (A), SW16.1
unnamed: D14.2 (A), SW18.1
unnamed: D15.2 (A), SW17.1
unnamed: D16.2 (A), SW19.1
unnamed: D17.2 (A), SW20.1
unnamed: D18.2 (A), SW21.1
unnamed: D19.2 (A), SW22.1
unnamed: D20.2 (A), SW23.1
unnamed: D21.2 (A), SW28.1
unnamed: D22.2 (A), SW30.1
unnamed: D23.2 (A), SW24.1
unnamed: D24.2 (A), SW29.1
unnamed: D25.2 (A), SW31.1
unnamed: D26.2 (A), SW25.1
unnamed: D27.2 (A), SW26.1
unnamed: D28.2 (A), SW32.1
unnamed: D29.2 (A), SW33.1
unnamed: D30.2 (A), SW27.1
unnamed: D31.2 (A), SW34.1
unnamed: D32.2 (A), SW35.1
unnamed: J1.1, J6.1, R2.1
unnamed: J2.1, J6.2, R5.2
unnamed: J6.3, J7.1, R3.1
unnamed: J6.4, J8.1, R7.2
unnamed: J10.1, J14.4
unnamed: J11.1, J14.3
unnamed: J12.1, J14.2
unnamed: J13.1, J14.5
unnamed: J13.2, J14.6
unnamed: J9.1, J14.1
unnamed: R2.2, RV1.2, U1.7
unnamed: R3.2, RV2.2, U1.1
unnamed: U1.3 (+), U2.1 (OUT)
unnamed: R4.2, RV2.3, U1.2 (-)
unnamed: U1.5 (+), U4.1 (OUT)
unnamed: R1.2, RV1.3, U1.6 (-)
unnamed: SW1.1, U3.11 (Lite)

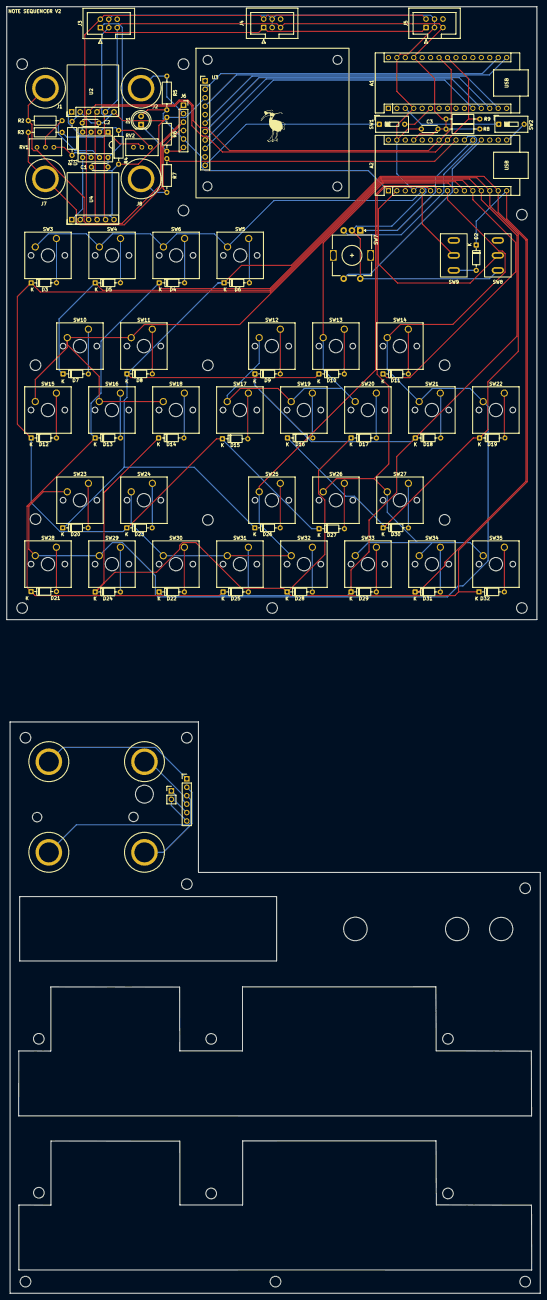
[picture p35: board note-sequencer.kicad_pcb from above]

Board: 2 copper layers, 159.4 x 184.2 mm, 101 parts (0 on the bottom side), 81 nets.
