gridbugs/modular2/diode-ladder-filter/diode-ladder-filter.kicad_pcb

## KiCad design diode-ladder-filter/diode-ladder-filter.kicad_pcb (2026-06-06)

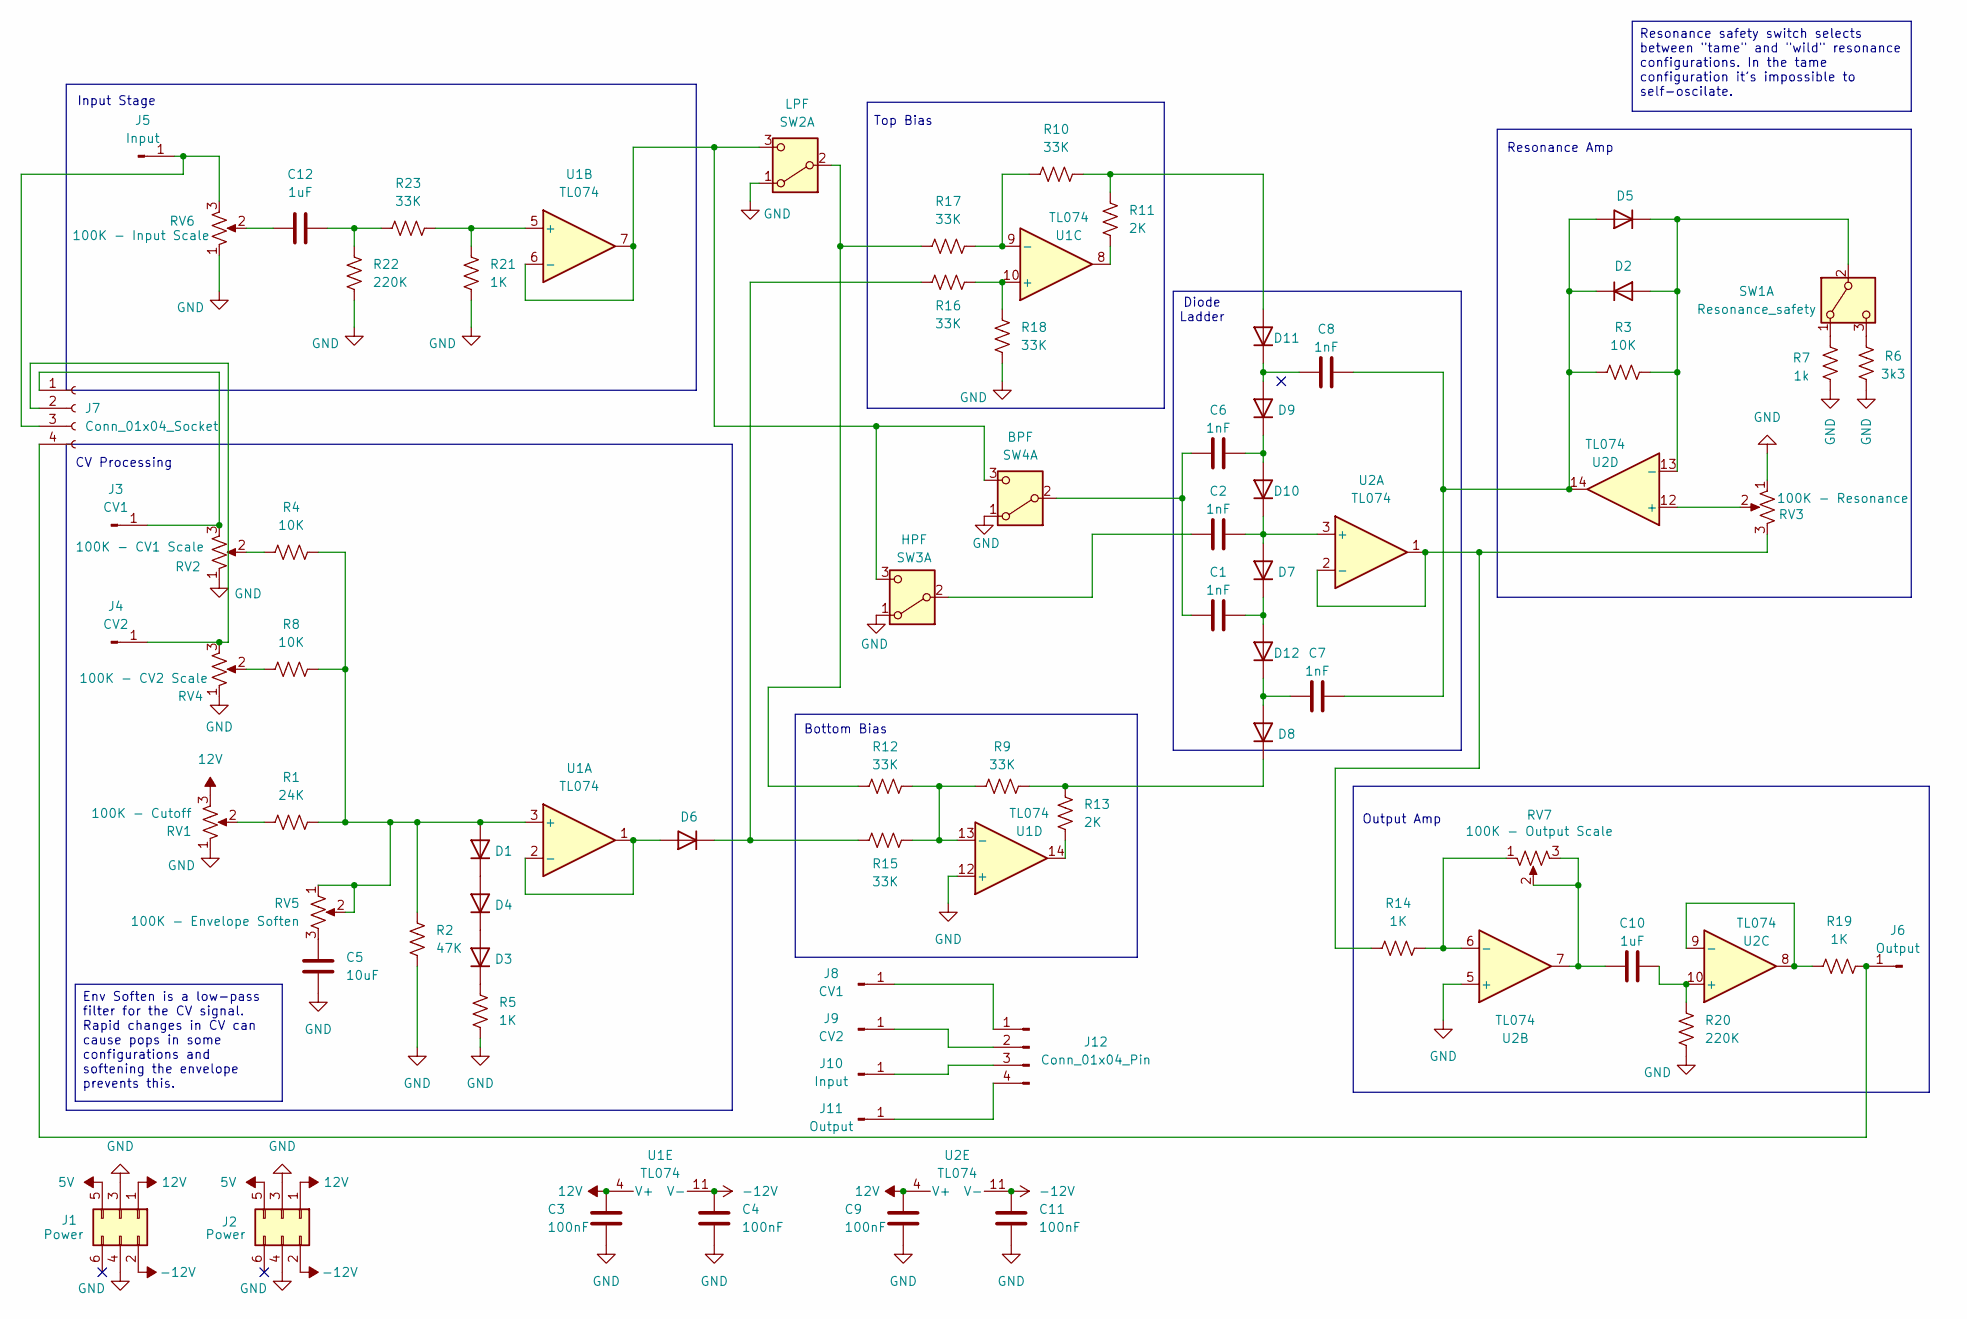
[picture p36: schematic diode-ladder-filter.kicad_sch]

Parts:
C1, C2, C6, C7, C8: 1nF; C_Disc_D4.3mm_W1.9mm_P5.00mm
C3, C4, C9, C11: 100nF; C_Disc_D4.3mm_W1.9mm_P5.00mm
C5: 10uF; C_Disc_D4.3mm_W1.9mm_P5.00mm
C10, C12: 1uF; C_Disc_D4.3mm_W1.9mm_P5.00mm
D1, D2, D3, D4, D5, D6, D7, D8, D9, D10, D11, D12: D; D_A-405_P7.62mm_Horizontal
J1, J2: Power; IDC-Header_2x03_P2.54mm_Vertical
J3, J8: CV1; banana-jack
J4, J9: CV2; banana-jack
J5, J10: Input; banana-jack
J6, J11: Output; banana-jack
J7: Conn_01x04_Socket; PinSocket_1x04_P2.54mm_Vertical
J12: Conn_01x04_Pin; PinHeader_1x04_P2.54mm_Vertical
R1: 24K; R_Axial_DIN0207_L6.3mm_D2.5mm_P10.16mm_Horizontal
R2: 47K; R_Axial_DIN0207_L6.3mm_D2.5mm_P10.16mm_Horizontal
R3, R4, R8: 10K; R_Axial_DIN0207_L6.3mm_D2.5mm_P10.16mm_Horizontal
R5, R14, R19, R21: 1K; R_Axial_DIN0207_L6.3mm_D2.5mm_P10.16mm_Horizontal
R6: 3k3; R_Axial_DIN0207_L6.3mm_D2.5mm_P10.16mm_Horizontal
R7: 1k; R_Axial_DIN0207_L6.3mm_D2.5mm_P10.16mm_Horizontal
R9, R10, R12, R15, R16, R17, R18, R23: 33K; R_Axial_DIN0207_L6.3mm_D2.5mm_P10.16mm_Horizontal
R11, R13: 2K; R_Axial_DIN0207_L6.3mm_D2.5mm_P10.16mm_Horizontal
R20, R22: 220K; R_Axial_DIN0207_L6.3mm_D2.5mm_P10.16mm_Horizontal
RV1: 100K - Cutoff; Potentiometer_Alps_RK09K_Single_Vertical
RV2: 100K - CV1 Scale; Potentiometer_Alps_RK09K_Single_Vertical
RV3: 100K - Resonance; Potentiometer_Alps_RK09K_Single_Vertical
RV4: 100K - CV2 Scale; Potentiometer_Alps_RK09K_Single_Vertical
RV5: 100K - Envelope Soften; Potentiometer_Alps_RK09K_Single_Vertical
RV6: 100K - Input Scale; Potentiometer_Alps_RK09K_Single_Vertical
RV7: 100K - Output Scale; Potentiometer_Alps_RK09K_Single_Vertical
SW1: Resonance_safety; switch1
SW2: LPF; switch1
SW3: HPF; switch1
SW4: BPF; switch1
U1, U2: TL074; DIP-14_W7.62mm_Socket

Connections:
5V: J1.5, J2.5
12V: C3.2, C9.2, J1.1, J2.1, RV1.3, U1.4 (V+), U2.4 (V+)
-12V: C4.2, C11.2, J1.2, J2.2, U1.11 (V-), U2.11 (V-)
GND: C3.1, C4.1, C5.1, C9.1, C11.1, J1.3, J1.4, J2.3, J2.4, R2.1, R5.1, R6.1, R7.1, R18.1, R20.2, R21.2, R22.2, RV1.1, RV2.1, RV3.1, RV4.1, RV6.1, SW2.1 (A), SW3.1 (A), SW4.1 (A), U1.12 (+), U2.5 (+)
unnamed: C5.2, RV5.3
unnamed: C10.1, RV7.2, RV7.3, U2.7
unnamed: C12.1, RV6.2
unnamed: C12.2, R22.1, R23.1
unnamed: D1.2 (A), R1.1, R2.2, R4.1, R8.1, RV5.1, RV5.2, U1.3 (+)
unnamed: D1.1 (K), D4.2 (A)
unnamed: D2.2 (A), D5.1 (K), R3.2, SW1.2 (B), U2.13 (-)
unnamed: C7.2, C8.2, D2.1 (K), D5.2 (A), R3.1, U2.14
unnamed: D3.2 (A), D4.1 (K)
unnamed: D3.1 (K), R5.2
unnamed: D6.2 (A), U1.1, U1.2 (-)
unnamed: D6.1 (K), R15.2, R16.2
unnamed: D8.1 (K), R9.1, R13.2
unnamed: C6.2, D9.1 (K), D10.2 (A)
unnamed: C2.2, D7.2 (A), D10.1 (K), U2.3 (+)
unnamed: D11.2 (A), R10.2, R11.2
unnamed: C8.1, D9.2 (A), D11.1 (K)
unnamed: C1.2, D7.1 (K), D12.2 (A)
unnamed: C7.1, D8.2 (A), D12.1 (K)
unnamed: J3.1, J7.1, RV2.3
unnamed: J4.1, J7.2, RV4.3
unnamed: J5.1, J7.3, RV6.3
unnamed: J6.1, J7.4, R19.2
unnamed: J10.1, J12.3
unnamed: J11.1, J12.4
unnamed: J8.1, J12.1
unnamed: J9.1, J12.2
unnamed: R1.2, RV1.2
unnamed: R4.2, RV2.2
unnamed: R8.2, RV4.2
unnamed: R11.1, U1.8
unnamed: R13.1, U1.14
unnamed: R7.2, SW1.1 (A)
unnamed: R6.2, SW1.3 (C)
unnamed: R12.2, R17.1, SW2.2 (B)
unnamed: SW2.3 (C), SW3.3 (C), SW4.3 (C), U1.6 (-), U1.7
unnamed: C2.1, SW3.2 (B)
unnamed: C1.1, C6.1, SW4.2 (B)
unnamed: R21.1, R23.2, U1.5 (+)
unnamed: R16.1, R18.2, U1.10 (+)
unnamed: R10.1, R17.2, U1.9 (-)
unnamed: R9.2, R12.1, R15.1, U1.13 (-)
unnamed: R14.1, RV3.3, U2.1, U2.2 (-)
unnamed: R14.2, RV7.1, U2.6 (-)
unnamed: C10.2, R20.1, U2.10 (+)
unnamed: R19.1, U2.8, U2.9 (-)
unnamed: RV3.2, U2.12 (+)

Notes on the sheet:
Bottom Bias
Resonance Amp
Input Stage
Output Amp
Top Bias
Diode Ladder
CV Processing
Resonance safety switch selects between "tame" and "wild" resonance configurations. In the tame configuration it's impossible to self-oscilate.
Env Soften is a low-pass filter for the CV signal. Rapid changes in CV can cause pops in some configurations and softening the envelope prevents this.
