gridbugs/modular2/diode-ladder-filter/diode-ladder-filter.kicad_pcb

## KiCad design diode-ladder-filter/diode-ladder-filter.kicad_pcb (continued)

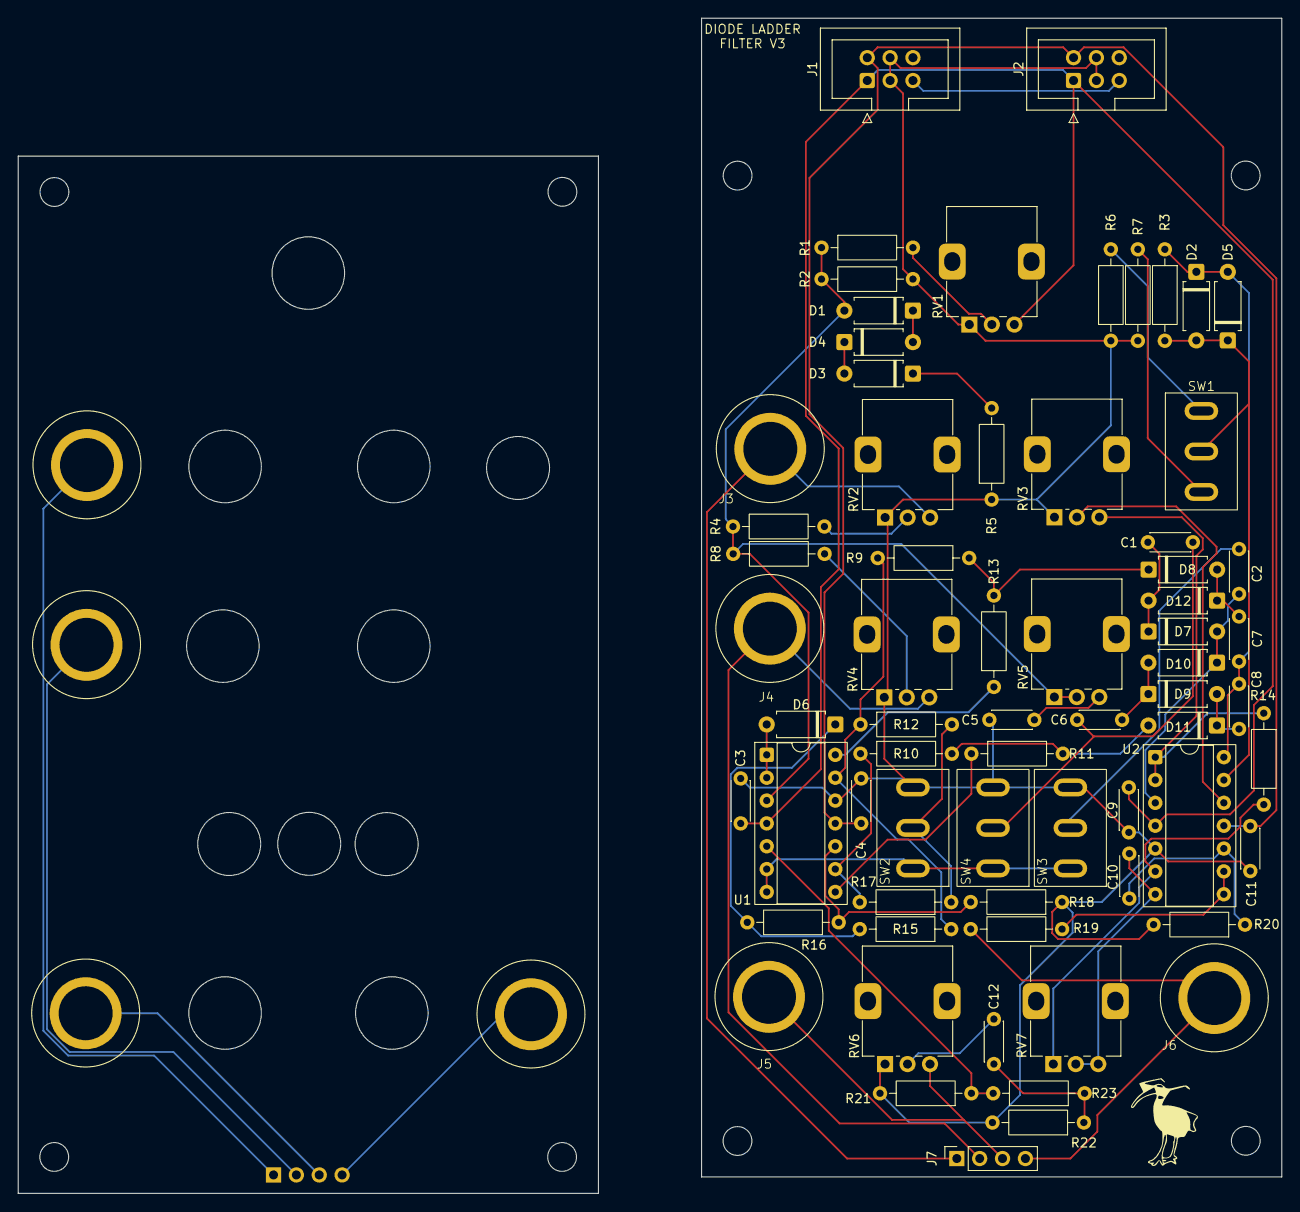
[picture p37: board diode-ladder-filter.kicad_pcb from above]

Board: 2 copper layers, 64.5 x 128.8 mm, 80 parts (1 on the bottom side), 51 nets.

Other parts of the board:
H1, H2, H3, H4, H5, H6, H7, H8: MountingHole_3.2mm_M3
