gridbugs/modular2/voltage-controlled-amplifier/voltage-controlled-amplifier.kicad_pcb

## KiCad design voltage-controlled-amplifier/voltage-controlled-amplifier.kicad_pcb (2026-02-08)

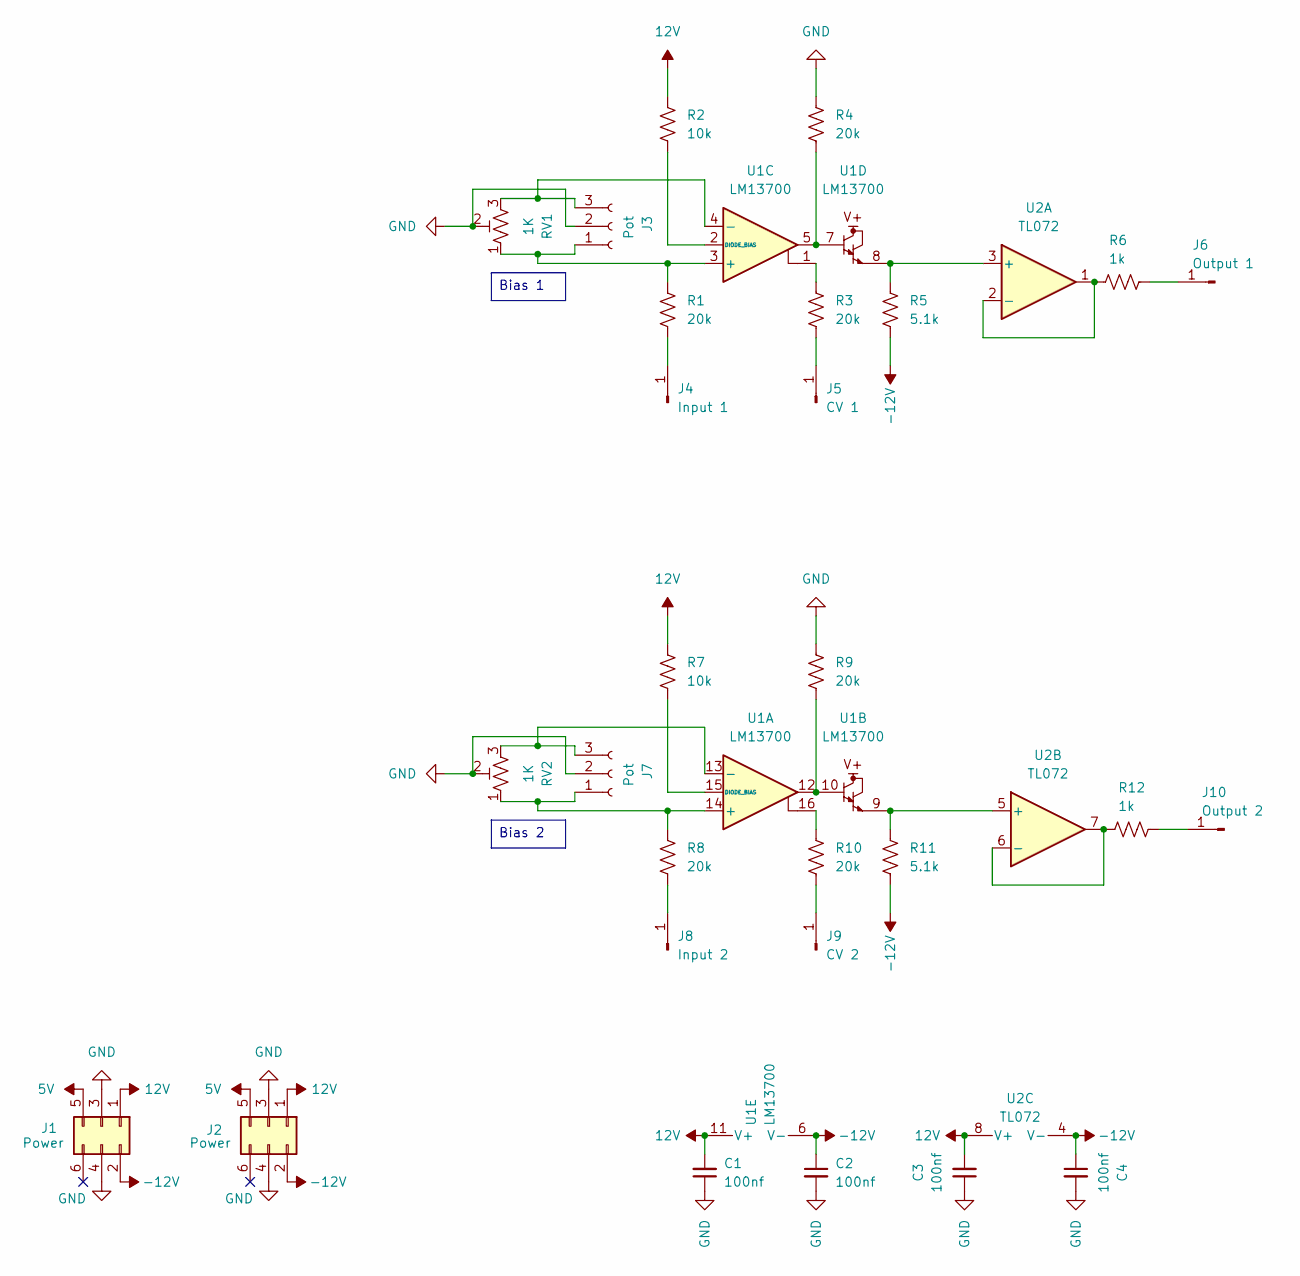
[picture p38: schematic voltage-controlled-amplifier.kicad_sch]

Parts:
C1, C2, C3, C4: 100nf; C_Disc_D4.3mm_W1.9mm_P5.00mm
J1, J2: Power; IDC-Header_2x03_P2.54mm_Vertical
J3, J7: Pot; pot
J4: Input 1; banana-jack
J5: CV 1; banana-jack
J6: Output 1; banana-jack
J8: Input 2; banana-jack
J9: CV 2; banana-jack
J10: Output 2; banana-jack
R1, R3, R4, R8, R9, R10: 20k; R_Axial_DIN0207_L6.3mm_D2.5mm_P10.16mm_Horizontal
R2, R7: 10k; R_Axial_DIN0207_L6.3mm_D2.5mm_P10.16mm_Horizontal
R5, R11: 5.1k; R_Axial_DIN0207_L6.3mm_D2.5mm_P10.16mm_Horizontal
R6, R12: 1k; R_Axial_DIN0207_L6.3mm_D2.5mm_P10.16mm_Horizontal
RV1, RV2: 1K; pot-socket
U1: LM13700; DIP-16_W7.62mm_Socket
U2: TL072; DIP-8_W7.62mm_Socket

Connections:
5V: J1.5, J2.5
12V: C1.2, C3.2, J1.1, J2.1, R2.1, R7.1, U1.11 (V+), U2.8 (V+)
-12V: C2.1, C4.1, J1.2, J2.2, R5.2, R11.2, U1.6 (V-), U2.4 (V-)
GND: C1.1, C2.2, C3.1, C4.2, J1.3, J1.4, J2.3, J2.4, J3.2, J7.2, R4.1, R9.1, RV1.2, RV2.2
unnamed: J3.1, R1.1, RV1.1, U1.3 (+)
unnamed: J3.3, RV1.3, U1.4 (-)
unnamed: J4.1, R1.2
unnamed: J5.1, R3.2
unnamed: J6.1, R6.2
unnamed: J7.1, R8.1, RV2.1, U1.14 (+)
unnamed: J7.3, RV2.3, U1.13 (-)
unnamed: J8.1, R8.2
unnamed: J9.1, R10.2
unnamed: J10.1, R12.2
unnamed: R3.1, U1.1
unnamed: R4.2, U1.5, U1.7
unnamed: R9.2, U1.10, U1.12
unnamed: R10.1, U1.16
unnamed: R7.2, U1.15 (DIODE_BIAS)
unnamed: R2.2, U1.2 (DIODE_BIAS)
unnamed: R5.1, U1.8, U2.3 (+)
unnamed: R6.1, U2.1, U2.2 (-)
unnamed: R11.1, U1.9, U2.5 (+)
unnamed: R12.1, U2.6 (-), U2.7

Notes on the sheet:
Bias 2
Bias 1

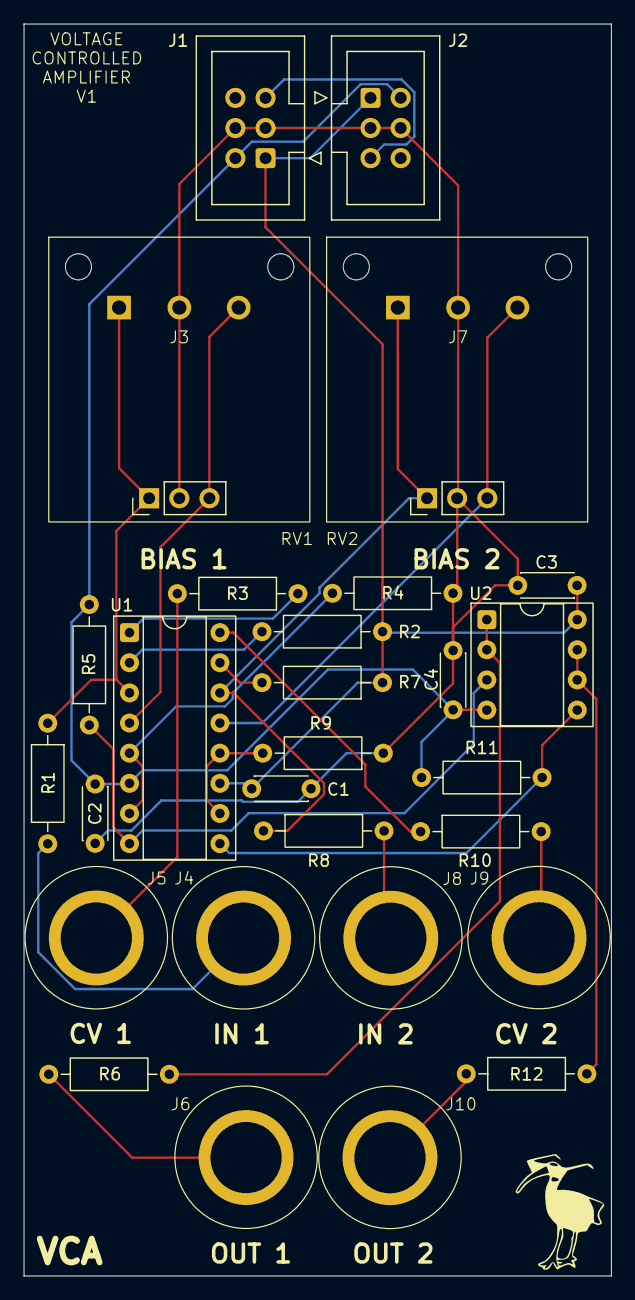
[picture p39: board voltage-controlled-amplifier.kicad_pcb from above]

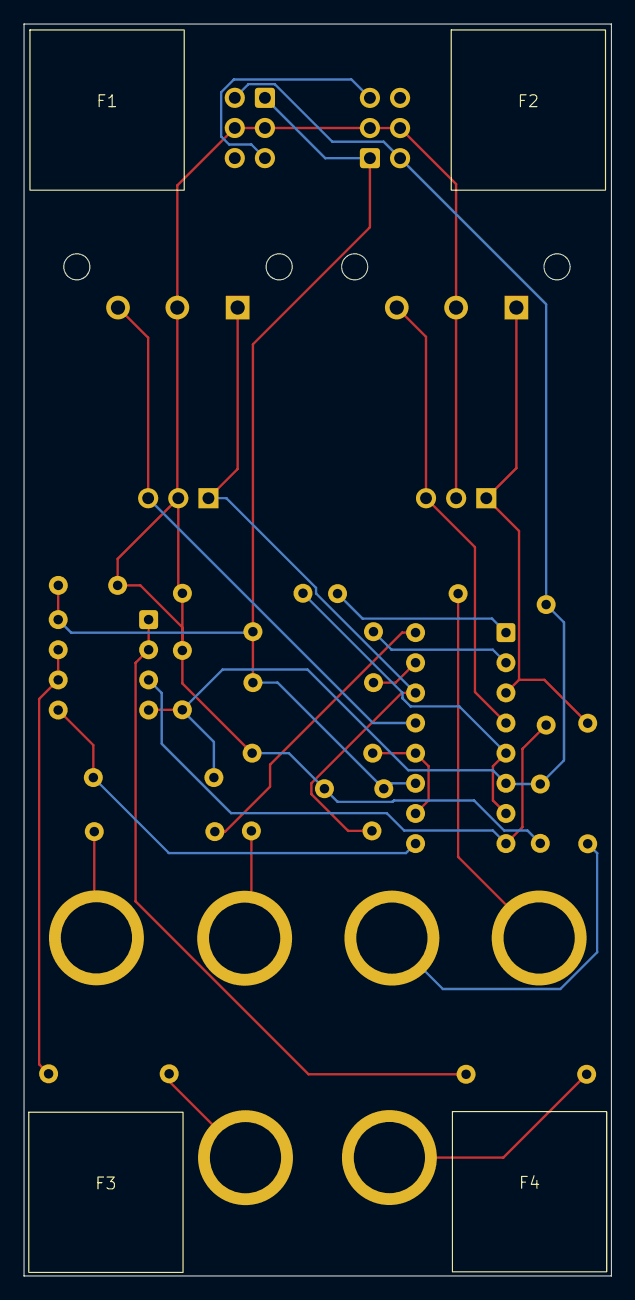
[picture p40: board voltage-controlled-amplifier.kicad_pcb from below]

Board: 2 copper layers, 49.5 x 105.5 mm, 34 parts (4 on the bottom side), 24 nets.

Other parts of the board:
F1, F2, F3, F4: foot
