gridbugs/modular2/attenuverter/attenuverter.kicad_pcb

## KiCad design attenuverter/attenuverter.kicad_pcb (2026-02-08)

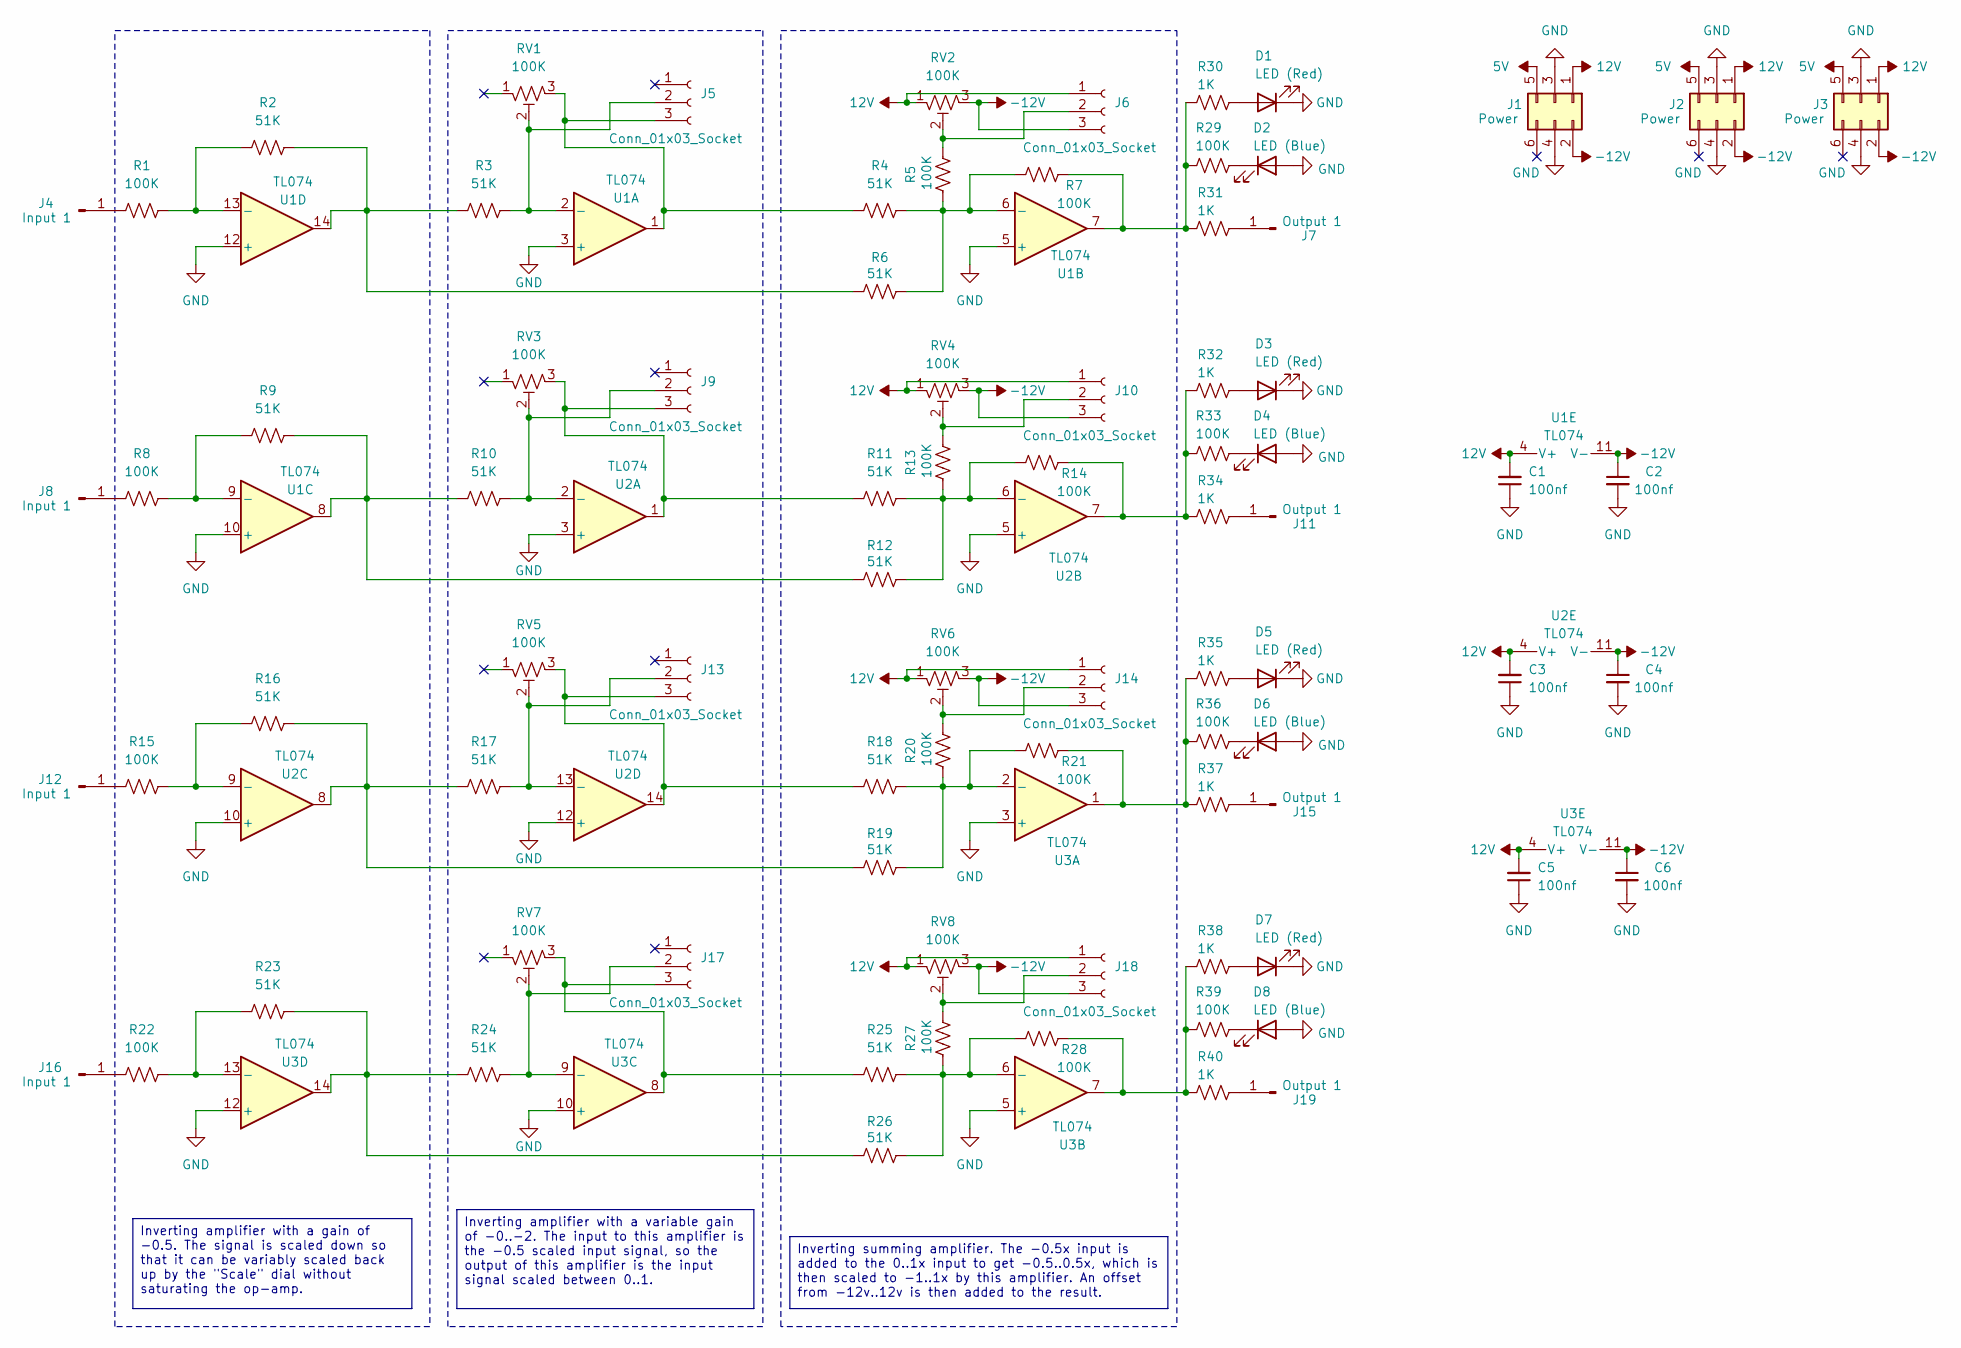
[picture p41: schematic attenuverter.kicad_sch]

Parts:
C1, C2, C3, C4, C5, C6: 100nf; C_Disc_D4.3mm_W1.9mm_P5.00mm
D1, D3, D5, D7: LED (Red); LED_D5.0mm
D2, D4, D6, D8: LED (Blue); LED_D5.0mm
J1, J2, J3: Power; IDC-Header_2x03_P2.54mm_Vertical
J4, J8, J12, J16: Input 1; banana-jack
J5, J6, J9, J10, J13, J14, J17, J18: Conn_01x03_Socket; pot
J7, J11, J15, J19: Output 1; banana-jack
R1, R5, R7, R8, R13, R14, R15, R20, R21, R22, R27, R28, R29, R33, R36, R39: 100K; R_Axial_DIN0207_L6.3mm_D2.5mm_P10.16mm_Horizontal
R2, R3, R4, R6, R9, R10, R11, R12, R16, R17, R18, R19, R23, R24, R25, R26: 51K; R_Axial_DIN0207_L6.3mm_D2.5mm_P10.16mm_Horizontal
R30, R31, R32, R34, R35, R37, R38, R40: 1K; R_Axial_DIN0207_L6.3mm_D2.5mm_P10.16mm_Horizontal
RV1, RV2, RV3, RV4, RV5, RV6, RV7, RV8: 100K; pot-socket
U1, U2, U3: TL074; DIP-14_W7.62mm_Socket

Connections:
5V: J1.5, J2.5, J3.5
12V: C1.2, C3.2, C5.2, J1.1, J2.1, J3.1, J6.1, J10.1, J14.1, J18.1, RV2.1, RV4.1, RV6.1, RV8.1, U1.4 (V+), U2.4 (V+), U3.4 (V+)
-12V: C2.1, C4.1, C6.1, J1.2, J2.2, J3.2, J6.3, J10.3, J14.3, J18.3, RV2.3, RV4.3, RV6.3, RV8.3, U1.11 (V-), U2.11 (V-), U3.11 (V-)
GND: C1.1, C2.2, C3.1, C4.2, C5.1, C6.2, D1.1 (K), D2.2 (A), D3.1 (K), D4.2 (A), D5.1 (K), D6.2 (A), D7.1 (K), D8.2 (A), J1.3, J1.4, J2.3, J2.4, J3.3, J3.4, U1.3 (+), U1.5 (+), U1.10 (+), U1.12 (+), U2.3 (+), U2.5 (+), U2.10 (+), U2.12 (+), U3.3 (+), U3.5 (+), U3.10 (+), U3.12 (+)
unnamed: D1.2 (A), R30.1
unnamed: D2.1 (K), R29.2
unnamed: D3.2 (A), R32.1
unnamed: D4.1 (K), R33.2
unnamed: D5.2 (A), R35.1
unnamed: D6.1 (K), R36.2
unnamed: D7.2 (A), R38.1
unnamed: D8.1 (K), R39.2
unnamed: J4.1, R1.1
unnamed: J5.2, R3.2, RV1.2, U1.2 (-)
unnamed: J5.3, R4.1, RV1.3, U1.1
unnamed: J6.2, R5.2, RV2.2
unnamed: J7.1, R31.1
unnamed: J8.1, R8.1
unnamed: J9.2, R10.2, RV3.2, U2.2 (-)
unnamed: J9.3, R11.1, RV3.3, U2.1
unnamed: J10.2, R13.2, RV4.2
unnamed: J11.1, R34.1
unnamed: J12.1, R15.1
unnamed: J13.2, R17.2, RV5.2, U2.13 (-)
unnamed: J13.3, R18.1, RV5.3, U2.14
unnamed: J14.2, R20.2, RV6.2
unnamed: J15.1, R37.1
unnamed: J16.1, R22.1
unnamed: J17.2, R24.2, RV7.2, U3.9 (-)
unnamed: J17.3, R25.1, RV7.3, U3.8
unnamed: J18.2, R27.2, RV8.2
unnamed: J19.1, R40.1
unnamed: R2.2, R3.1, R6.1, U1.14
unnamed: R9.2, R10.1, R12.1, U1.8
unnamed: R14.2, R32.2, R33.1, R34.2, U2.7
unnamed: R16.2, R17.1, R19.1, U2.8
unnamed: R21.2, R35.2, R36.1, R37.2, U3.1
unnamed: R23.2, R24.1, R26.1, U3.14
unnamed: R28.2, R38.2, R39.1, R40.2, U3.7
unnamed: R7.2, R29.1, R30.2, R31.2, U1.7
unnamed: R4.2, R5.1, R6.2, R7.1, U1.6 (-)
unnamed: R8.2, R9.1, U1.9 (-)
unnamed: R1.2, R2.1, U1.13 (-)
unnamed: R11.2, R12.2, R13.1, R14.1, U2.6 (-)
unnamed: R15.2, R16.1, U2.9 (-)
unnamed: R18.2, R19.2, R20.1, R21.1, U3.2 (-)
unnamed: R25.2, R26.2, R27.1, R28.1, U3.6 (-)
unnamed: R22.2, R23.1, U3.13 (-)

Notes on the sheet:
Inverting amplifier with a variable gain of -0..-2. The input to this amplifier is the -0.5 scaled input signal, so the output of this amplifier is the input signal scaled between 0..1.
Inverting amplifier with a gain of -0.5. The signal is scaled down so that it can be variably scaled back up by the "Scale" dial without saturating the op-amp.
Inverting summing amplifier. The -0.5x input is added to the 0..1x input to get -0.5..0.5x, which is then scaled to -1..1x by this amplifier. An offset from -12v..12v is then added to the result.

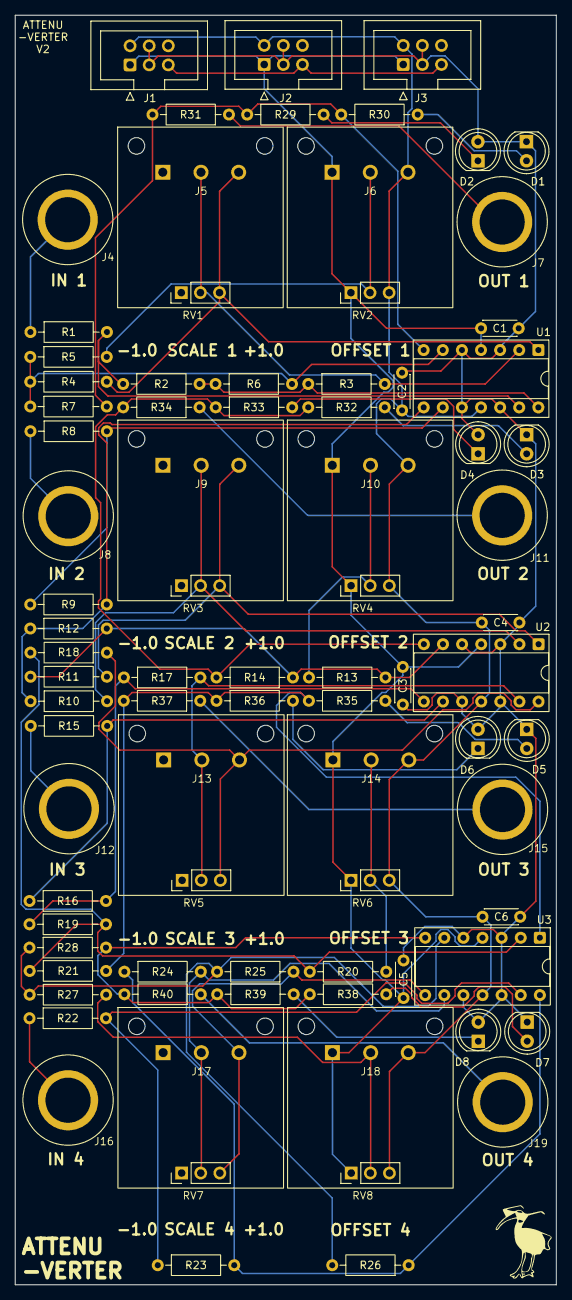
[picture p42: board attenuverter.kicad_pcb from above]

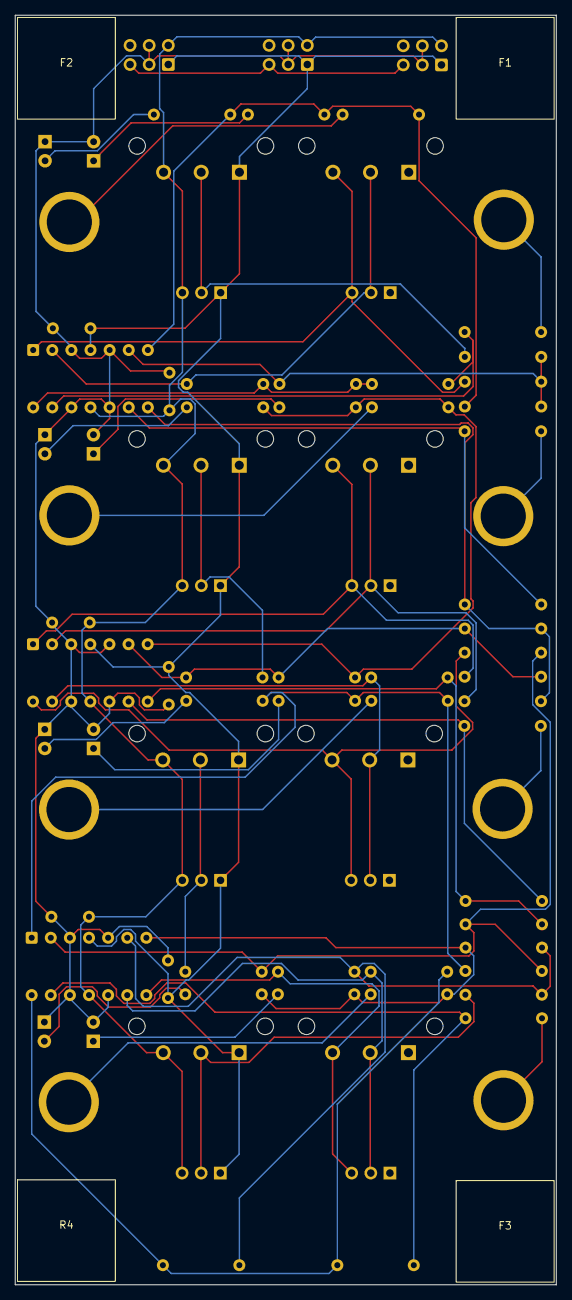
[picture p43: board attenuverter.kicad_pcb from below]

Board: 2 copper layers, 71.9 x 168.7 mm, 88 parts (4 on the bottom side), 48 nets.

Other parts of the board:
F1, F2, F3: foot
R4#2: foot
