gridbugs/modular2/power-supply/power-supply.kicad_pcb

## KiCad design power-supply/power-supply.kicad_pcb (2026-02-08)

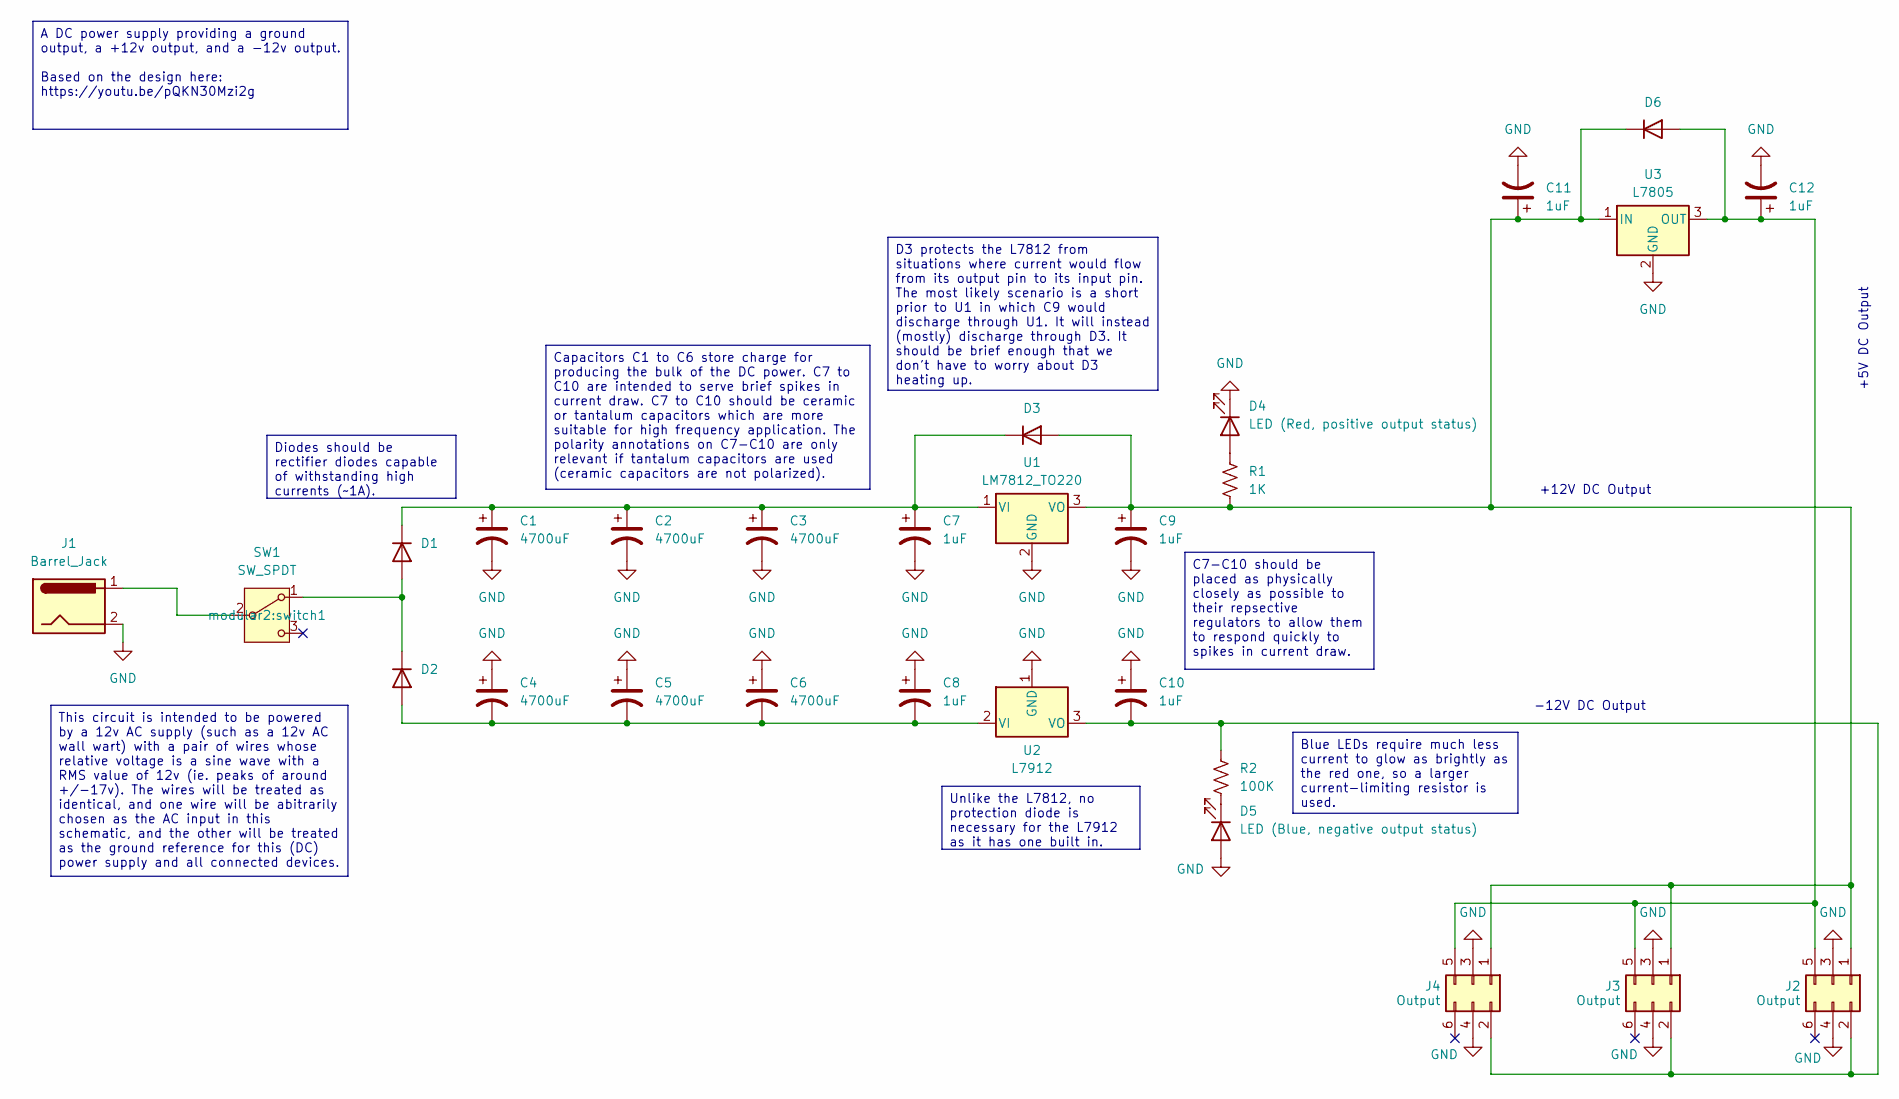
[picture p44: schematic power-supply.kicad_sch]

Parts:
C1, C2, C3, C4, C5, C6: 4700uF; CP_Radial_D18.0mm_P7.50mm
C7, C8, C9, C10, C11, C12: 1uF; CP_Radial_Tantal_D4.5mm_P2.50mm
D1, D2, D3, D6: Rectifier Diode; D_A-405_P7.62mm_Horizontal
D4: LED (Red, positive output status); LED_D5.0mm
D5: LED (Blue, negative output status); LED_D5.0mm
J1: Barrel_Jack; BarrelJack_GCT_DCJ200-10-A_Horizontal
J2, J3, J4: Output; IDC-Header_2x03_P2.54mm_Vertical
R1: 1K; R_Axial_DIN0207_L6.3mm_D2.5mm_P10.16mm_Horizontal
R2: 100K; R_Axial_DIN0207_L6.3mm_D2.5mm_P10.16mm_Horizontal
SW1: SW_SPDT; switch1
U1: LM7812_TO220; TO-220-3_Vertical
U2: L7912; TO-220-3_Vertical
U3: L7805; TO-220-3_Vertical

Connections:
GND: C1.2, C2.2, C3.2, C4.1, C5.1, C6.1, C7.2, C8.1, C9.2, C10.1, C11.2, C12.2, D4.1 (K), D5.2 (A), J1.2, J2.3, J2.4, J3.3, J3.4, J4.3, J4.4, U1.2 (GND), U2.1 (GND), U3.2 (GND)
unnamed: D1.2 (A), D2.1 (K), SW1.1 (A)
unnamed: C1.1, C2.1, C3.1, C7.1, D1.1 (K), D3.1 (K), U1.1 (VI)
unnamed: C4.2, C5.2, C6.2, C8.2, D2.2 (A), U2.2 (VI)
unnamed: C9.1, C11.1, D3.2 (A), D6.1 (K), J2.1, J3.1, J4.1, R1.2, U1.3 (VO), U3.1 (IN)
unnamed: D4.2 (A), R1.1
unnamed: D5.1 (K), R2.2
unnamed: C12.1, D6.2 (A), J2.5, J3.5, J4.5, U3.3 (OUT)
unnamed: C10.2, J2.2, J3.2, J4.2, R2.1, U2.3 (VO)
unnamed: J1.1, SW1.2 (B)

Notes on the sheet:
-12V DC Output
+12V DC Output
+5V DC Output
D3 protects the L7812 from situations where current would flow from its output pin to its input pin. The most likely scenario is a short prior to U1 in which C9 would discharge through U1. It will instead (mostly) discharge through D3. It should be brief enough that we don't have to worry about D3 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
Blue LEDs require much less current to glow as brightly as the red one, so a larger current-limiting resistor is used.
Unlike the L7812, no protection diode is necessary for the L7912 as it has one built in.
A DC power supply providing a ground output, a +12v output, and a -12v output. Based on the design here: https://youtu.be/pQKN30Mzi2g
This circuit is intended to be powered by a 12v AC supply (such as a 12v AC wall wart) with a pair of wires whose relative voltage is a sine wave with a RMS value of 12v (ie. peaks of around +/-17v). The wires will be treated as identical, and one wire will be abitrarily chosen as the AC input in t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
Diodes should be rectifier diodes capable of withstanding high currents (~1A).
C7-C10 should be placed as physically closely as possible to their repsective regulators to allow them to respond quickly to spikes in current draw.
Capacitors C1 to C6 store charge for producing the bulk of the DC power. C7 to C10 are intended to serve brief spikes in current draw. C7 to C10 should be ceramic or tantalum capacitors which are more suitable for high frequency application. The polarity annotations on C7-C10 are only relevant if t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

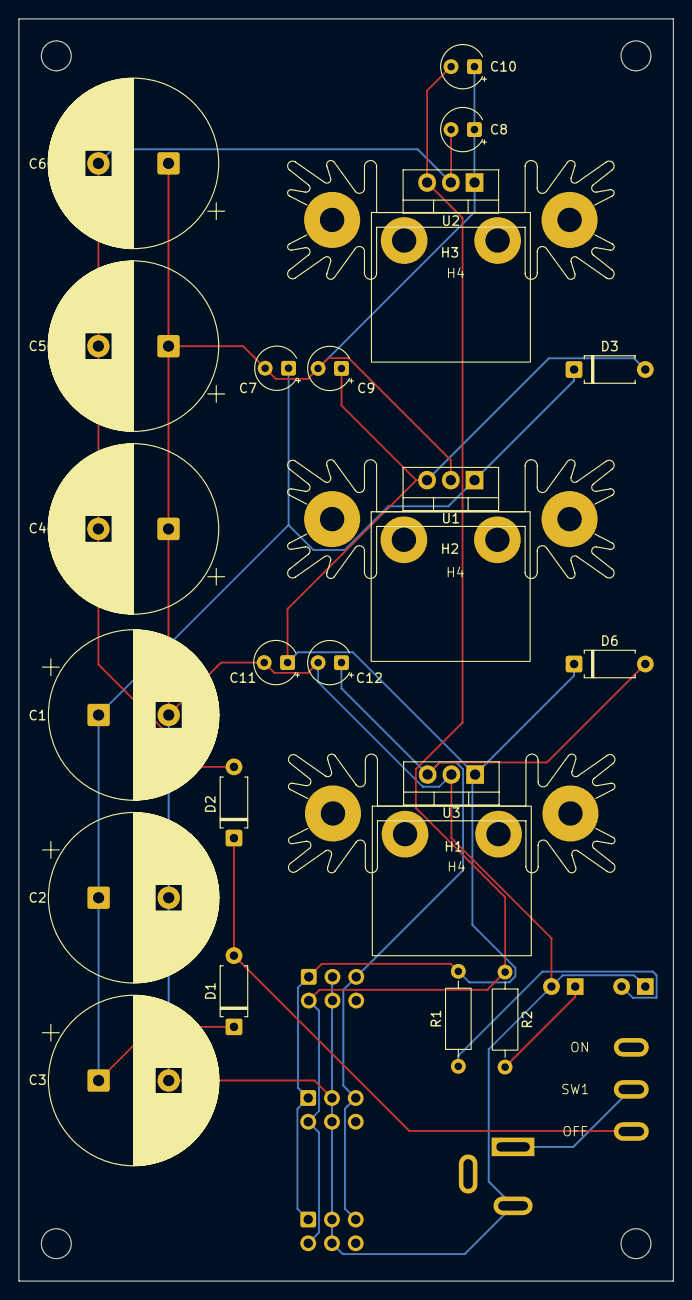
[picture p45: board power-supply.kicad_pcb from above]

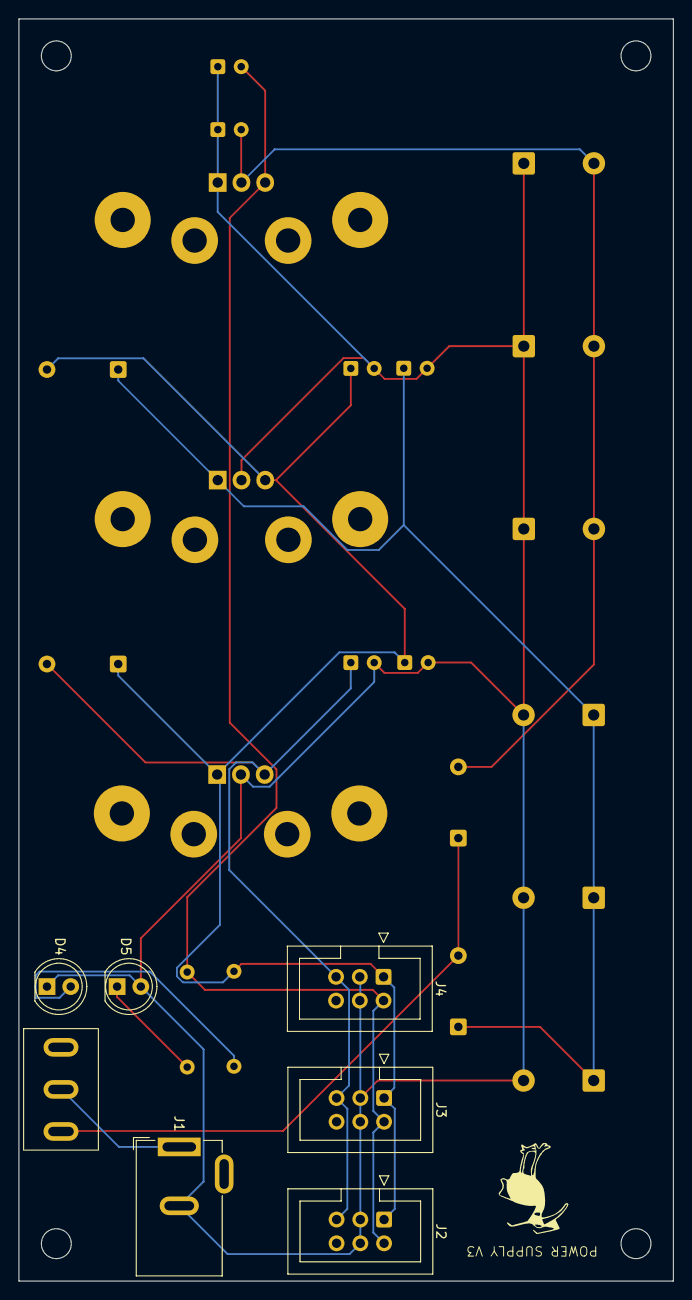
[picture p46: board power-supply.kicad_pcb from below]

Board: 2 copper layers, 70.0 x 135.0 mm, 34 parts (7 on the bottom side), 10 nets.

Other parts of the board:
H1, H2, H3: Heatsink_AAVID_Extruded_531002B02100G_34.9x12.7mm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; Heatsink_AAVID_Extruded_531002B02100G_34.9x12.7mm_H25.4mm
H4, H4#2, H4#3: heatsink to220
