gridbugs/modular2/oscillator/oscillator.kicad_pcb

## KiCad design oscillator/oscillator.kicad_pcb (2026-01-17)

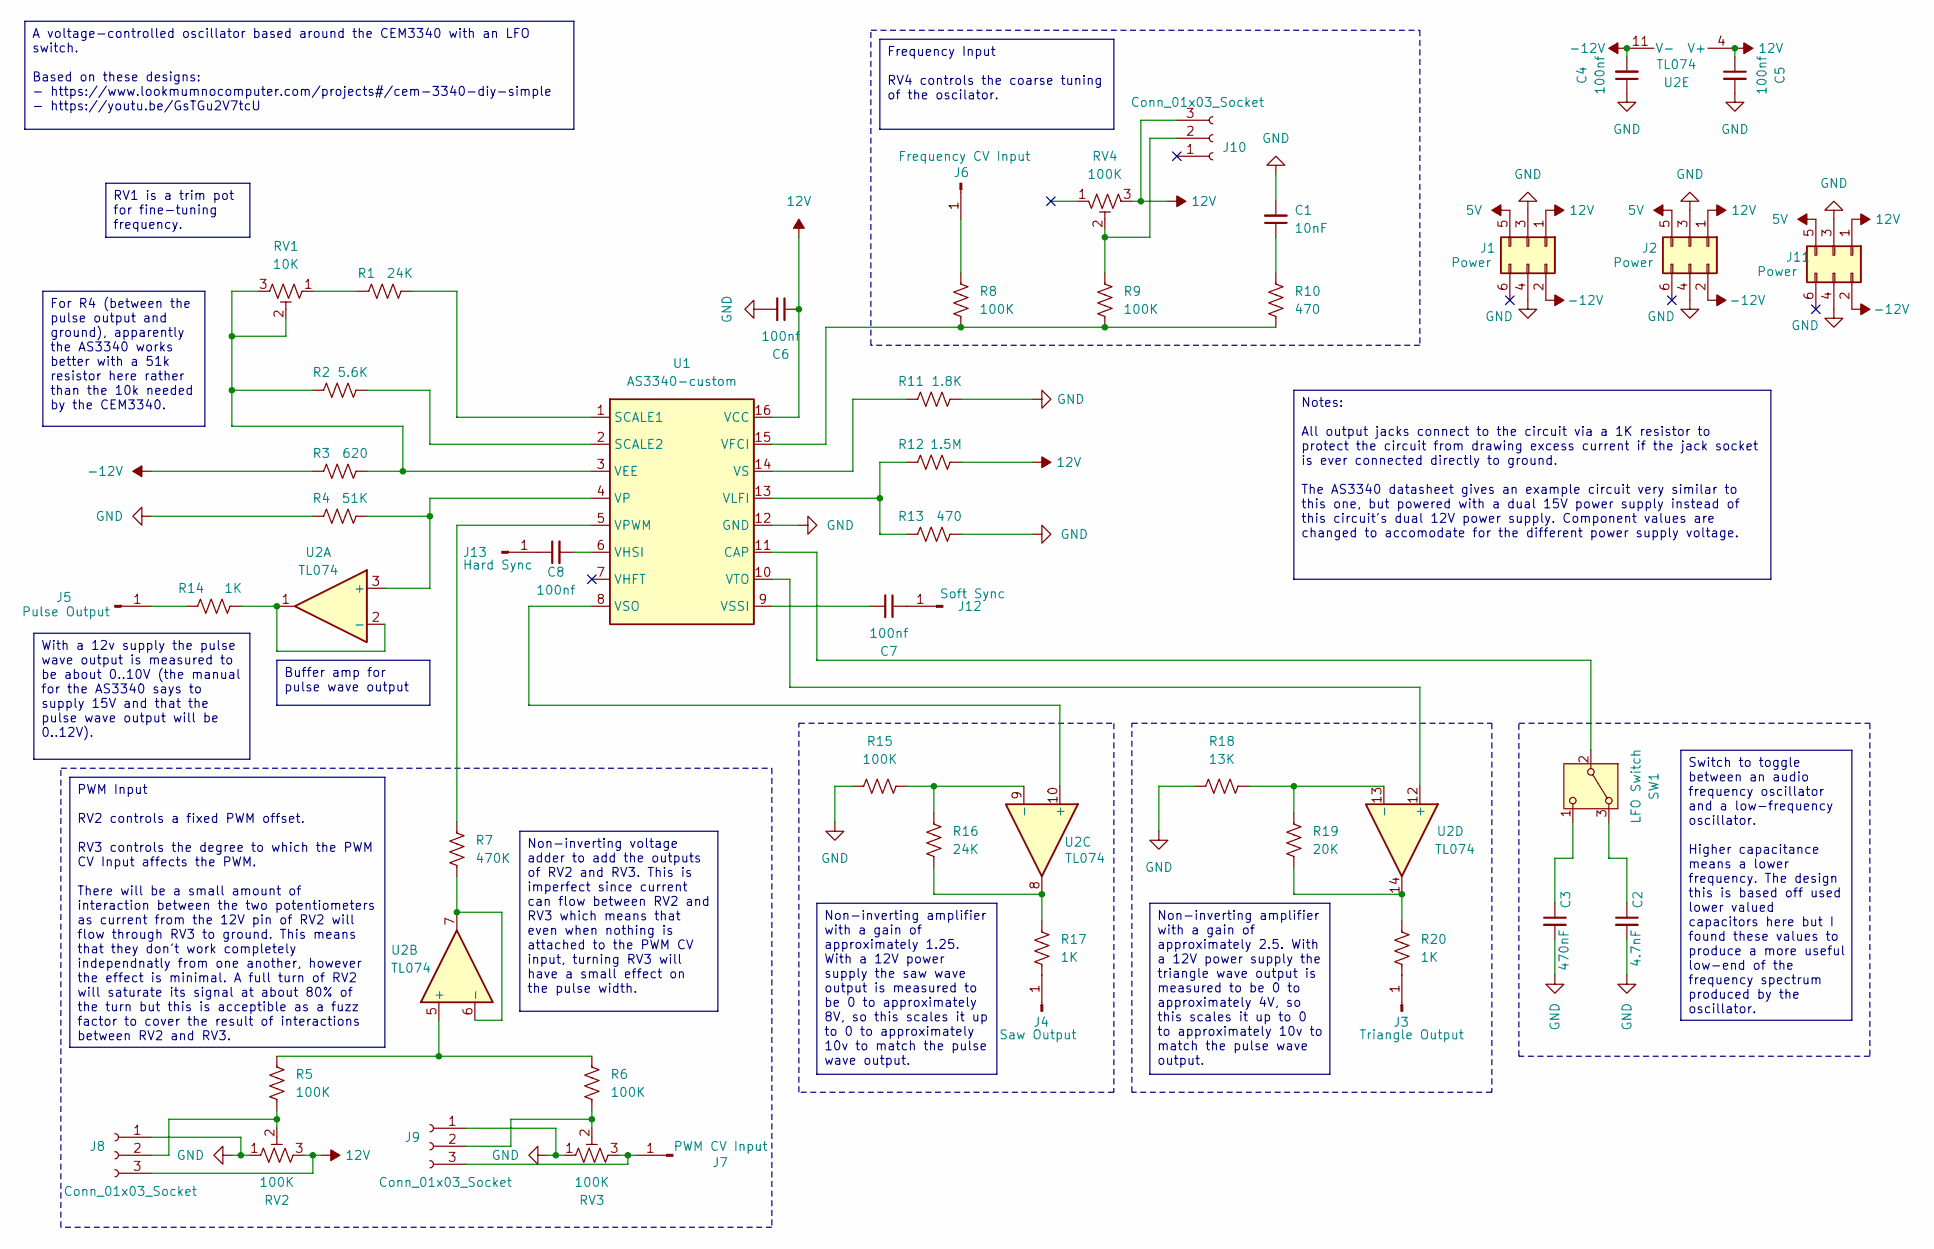
[picture p47: schematic oscillator.kicad_sch]

Parts:
C1: 10nF; C_Disc_D5.0mm_W2.5mm_P5.00mm
C2: 4.7nF; C_Disc_D5.0mm_W2.5mm_P5.00mm
C3: 470nF; C_Disc_D5.0mm_W2.5mm_P5.00mm
C4, C5, C6, C7, C8: 100nf; C_Disc_D4.3mm_W1.9mm_P5.00mm
J1, J2, J11: Power; IDC-Header_2x03_P2.54mm_Vertical
J3: Triangle Output; banana-jack
J4: Saw Output; banana-jack
J5: Pulse Output; banana-jack
J6: Frequency CV Input; banana-jack
J7: PWM CV Input; banana-jack
J8, J9, J10: Conn_01x03_Socket; pot
J12: Soft Sync; banana-jack
J13: Hard Sync; banana-jack
R1, R16: 24K; R_Axial_DIN0207_L6.3mm_D2.5mm_P10.16mm_Horizontal
R2: 5.6K; R_Axial_DIN0207_L6.3mm_D2.5mm_P10.16mm_Horizontal
R3: 620; R_Axial_DIN0207_L6.3mm_D2.5mm_P10.16mm_Horizontal
R4: 51K; R_Axial_DIN0207_L6.3mm_D2.5mm_P10.16mm_Horizontal
R5, R6, R8, R9, R15: 100K; R_Axial_DIN0207_L6.3mm_D2.5mm_P10.16mm_Horizontal
R7: 470K; R_Axial_DIN0207_L6.3mm_D2.5mm_P10.16mm_Horizontal
R10, R13: 470; R_Axial_DIN0207_L6.3mm_D2.5mm_P10.16mm_Horizontal
R11: 1.8K; R_Axial_DIN0207_L6.3mm_D2.5mm_P10.16mm_Horizontal
R12: 1.5M; R_Axial_DIN0207_L6.3mm_D2.5mm_P10.16mm_Horizontal
R14, R17, R20: 1K; R_Axial_DIN0207_L6.3mm_D2.5mm_P10.16mm_Horizontal
R18: 13K; R_Axial_DIN0207_L6.3mm_D2.5mm_P10.16mm_Horizontal
R19: 20K; R_Axial_DIN0207_L6.3mm_D2.5mm_P10.16mm_Horizontal
RV1: 10K; Potentiometer_Bourns_3296W_Vertical
RV2, RV3, RV4: 100K; pot-socket
SW1: LFO Switch; switch1
U1: AS3340-custom; DIP-16_W7.62mm_Socket
U2: TL074; DIP-14_W7.62mm_Socket

Connections:
5V: J1.5, J2.5, J11.5
12V: C5.1, C6.1, J1.1, J2.1, J8.3, J10.3, J11.1, R12.2, RV2.3, RV4.3, U1.16 (VCC), U2.4 (V+)
-12V: C4.2, J1.2, J2.2, J11.2, R3.1, U2.11 (V-)
GND: C1.2, C2.2, C3.2, C4.1, C5.2, C6.2, J1.3, J1.4, J2.3, J2.4, J8.1, J9.1, J11.3, J11.4, R4.1, R11.2, R13.2, R15.1, R18.1, RV2.1, RV3.1, U1.12 (GND)
unnamed: C1.1, R10.1
unnamed: J3.1, R20.2
unnamed: J4.1, R17.2
unnamed: J5.1, R14.1
unnamed: J6.1, R8.1
unnamed: J7.1, J9.3, RV3.3
unnamed: J8.2, R5.2, RV2.2
unnamed: J9.2, R6.2, RV3.2
unnamed: J10.2, R9.1, RV4.2
unnamed: C7.1, J12.1
unnamed: C8.1, J13.1
unnamed: R1.1, RV1.1
unnamed: R16.2, R17.1, U2.8
unnamed: R19.2, R20.1, U2.14
unnamed: C2.1, SW1.3 (A)
unnamed: SW1.2 (B), U1.11 (CAP)
unnamed: C3.1, SW1.1 (C)
unnamed: R1.2, U1.1 (SCALE1)
unnamed: R2.2, U1.2 (SCALE2)
unnamed: R2.1, R3.2, RV1.2, RV1.3, U1.3 (VEE)
unnamed: R8.2, R9.2, R10.2, U1.15 (VFCI)
unnamed: C8.2, U1.6 (VHSI)
unnamed: R12.1, R13.1, U1.13 (VLFI)
unnamed: R4.2, U1.4 (VP), U2.3 (+)
unnamed: R7.1, U1.5 (VPWM)
unnamed: R11.1, U1.14 (VS)
unnamed: U1.8 (VSO), U2.10 (+)
unnamed: C7.2, U1.9 (VSSI)
unnamed: U1.10 (VTO), U2.12 (+)
unnamed: R14.2, U2.1, U2.2 (-)
unnamed: R5.1, R6.1, U2.5 (+)
unnamed: R7.2, U2.6 (-), U2.7
unnamed: R15.2, R16.1, U2.9 (-)
unnamed: R18.2, R19.1, U2.13 (-)

Notes on the sheet:
Notes: All output jacks connect to the circuit via a 1K resistor to protect the circuit from drawing excess current if the jack socket is ever connected directly to ground. The AS3340 datasheet gives an example circuit very similar to this one, but powered with a dual 15V power supply instead of th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
Switch to toggle between an audio frequency oscillator and a low-frequency oscillator. Higher capacitance means a lower frequency. The design this is based off used lower valued capacitors here but I found these values to produce a more useful low-end of the frequency spectrum produced by the oscil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
With a 12v supply the pulse wave output is measured to be about 0..10V (the manual for the AS3340 says to supply 15V and that the pulse wave output will be 0..12V).
Frequency Input RV4 controls the coarse tuning of the oscilator.
RV1 is a trim pot for fine-tuning frequency.
Non-inverting amplifier with a gain of approximately 1.25. With a 12V power supply the saw wave output is measured to be 0 to approximately 8V, so this scales it up to 0 to approximately 10v to match the pulse wave output.
For R4 (between the pulse output and ground), apparently the AS3340 works better with a 51k resistor here rather than the 10k needed by the CEM3340.
A voltage-controlled oscillator based around the CEM3340 with an LFO switch. Based on these designs: - https://www.lookmumnocomputer.com/projects#/cem-3340-diy-simple - https://youtu.be/GsTGu2V7tcU
Non-inverting voltage adder to add the outputs of RV2 and RV3. This is imperfect since current can flow between RV2 and RV3 which means that even when nothing is attached to the PWM CV input, turning RV3 will have a small effect on the pulse width.
Non-inverting amplifier with a gain of approximately 2.5. With a 12V power supply the triangle wave output is measured to be 0 to approximately 4V, so this scales it up to 0 to approximately 10v to match the pulse wave output.
Buffer amp for pulse wave output
PWM Input RV2 controls a fixed PWM offset. RV3 controls the degree to which the PWM CV Input affects the PWM. There will be a small amount of interaction between the two potentiometers as current from the 12V pin of RV2 will flow through RV3 to ground. This means that they don't work completely ind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
