gridbugs/modular2/oscillator/oscillator.kicad_pcb

## KiCad design oscillator/oscillator.kicad_pcb (continued)

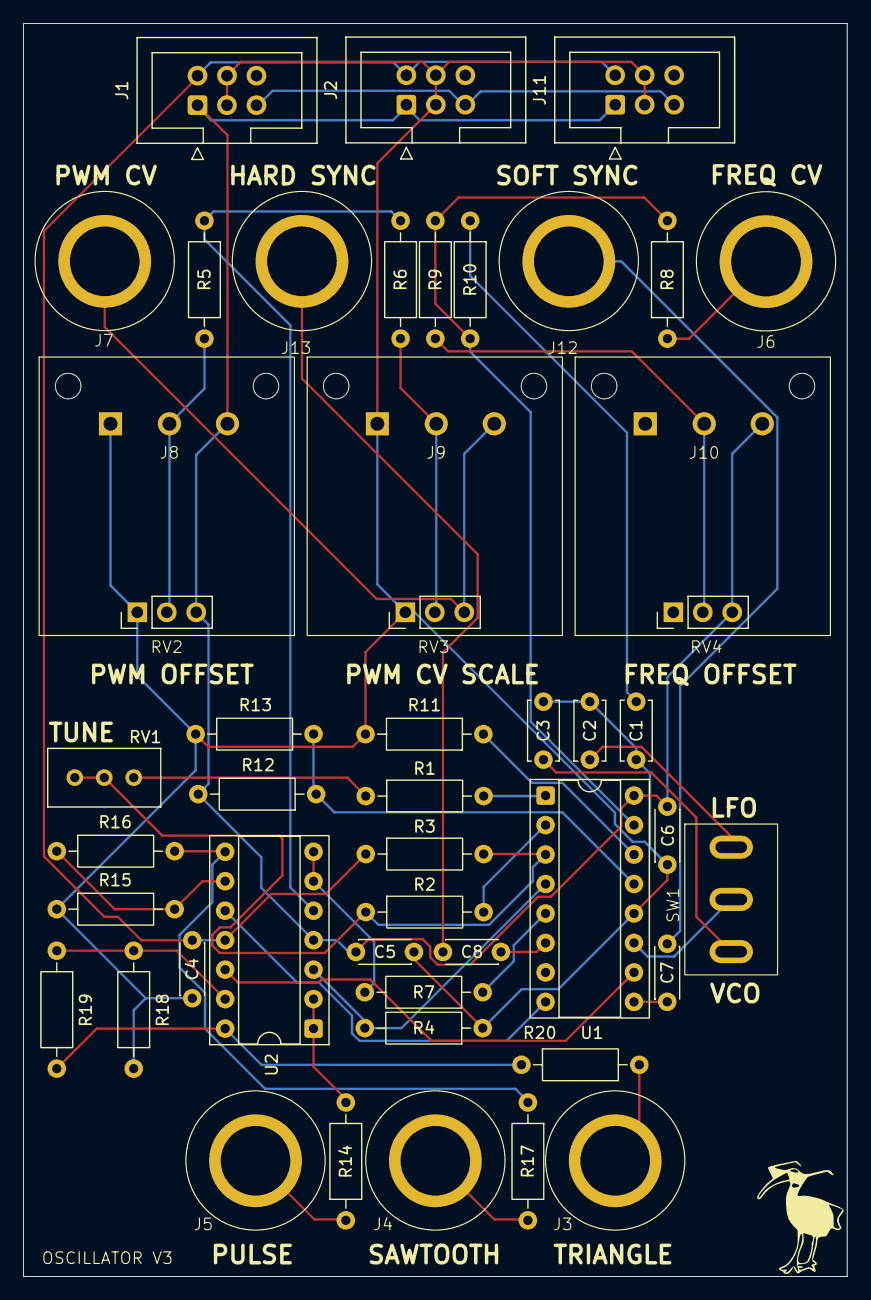
[picture p48: board oscillator.kicad_pcb from above]

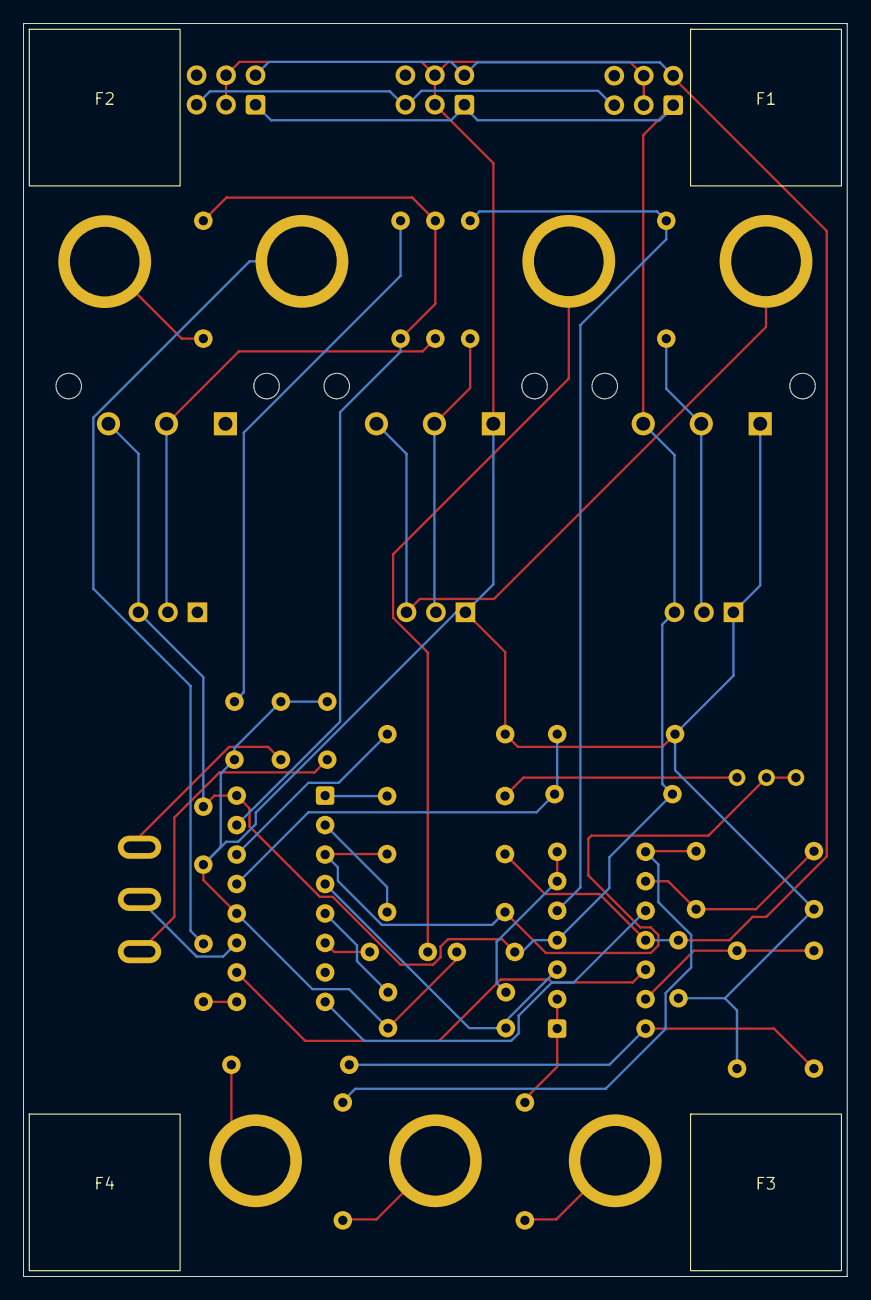
[picture p49: board oscillator.kicad_pcb from below]

Board: 2 copper layers, 71.0 x 108.0 mm, 52 parts (4 on the bottom side), 38 nets.

Other parts of the board:
F1, F2, F3, F4: foot
