gridbugs/modular2/envelope-generator/envelope-generator.kicad_pcb

## KiCad design envelope-generator/envelope-generator.kicad_pcb (2026-01-17)

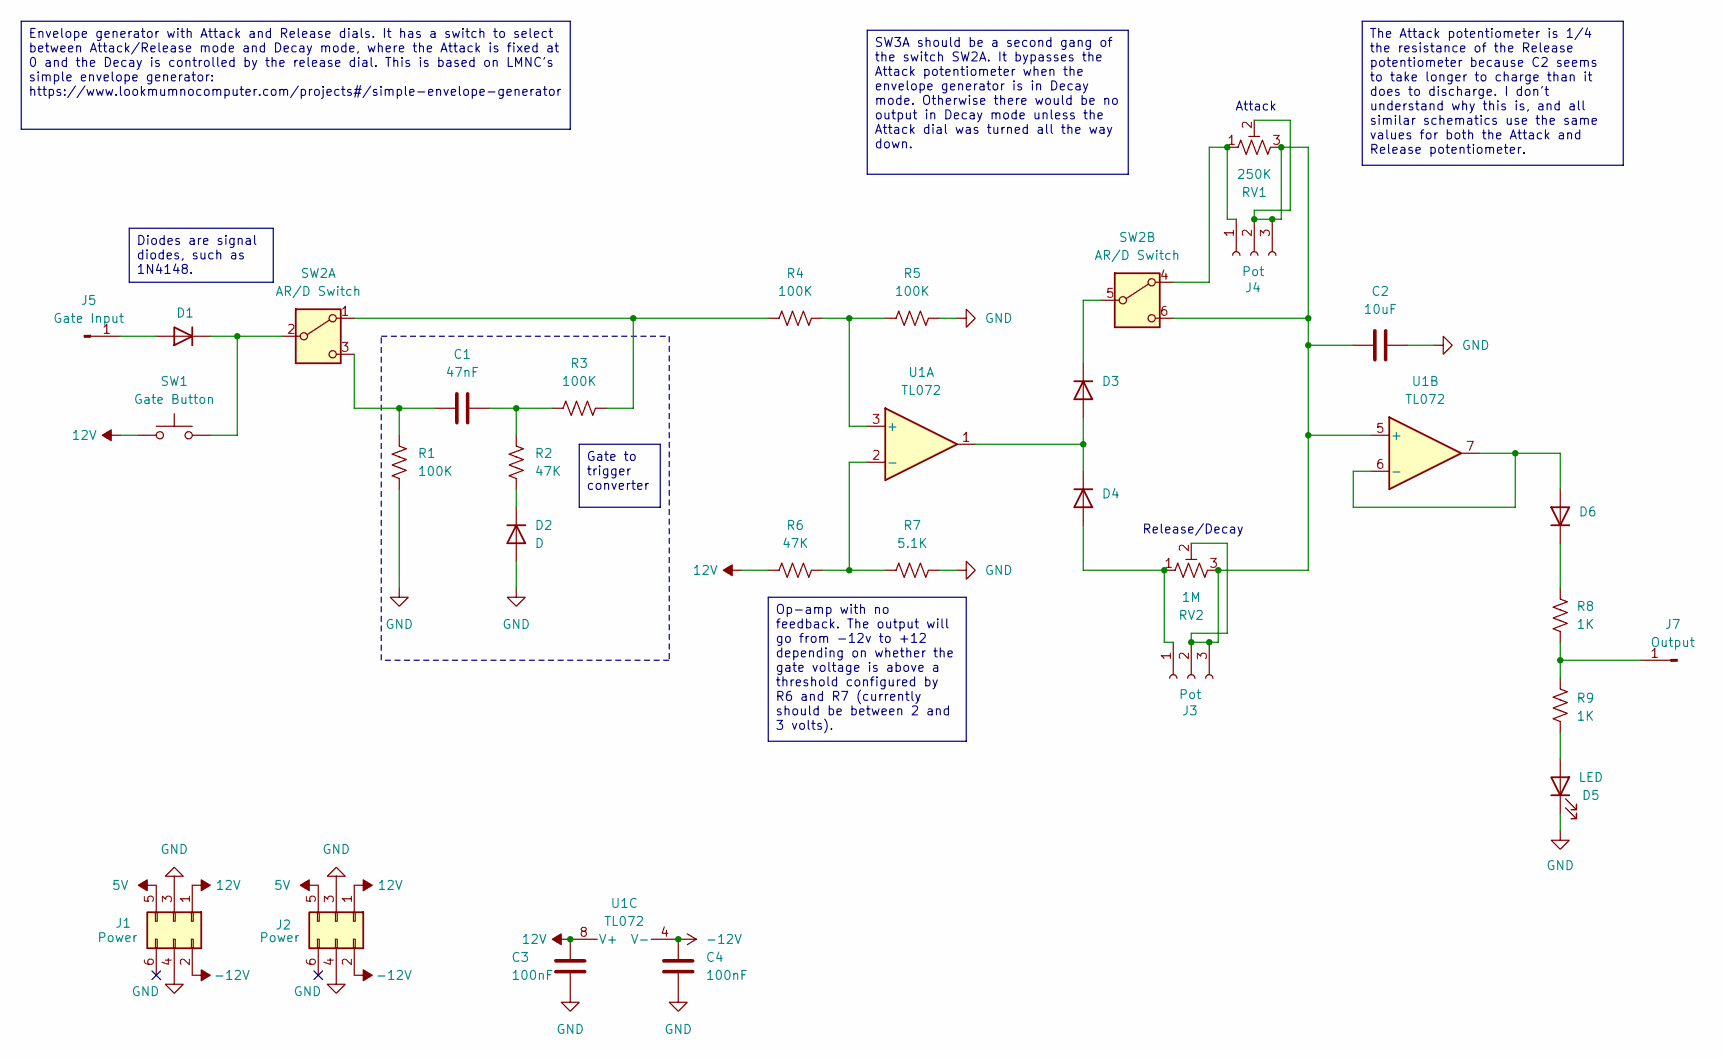
[picture p50: schematic envelope-generator.kicad_sch]

Parts:
C1: 47nF; C_Disc_D4.3mm_W1.9mm_P5.00mm
C2: 10uF; C_Disc_D4.3mm_W1.9mm_P5.00mm
C3, C4: 100nF; C_Disc_D4.3mm_W1.9mm_P5.00mm
D1, D2, D3: D; D_A-405_P7.62mm_Horizontal
D4, D6: D_A-405_P7.62mm_Horizontal
D5: LED; LED_D5.0mm
J1, J2: Power; IDC-Header_2x03_P2.54mm_Vertical
J3, J4: Pot; pot
J5: Gate Input; banana-jack
J7: Output; banana-jack
R1, R3, R4, R5: 100K; R_Axial_DIN0207_L6.3mm_D2.5mm_P10.16mm_Horizontal
R2, R6: 47K; R_Axial_DIN0207_L6.3mm_D2.5mm_P10.16mm_Horizontal
R7: 5.1K; R_Axial_DIN0207_L6.3mm_D2.5mm_P10.16mm_Horizontal
R8, R9: 1K; R_Axial_DIN0207_L6.3mm_D2.5mm_P10.16mm_Horizontal
RV1: 250K; pot-socket
RV2: 1M; pot-socket
SW1: Gate Button; SW_Cherry_MX_1.00u_PCB
SW2: AR/D Switch; switch2
U1: TL072; DIP-8_W7.62mm_Socket

Connections:
5V: J1.5, J2.5
12V: C3.2, J1.1, J2.1, R6.2, SW1.1, U1.8 (V+)
-12V: C4.2, J1.2, J2.2, U1.4 (V-)
GND: C2.2, C3.1, C4.1, D2.2 (A), D5.1 (K), J1.3, J1.4, J2.3, J2.4, R1.1, R5.1, R7.1
unnamed: C1.2, R2.2, R3.2
unnamed: D1.2 (A), J5.1
unnamed: D1.1 (K), SW1.2, SW2.2 (B)
unnamed: D2.1 (K), R2.1
unnamed: D3.2 (A), D4.1 (K), U1.1
unnamed: D3.1 (K), SW2.5 (B)
unnamed: D4.2 (A), J3.1, RV2.1
unnamed: D5.2 (A), R9.1
unnamed: D6.2 (A), U1.6 (-), U1.7
unnamed: D6.1 (K), R8.2
unnamed: C2.1, J3.2, J3.3, J4.2, J4.3, RV1.2, RV1.3, RV2.2, RV2.3, SW2.6 (C), U1.5 (+)
unnamed: J4.1, RV1.1, SW2.4 (A)
unnamed: J7.1, R8.1, R9.2
unnamed: R3.1, R4.2, SW2.1 (A)
unnamed: C1.1, R1.2, SW2.3 (C)
unnamed: R4.1, R5.2, U1.3 (+)
unnamed: R6.1, R7.2, U1.2 (-)

Notes on the sheet:
Attack
Release/Decay
SW3A should be a second gang of the switch SW2A. It bypasses the Attack potentiometer when the envelope generator is in Decay mode. Otherwise there would be no output in Decay mode unless the Attack dial was turned all the way down.
Diodes are signal diodes, such as 1N4148.
Envelope generator with Attack and Release dials. It has a switch to select between Attack/Release mode and Decay mode, where the Attack is fixed at 0 and the Decay is controlled by the release dial. This is based on LMNC's simple envelope generator: https://www.lookmumnocomputer.com/projects#/simp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
Gate to trigger converter
The Attack potentiometer is 1/4 the resistance of the Release potentiometer because C2 seems to take longer to charge than it does to discharge. I don't understand why this is, and all similar schematics use the same values for both the Attack and Release potentiometer.
Op-amp with no feedback. The output will go from -12v to +12 depending on whether the gate voltage is above a threshold configured by R6 and R7 (currently should be between 2 and 3 volts).

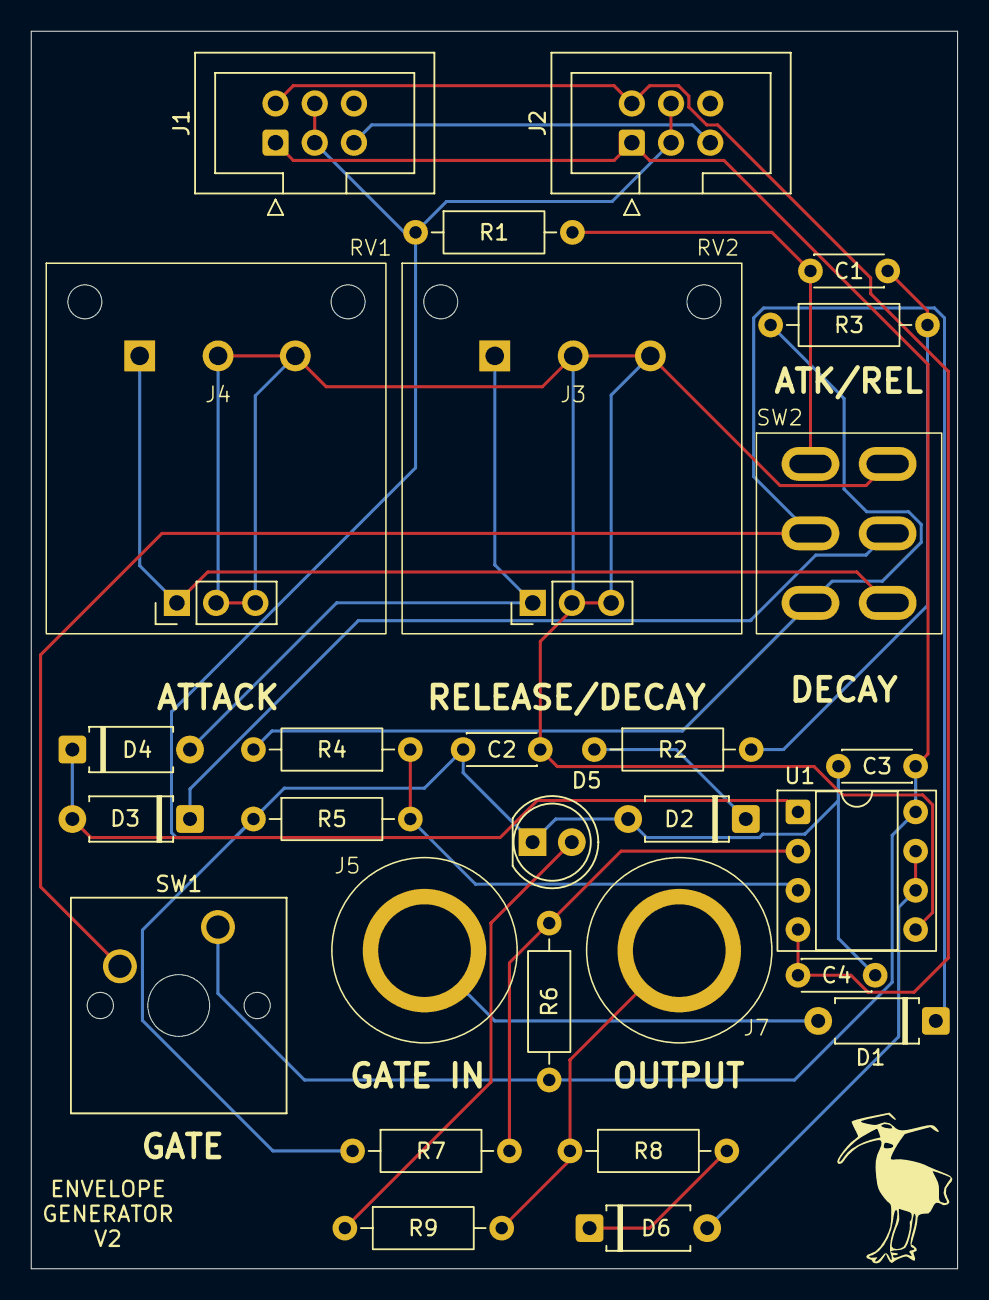
[picture p51: board envelope-generator.kicad_pcb from above]

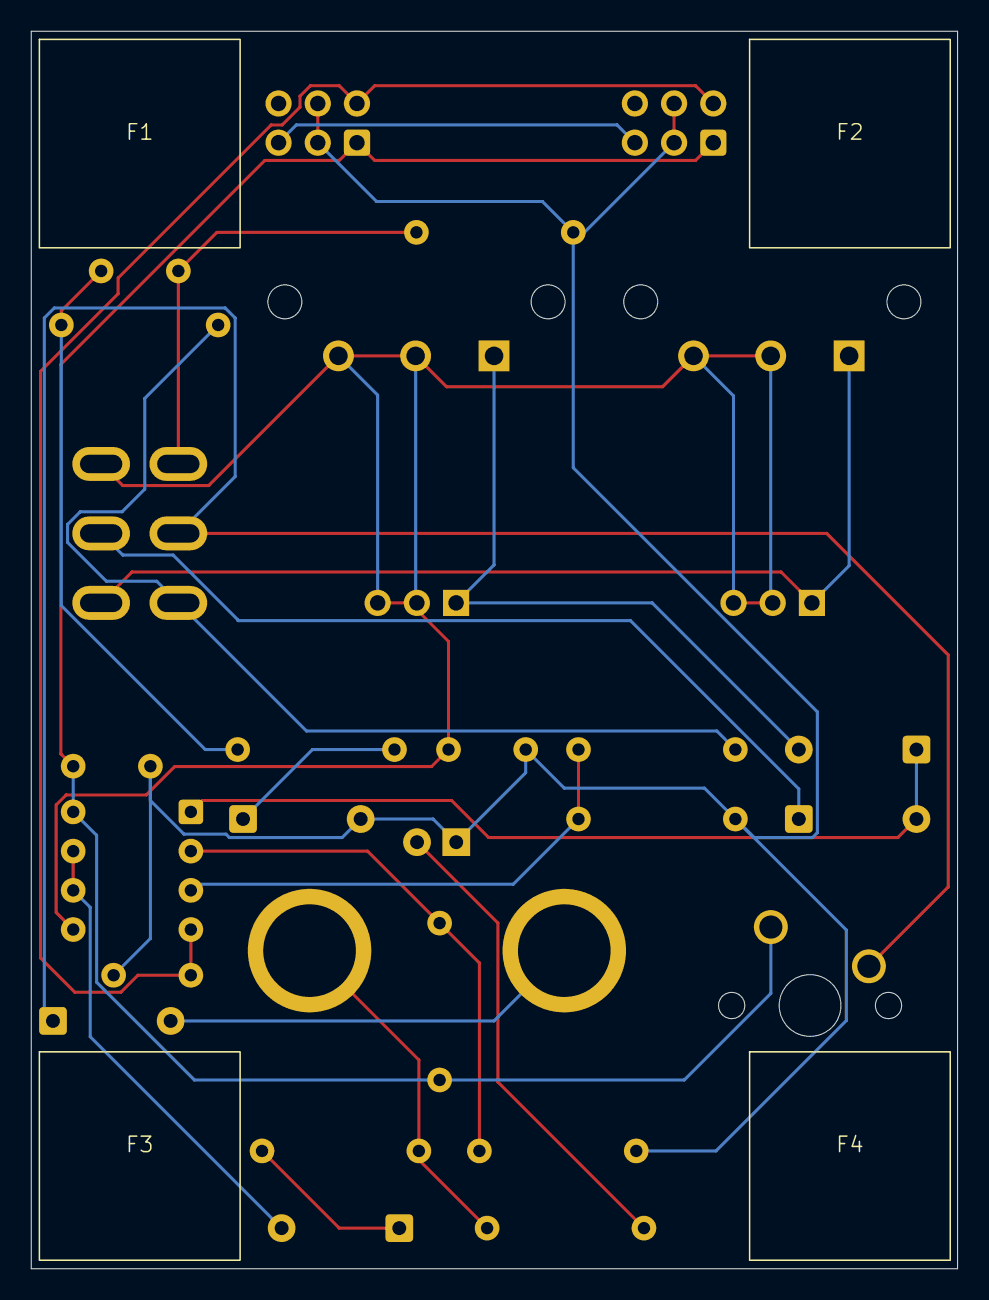
[picture p52: board envelope-generator.kicad_pcb from below]

Board: 2 copper layers, 60.0 x 80.2 mm, 34 parts (4 on the bottom side), 21 nets.

Other parts of the board:
F1, F2, F3, F4: foot
