gridbugs/modular2/low-pass-filter/low-pass-filter.kicad_pcb

## KiCad design low-pass-filter/low-pass-filter.kicad_pcb (2026-01-15)

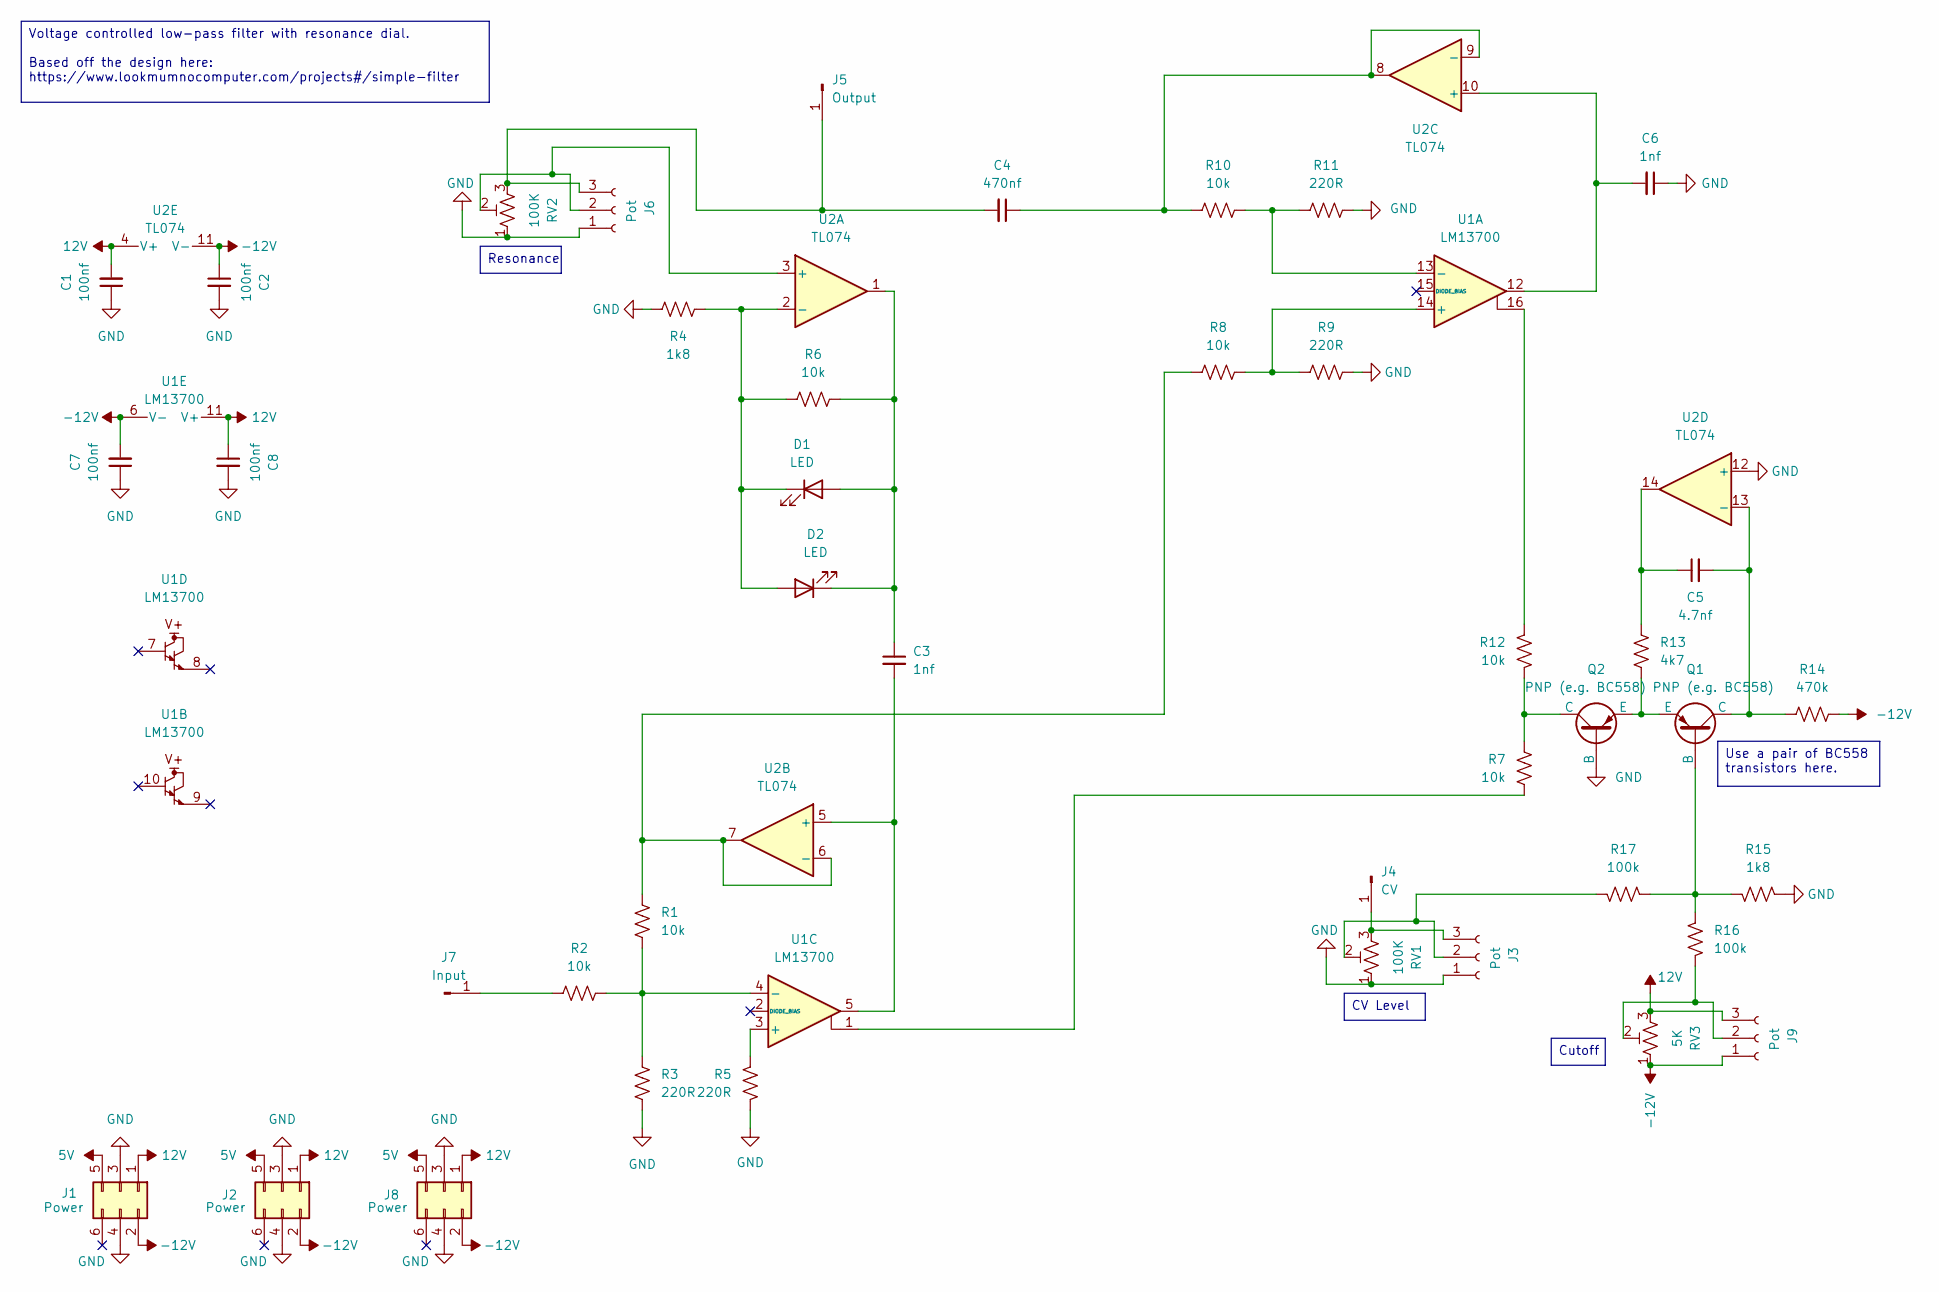
[picture p53: schematic low-pass-filter.kicad_sch]

Parts:
C1, C2, C7, C8: 100nf; C_Disc_D4.3mm_W1.9mm_P5.00mm
C3, C6: 1nf; C_Disc_D4.3mm_W1.9mm_P5.00mm
C4: 470nf; C_Disc_D4.3mm_W1.9mm_P5.00mm
C5: 4.7nf; C_Disc_D4.3mm_W1.9mm_P5.00mm
D1, D2: LED; LED_D5.0mm
J1, J2, J8: Power; IDC-Header_2x03_P2.54mm_Vertical
J3, J6, J9: Pot; pot
J4: CV; banana-jack
J5: Output; banana-jack
J7: Input; banana-jack
Q1, Q2: PNP (e.g. BC558); TO-92
R1, R2, R6, R7, R8, R10, R12: 10k; R_Axial_DIN0207_L6.3mm_D2.5mm_P10.16mm_Horizontal
R3, R5, R9, R11: 220R; R_Axial_DIN0207_L6.3mm_D2.5mm_P10.16mm_Horizontal
R4, R15: 1k8; R_Axial_DIN0207_L6.3mm_D2.5mm_P10.16mm_Horizontal
R13: 4k7; R_Axial_DIN0207_L6.3mm_D2.5mm_P10.16mm_Horizontal
R14: 470k; R_Axial_DIN0207_L6.3mm_D2.5mm_P10.16mm_Horizontal
R16, R17: 100k; R_Axial_DIN0207_L6.3mm_D2.5mm_P10.16mm_Horizontal
RV1, RV2: 100K; pot-socket
RV3: 5K; pot-socket
U1: LM13700; DIP-16_W7.62mm_Socket
U2: TL074; DIP-14_W7.62mm_Socket

Connections:
5V: J1.5, J2.5, J8.5
12V: C1.2, C8.1, J1.1, J2.1, J8.1, J9.3, RV3.3, U1.11 (V+), U2.4 (V+)
-12V: C2.1, C7.2, J1.2, J2.2, J8.2, J9.1, R14.2, RV3.1, U1.6 (V-), U2.11 (V-)
GND: C1.1, C2.2, C6.1, C7.1, C8.2, J1.3, J1.4, J2.3, J2.4, J3.1, J6.1, J8.3, J8.4, Q2.2 (B), R3.2, R4.2, R5.1, R9.2, R11.2, R15.1, RV1.1, RV2.1, U2.12 (+)
unnamed: C5.1, R13.2, U2.14
unnamed: C3.1, D1.2 (A), D2.1 (K), R6.1, U2.1
unnamed: D1.1 (K), D2.2 (A), R4.1, R6.2, U2.2 (-)
unnamed: J3.2, R17.1, RV1.2
unnamed: J3.3, J4.1, RV1.3
unnamed: C4.2, J5.1, J6.3, RV2.3
unnamed: J6.2, RV2.2, U2.3 (+)
unnamed: J7.1, R2.2
unnamed: J9.2, R16.2, RV3.2
unnamed: Q1.2 (B), R15.2, R16.1, R17.2
unnamed: C5.2, Q1.1 (C), R14.1, U2.13 (-)
unnamed: Q1.3 (E), Q2.3 (E), R13.1
unnamed: Q2.1 (C), R7.1, R12.1
unnamed: R7.2, U1.1
unnamed: R12.2, U1.16
unnamed: R8.2, R9.1, U1.14 (+)
unnamed: R10.1, R11.1, U1.13 (-)
unnamed: R5.2, U1.3 (+)
unnamed: R1.2, R2.1, R3.1, U1.4 (-)
unnamed: C3.2, U1.5, U2.5 (+)
unnamed: R1.1, R8.1, U2.6 (-), U2.7
unnamed: C6.2, U1.12, U2.10 (+)
unnamed: C4.1, R10.2, U2.8, U2.9 (-)

Notes on the sheet:
Resonance
CV Level
Use a pair of BC558 transistors here.
Cutoff
Voltage controlled low-pass filter with resonance dial. Based off the design here: https://www.lookmumnocomputer.com/projects#/simple-filter

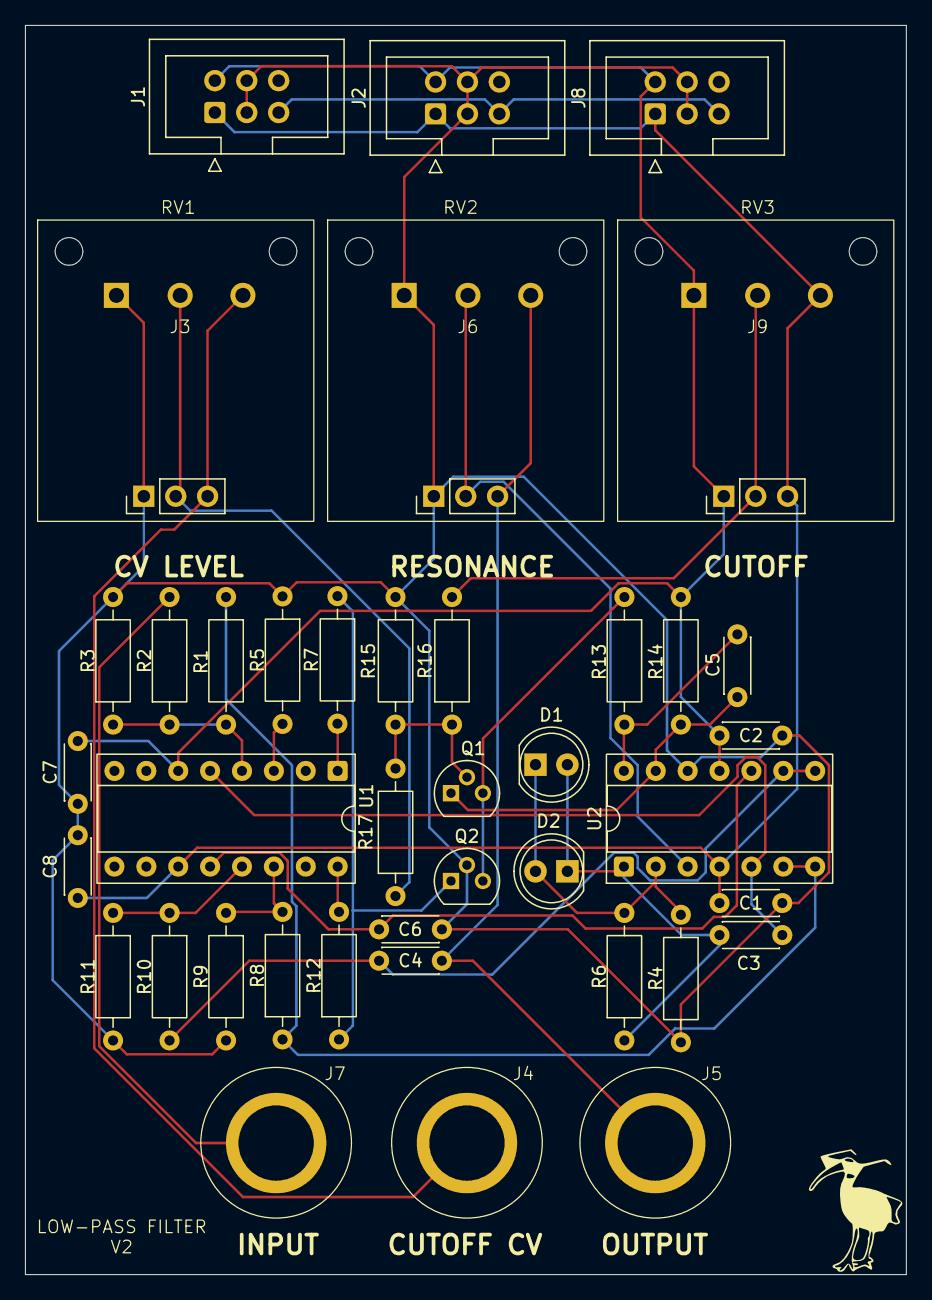
[picture p54: board low-pass-filter.kicad_pcb from above]

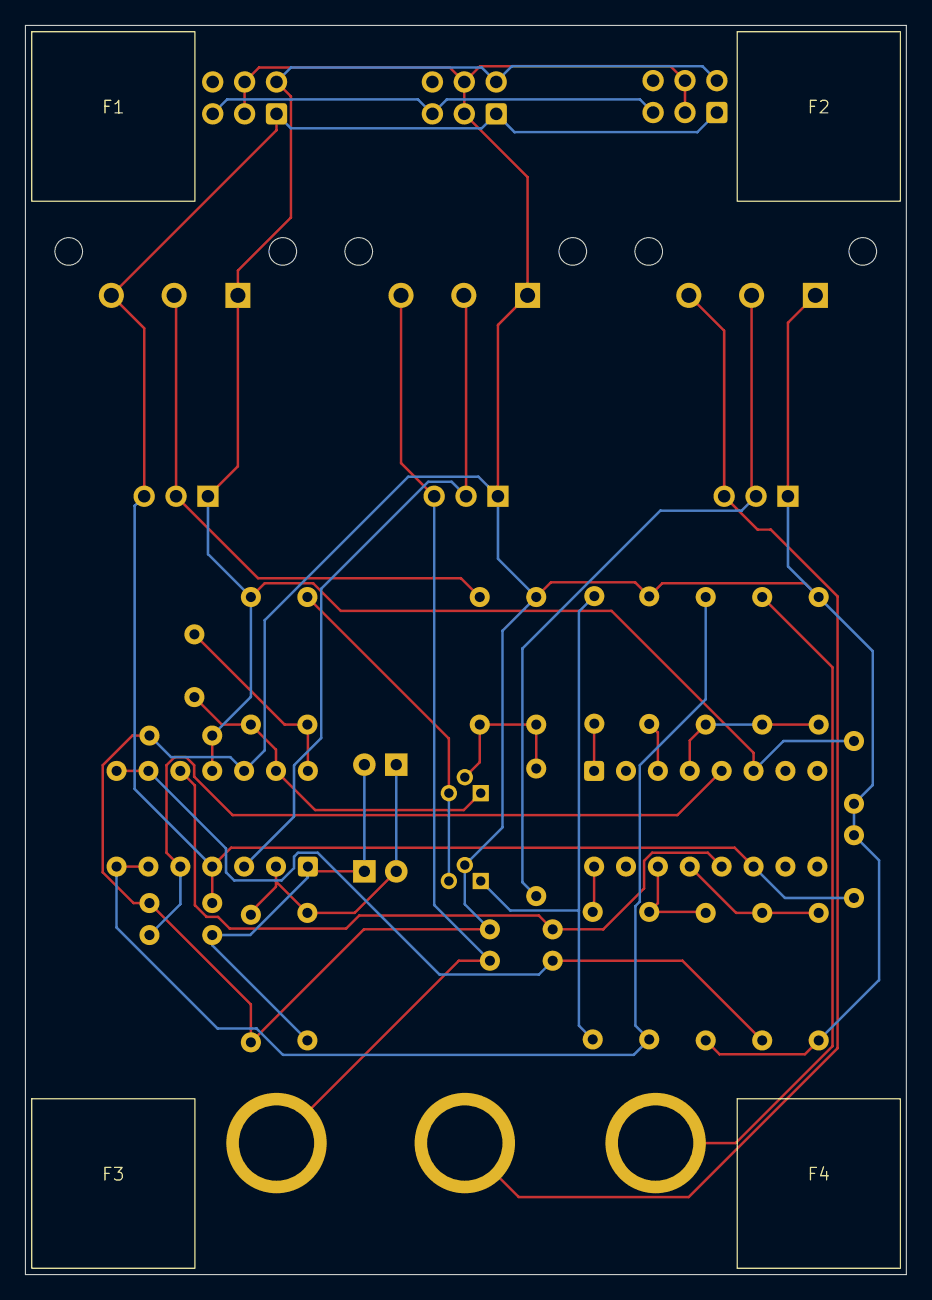
[picture p55: board low-pass-filter.kicad_pcb from below]

Board: 2 copper layers, 70.2 x 99.5 mm, 47 parts (4 on the bottom side), 27 nets.

Other parts of the board:
F1, F2, F3, F4: foot
