gridbugs/modular2/power-expander/power-expander.kicad_pcb

## KiCad design power-expander/power-expander.kicad_pcb (2026-01-10)

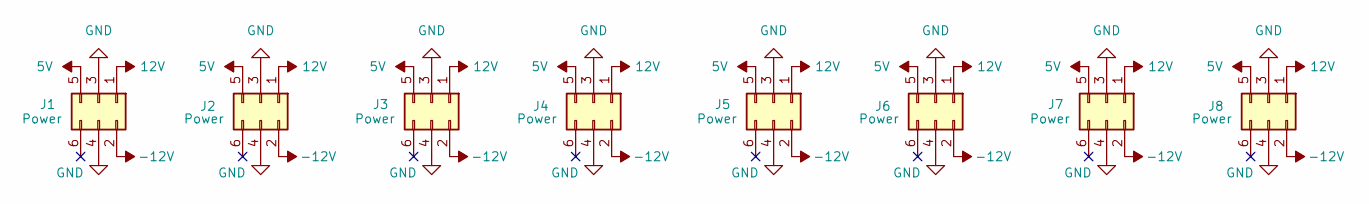
[picture p56: schematic power-expander.kicad_sch]

Parts:
J1, J2, J3, J4, J5, J6, J7, J8: Power; IDC-Header_2x03_P2.54mm_Vertical

Connections:
5V: J1.5, J2.5, J3.5, J4.5, J5.5, J6.5, J7.5, J8.5
12V: J1.1, J2.1, J3.1, J4.1, J5.1, J6.1, J7.1, J8.1
-12V: J1.2, J2.2, J3.2, J4.2, J5.2, J6.2, J7.2, J8.2
GND: J1.3, J1.4, J2.3, J2.4, J3.3, J3.4, J4.3, J4.4, J5.3, J5.4, J6.3, J6.4, J7.3, J7.4, J8.3, J8.4

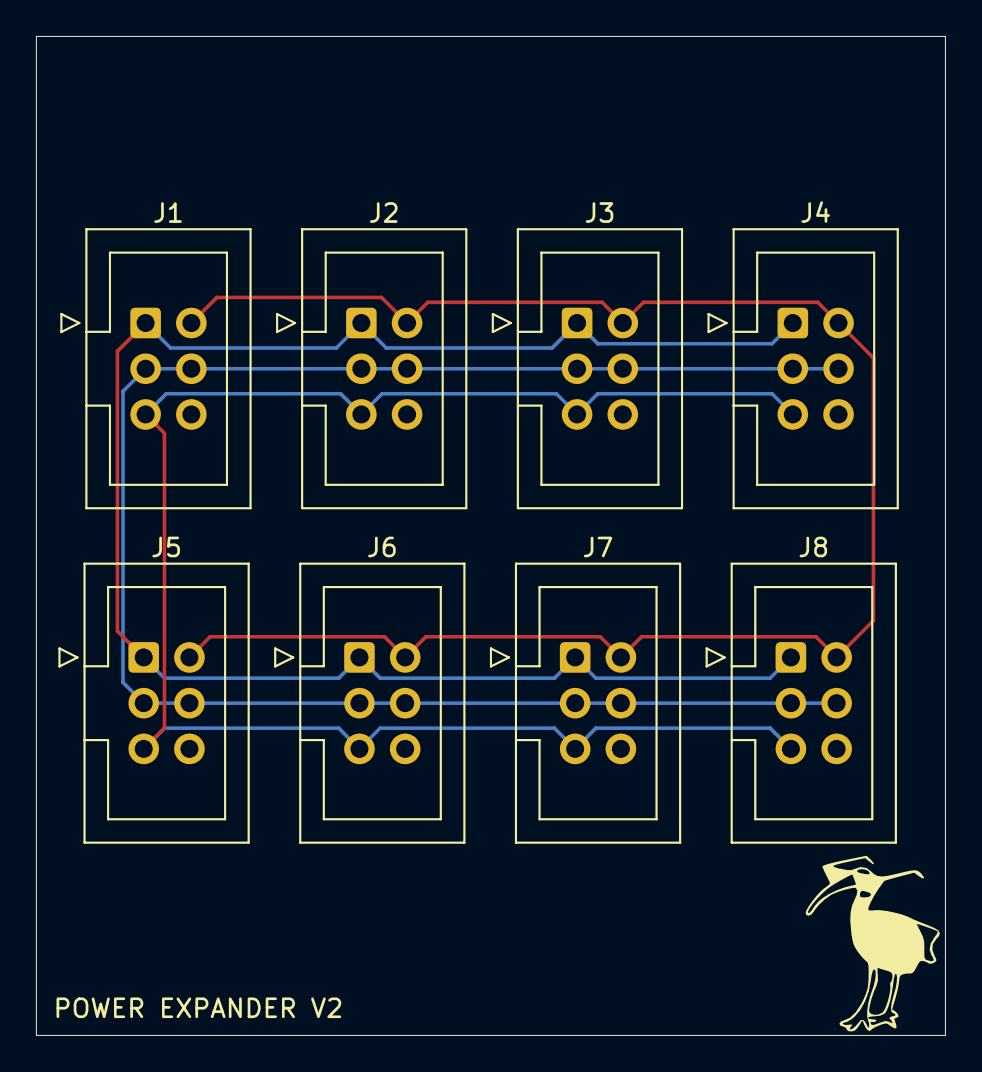
[picture p57: board power-expander.kicad_pcb from above]

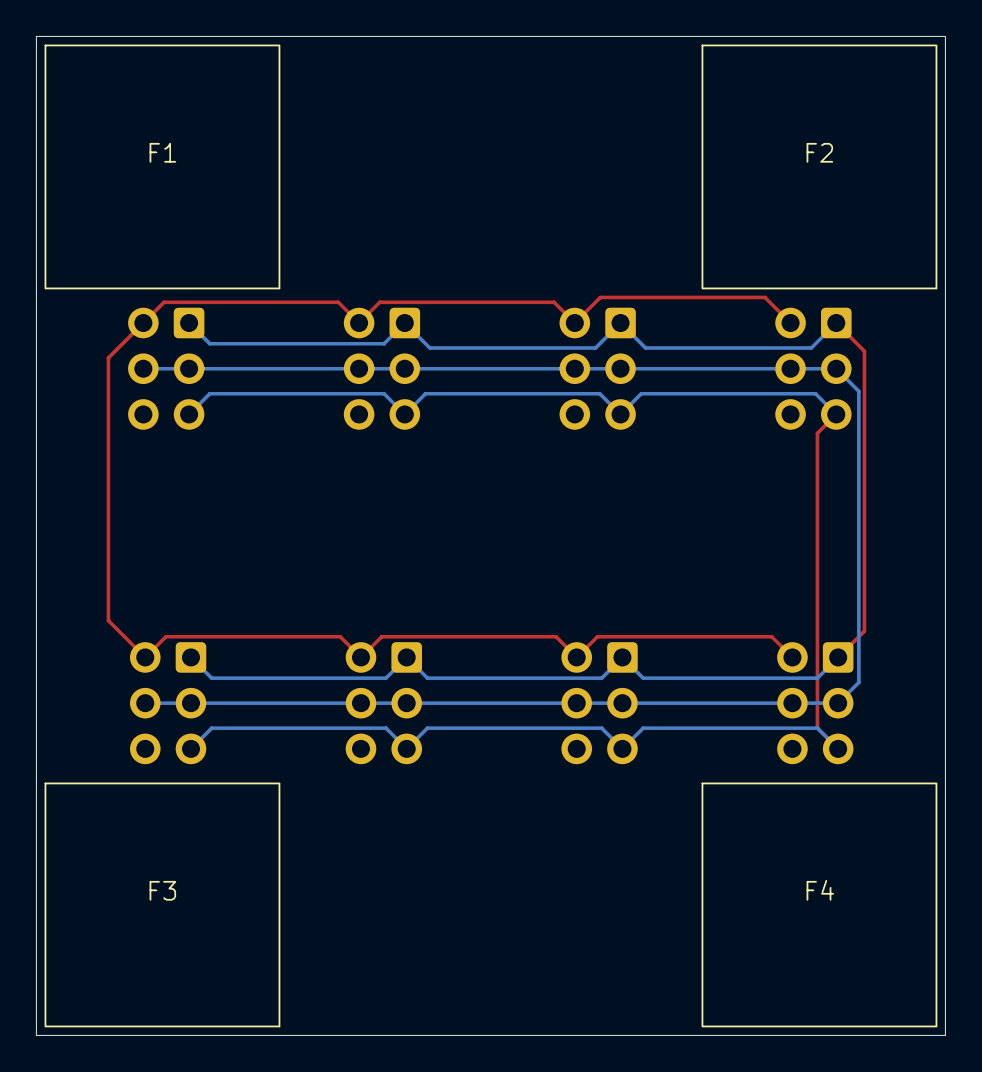
[picture p58: board power-expander.kicad_pcb from below]

Board: 2 copper layers, 50.5 x 55.5 mm, 12 parts (4 on the bottom side), 4 nets.

Other parts of the board:
F1, F2, F3, F4: foot
