gridbugs/modular2/note-sequencer/arduino/main/main.c

#include "adc.h"
#include "clock.h"
#include "command.h"
#include "debug.h"
#include "key_matrix.h"
#include "mcp4725.h"
#include "note.h"
#include "note_indices.h"
#include "rotary_encoder.h"
#include "state.h"
#include "timer.h"
#include "twi.h"
#include "uart.h"
#include "util.h"
#include <avr/interrupt.h>
#include <avr/io.h>
#include <stdbool.h>
#include <stdint.h>
#include <stdio.h>
#include <string.h>

#define PORTC_ENCODER_BUTTON_BIT BIT(0)
#define PORTC_ENCODER_A_BIT BIT(1)
#define PORTC_ENCODER_B_BIT BIT(2)
#define PORTC_CLOCK_BIT BIT(3)

#define PORTD_MODE_BIT BIT(0)
#define PORTD_GATE_BIT BIT(1)
#define PORTB_SCREEN_ARDUINO_RESET_BIT BIT(5)

static inline mode_t get_mode(void) {
  if ((PIND & PORTD_MODE_BIT) == 0) {
    return MODE_RUN;
  } else {
    return MODE_PROGRAM_OR_LIVE;
  }
}

// A volatile counter that will be updated asynchronously from the main control
// thread (by an ISR), and a copy that is expected to be atomically synchronized
// with the volatile counter by the main control thread. It's assumed that the
// counters will never overflow.
typedef struct {
  volatile int32_t volatile_value;
  int32_t value;
} async_counter_t;

// Returns the change in the counter value since the last time it was read (by
// calling this function).
int8_t async_counter_read_delta(async_counter_t *async_counter) {
  // Atomically read the volatile value by reading it with interrupts disabled.
  cli();
  int32_t volatile_value = async_counter->volatile_value;
  sei();
  int32_t delta = volatile_value - async_counter->value;
  async_counter->value = volatile_value;

  // Clamp the delta so it fits in an int8_t. The use case is for a rotary
  // encoder, and the delta exceeding the int8_t range would mean the encoder
  // has been turned +/-128 positions since the last time its value was
  // checked, which a) is very unlikely and b) would mean the consequence of a
  // clamped value being used in place of the true value is negligable.
  if (delta > 127) {
    delta = 127;
  } else if (delta < -128) {
    delta = -128;
  }

  return (int8_t)delta;
}

async_counter_t rotary_encoder_position = {0};
rotary_encoder_history_t rotary_encoder_history = ROTARY_ENCODER_HISTORY_INITIAL;

static inline bool rotary_encoder_is_pressed(void) {
  return (PINC & PORTC_ENCODER_BUTTON_BIT) == 0;
}

ISR(PCINT1_vect) {
  uint8_t rotary_encoder_state = (PINC >> 1) & 3;
  int8_t direction = rotary_encoder_update(&rotary_encoder_history, rotary_encoder_state);
  if (direction != 0) {
    if (rotary_encoder_is_pressed()) {
      direction *= 8;
    }
    rotary_encoder_position.volatile_value += direction;
  }
}

static inline int8_t rotary_encoder_read_delta(void) {
  return async_counter_read_delta(&rotary_encoder_position);
}

void rotary_encoder_init(void) {
  // Enable pin-changed interrupts for PORTC
  PCICR |= BIT(PCIE1);

  // Allow pin-changed interrupts associated with rotary encoder.
  PCMSK1 |= PORTC_ENCODER_BUTTON_BIT | PORTC_ENCODER_A_BIT | PORTC_ENCODER_B_BIT;

  // Set pins connected to encoder as input pins.
  DDRC &= ~(PORTC_ENCODER_BUTTON_BIT | PORTC_ENCODER_A_BIT | PORTC_ENCODER_B_BIT);

  // Enable pull-up resistors for encoder pins.
  PORTC |= PORTC_ENCODER_BUTTON_BIT | PORTC_ENCODER_A_BIT | PORTC_ENCODER_B_BIT;
}

typedef enum {
  KEY_C_1,
  KEY_C_SHARP_1,
  KEY_D_1,
  KEY_D_SHARP_1,
  KEY_E_1,
  KEY_F_1,
  KEY_F_SHARP_1,
  KEY_G_1,
  KEY_G_SHARP_1,
  KEY_A_1,
  KEY_A_SHARP_1,
  KEY_B_1,
  KEY_C_2,
  KEY_C_SHARP_2,
  KEY_D_2,
  KEY_D_SHARP_2,
  KEY_E_2,
  KEY_F_2,
  KEY_F_SHARP_2,
  KEY_G_2,
  KEY_G_SHARP_2,
  KEY_A_2,
  KEY_A_SHARP_2,
  KEY_B_2,
  KEY_C_3,
  KEY_X_1,
  KEY_X_2,
  KEY_X_3,
  KEY_X_4,
  KEY_CLOCK_SOURCE,
} key_t;

const key_t keys_by_key_matrix_bit[] = {
  KEY_X_1,          KEY_G_SHARP_2, KEY_D_SHARP_2, KEY_A_SHARP_1, KEY_F_1,       KEY_C_1,
  KEY_X_2,          KEY_A_2,       KEY_E_2,       KEY_B_1,       KEY_F_SHARP_1, KEY_C_SHARP_1,
  KEY_X_3,          KEY_A_SHARP_2, KEY_F_2,       KEY_C_2,       KEY_G_1,       KEY_D_1,
  KEY_X_4,          KEY_B_2,       KEY_F_SHARP_2, KEY_C_SHARP_2, KEY_G_SHARP_1, KEY_D_SHARP_1,
  KEY_CLOCK_SOURCE, KEY_C_3,       KEY_G_2,       KEY_D_2,       KEY_A_1,       KEY_E_1,
};

typedef enum {
  KEY_NOTE_C_1,
  KEY_NOTE_C_SHARP_1,
  KEY_NOTE_D_1,
  KEY_NOTE_D_SHARP_1,
  KEY_NOTE_E_1,
  KEY_NOTE_F_1,
  KEY_NOTE_F_SHARP_1,
  KEY_NOTE_G_1,
  KEY_NOTE_G_SHARP_1,
  KEY_NOTE_A_1,
  KEY_NOTE_A_SHARP_1,
  KEY_NOTE_B_1,
  KEY_NOTE_C_2,
  KEY_NOTE_C_SHARP_2,
  KEY_NOTE_D_2,
  KEY_NOTE_D_SHARP_2,
  KEY_NOTE_E_2,
  KEY_NOTE_F_2,
  KEY_NOTE_F_SHARP_2,
  KEY_NOTE_G_2,
  KEY_NOTE_G_SHARP_2,
  KEY_NOTE_A_2,
  KEY_NOTE_A_SHARP_2,
  KEY_NOTE_B_2,
  KEY_NOTE_C_3,
} key_note_t;

#define KEY_NOTE_COUNT 25
#define KEY_CLEAR KEY_X_2
#define KEY_ACCENT KEY_X_3
#define KEY_GLIDE KEY_X_4

#define KEY_WITH_SHIFT_EDIT_MODE_STEP KEY_NOTE_C_SHARP_1
#define KEY_WITH_SHIFT_EDIT_MODE_IN_PLACE KEY_NOTE_D_SHARP_1

#define KEY_WITH_SHIFT_SET_ACCENT_TYPE_RISE KEY_NOTE_F_SHARP_1
#define KEY_WITH_SHIFT_SET_ACCENT_TYPE_FLAT KEY_NOTE_G_SHARP_1
#define KEY_WITH_SHIFT_SET_ACCENT_TYPE_FALL KEY_NOTE_A_SHARP_1

#define KEY_WITH_SHIFT_SET_TEMPO KEY_NOTE_C_1
#define KEY_WITH_SHIFT_SET_GATE KEY_NOTE_D_1
#define KEY_WITH_SHIFT_SET_GLIDE KEY_NOTE_E_1
#define KEY_WITH_SHIFT_SET_ACCENT_SIZE KEY_NOTE_F_1
#define KEY_WITH_SHIFT_SET_ACCENT_DURATION_RATIO KEY_NOTE_G_1
#define KEY_WITH_SHIFT_OCTAVE_DOWN KEY_NOTE_A_1
#define KEY_WITH_SHIFT_OCTAVE_UP KEY_NOTE_B_1
#define KEY_WITH_SHIFT_TOGGLE_LIVE KEY_NOTE_C_2
#define KEY_WITH_SHIFT_SET_SEQUENCE_LENGTH KEY_NOTE_C_SHARP_2

// This is a bit in the raw key matrix input, not the key_note_t type.
#define KEY_SHIFT_BIT BIT(0)
#define KEY_CLEAR_BIT BIT(6)

uint8_t note_stack[KEY_NOTE_COUNT] = {0};
uint8_t note_stack_size = 0;
uint8_t current_note = NOTE_C_1;

// When gliding between notes these track the starting point for the current
// glide, the interpolation target for the current glide, and the current point
// between. The numberic value of these variables is the value to send to the
// dac to set the pitch output voltage.
uint16_t pitch_dac_value_base;
uint16_t pitch_dac_value_target;
uint16_t pitch_dac_value_current;

typedef struct {
  command_t commands[32];
  uint8_t num_commands;
} command_buffer_t;

static void command_buffer_send(command_buffer_t *cb) {
  if (cb->num_commands > 0) {
    commands_send(cb->commands, cb->num_commands);
    cb->num_commands = 0;
  }
}

static void push_and_apply_command(command_buffer_t *cb, state_t *state, command_t command) {
  cb->commands[cb->num_commands] = command;
  cb->num_commands++;
  state_apply_command(state, command);
}

#define MAX_OCTAVE 8
#define MIN_BPM 30
#define MAX_BPM 255

static command_t state_command_add_to_tempo_bpm(state_t *state, int8_t delta) {
  int16_t tempo_bpm = (int16_t)state->tempo_bpm + (int16_t)delta;
  uint8_t tempo_bpm_clamped = (uint8_t)CLAMP_NAIVE(MIN_BPM, tempo_bpm, MAX_BPM);
  return command_set_field(SETTING_FIELD_TEMPO_BPM, tempo_bpm_clamped);
}

static command_t state_command_add_to_gate_duration_ratio(state_t *state, int8_t delta) {
  int16_t gate_duration_ratio = (int16_t)state->gate_duration_ratio + (int16_t)delta;
  uint8_t gate_duration_ratio_clamped = (uint8_t)CLAMP_NAIVE(0, gate_duration_ratio, 255);
  return command_set_field(SETTING_FIELD_GATE_DURATION_RATIO, gate_duration_ratio_clamped);
}

static command_t state_command_add_to_glide_duration_ratio(state_t *state, int8_t delta) {
  int16_t glide_duration_ratio = (int16_t)state->glide_duration_ratio + (int16_t)delta;
  uint8_t glide_duration_ratio_clamped = (uint8_t)CLAMP_NAIVE(0, glide_duration_ratio, 255);
  return command_set_field(SETTING_FIELD_GLIDE_DURATION_RATIO, glide_duration_ratio_clamped);
}

static command_t state_command_add_to_accent_duration_ratio(state_t *state, int8_t delta) {
  int16_t accent_duration_ratio = (int16_t)state->accent_duration_ratio + (int16_t)delta;
  uint8_t accent_duration_ratio_clamped = (uint8_t)CLAMP_NAIVE(0, accent_duration_ratio, 255);
  return command_set_field(SETTING_FIELD_ACCENT_DURATION_RATIO, accent_duration_ratio_clamped);
}

static command_t state_command_add_to_accent_size(state_t *state, int8_t delta) {
  int16_t accent_size = (int16_t)state->accent_size + (int16_t)delta;
  uint8_t accent_size_clamped = (uint8_t)CLAMP_NAIVE(0, accent_size, 255);
  return command_set_field(SETTING_FIELD_ACCENT_SIZE, accent_size_clamped);
}

static command_t state_command_add_to_sequence_length(state_t *state, int8_t delta) {
  int16_t sequence_length = (int16_t)state->sequence_length + (int16_t)delta;
  uint8_t sequence_length_clamped = (uint8_t)CLAMP_NAIVE(1, sequence_length, MAX_SEQUENCE_LENGTH);
  return command_set_field(SETTING_FIELD_SEQUENCE_LENGTH, sequence_length_clamped);
}

#define SECONDS_PER_MINUTE 60

static uint16_t ticks_per_minute_to_timer_compare(uint16_t ticks_per_minute) {
  return (uint16_t)(((OSC_HZ >> 9) * SECONDS_PER_MINUTE) / (uint32_t)ticks_per_minute);
}

key_states_t key_states = {0};

typedef struct {
  volatile uint8_t count_setter_incremented;
  uint8_t count_to_check;
} async_flag_t;

static void async_flag_set(async_flag_t *async_flag) {
  async_flag->count_setter_incremented++;
}

static bool async_flag_check_and_clear(async_flag_t *async_flag) {
  uint8_t count_copy = async_flag->count_setter_incremented;
  bool ret = count_copy != async_flag->count_to_check;
  async_flag->count_to_check = count_copy;
  return ret;
}

async_flag_t timer_tick = {0};

ISR(TIMER1_COMPA_vect) {
  async_flag_set(&timer_tick);
}

volatile uint32_t timer2_match_count = 0;

ISR(TIMER2_COMPA_vect) {
  timer2_match_count++;
}

static inline uint32_t note_timer_value(void) {
  return timer2_match_count;
}

static inline void note_timer_reset(void) {
  timer2_match_count = 0;
}

static void program_timer_ticks_per_minute(uint16_t ticks_per_minute) {
  // Divide the comparator by 2 so we get interrupts twice as often as the tick
  // rate. Each interrupt will toggle the state of the clock.
  uint16_t compare_value = ticks_per_minute_to_timer_compare(ticks_per_minute) / 2;
  timer1_set_output_compare_a(compare_value);
}

static void set_clock_source(clock_source_t clock_source) {
  // Update the data-direction bit for the clock pin
  switch (clock_source) {
    case CLOCK_SOURCE_INTERNAL:
      // Clock output pin
      DDRC |= PORTC_CLOCK_BIT;
      break;
    case CLOCK_SOURCE_EXTERNAL:
      // Clock input pin
      DDRC &= ~PORTC_CLOCK_BIT;
      // Pull-up resistor for clock input pin
      PORTC |= PORTC_CLOCK_BIT;
      break;
  }
}

#define CLOCK_BOUNCE_THRESHOLD 100

static bool get_clock_in(void) {
  static uint32_t since_change = 0;
  static bool state = false;
  bool raw = (PINC & PORTC_CLOCK_BIT) != 0;
  if (raw && !state && since_change >= CLOCK_BOUNCE_THRESHOLD) {
    state = true;
    since_change = 0;
  } else if (!raw && state && since_change >= CLOCK_BOUNCE_THRESHOLD) {
    state = false;
    since_change = 0;
  } else {
    since_change++;
  }
  return state;
}

static void set_clock_out(bool value) {
  if (value) {
    PORTC |= PORTC_CLOCK_BIT;
  } else {
    PORTC &= ~PORTC_CLOCK_BIT;
  }
}

typedef enum {
  CLOCK_EVENT_NONE,
  CLOCK_EVENT_RISING_EDGE,
  CLOCK_EVENT_FALLING_EDGE,
} clock_event_t;

static clock_event_t handle_clock(state_t *state) {
  switch (state->clock_source) {
    case CLOCK_SOURCE_EXTERNAL: {
      bool clock_state = get_clock_in();
      if (state->clock_state != clock_state) {
        state->clock_state = clock_state;
        if (clock_state) {
          return CLOCK_EVENT_RISING_EDGE;
        } else {
          return CLOCK_EVENT_FALLING_EDGE;
        }
      }
      break;
    }
    case CLOCK_SOURCE_INTERNAL: {
      if (async_flag_check_and_clear(&timer_tick)) {
        state->clock_state = !state->clock_state;
        set_clock_out(state->clock_state);
        if (state->clock_state) {
          return CLOCK_EVENT_RISING_EDGE;
        } else {
          return CLOCK_EVENT_FALLING_EDGE;
        }
      }
      break;
    }
  }
  return CLOCK_EVENT_NONE;
}

volatile uint8_t timer0_match_count = 255;

ISR(TIMER0_COMPA_vect) {
  if (timer0_match_count < 255) {
    timer0_match_count++;
  }
}

static inline uint8_t glide_get_progress(void) {
  return timer0_match_count;
}

static inline void glide_reset(void) {
  timer0_match_count = 0;
}

static inline void gate_on(void) {
  PORTD |= PORTD_GATE_BIT;
}

static inline void gate_off(void) {
  PORTD &= ~PORTD_GATE_BIT;
}

static inline void gate_init(void) {
  USART0_reset();
  DDRD |= PORTD_GATE_BIT;
  gate_off();
}

static inline void set_pitch_dac_value(uint16_t value) {
  dac1_set_value(value);
}

// Duration (in same unit as `note_timer_value()`) to use to as the effective
// note duration for the purposes of calculating accent duration when playing
// live.
#define ACCENT_LIVE_NOTE_EFFECTIVE_DURATION 256

static inline void set_accent_dac_value(uint16_t value) {
  dac0_set_value(value);
}

int main(void) {
#ifdef DEBUG_PRINTING
  // Allow printing over UART and defer initializing the gate (which shares the
  // TX pin) until after startup messages are printed. If debug printing is
  // enabled the gate jack will not work.
  USART0_init();
#else
  gate_init();
#endif

  rotary_encoder_init();

  // Input pin with pullup resistor for mode switch.
  DDRD &= ~PORTD_MODE_BIT;
  PORTD |= PORTD_MODE_BIT;

  dprintf("Turning off screen arduino...\n\r");
  // Turn off the other arduino by driving its reset pin low
  DDRB |= PORTB_SCREEN_ARDUINO_RESET_BIT;
  PORTB &= ~PORTB_SCREEN_ARDUINO_RESET_BIT;

  COMPILER_BARRIER();

  // Wait some time to ensure the second arduino is fully off, then turn it back
  // on.
  delay_ms(50);

  COMPILER_BARRIER();

  dprintf("Turning on screen arduino...\n\r");
  PORTB |= PORTB_SCREEN_ARDUINO_RESET_BIT;

  dprintf("Waiting for screen arduino...\n\r");
  while (command_send(command_hello()) != 0)
    ;

  dprintf("Screen arduino is online!\n\r");
  delay_ms(50);

  // Display the splash screen.
  command_send(command_show_splash());
  delay_ms(500);

  dprintf("Starting UI...\n\r");
  command_send(command_show_ui());

  key_matrix_init();

  state_t st = {0};
  command_buffer_t cb = {0};

  state_init(&st);

  set_clock_source(st.clock_source);

  timer0_init();
  timer0_enable_interrupt_output_compare_a();
  timer0_set_output_compare_a(st.glide_duration_ratio);
  timer0_set_reset_on_output_compare_a_match();
  timer0_reset();
  timer0_start();

  timer1_init();
  timer1_enable_interrupt_output_compare_a();
  timer1_set_reset_on_output_compare_a_match();
  program_timer_ticks_per_minute(state_ticks_per_minute(&st));
  timer1_reset();
  timer1_start();

  sei();

  push_and_apply_command(&cb, &st, command_set_note(current_note));
  set_pitch_dac_value(note_dac_value(current_note));
  command_buffer_send(&cb);

  timer2_init();
  timer2_set_output_compare_a(255);
  timer2_enable_interrupt_output_compare_a();
  timer2_start();
  uint16_t prev_note_duration = 0;
  uint8_t warmup_countdown = 4;

  step_t current_step = state_current_playback_step(&st);

  while (1) {
    uint8_t new_current_note = current_note;

    mode_t mode = get_mode();
    if (mode != st.mode) {
      push_and_apply_command(&cb, &st, command_set_mode(mode));
    }

    switch (handle_clock(&st)) {
      case CLOCK_EVENT_NONE:
        break;
      case CLOCK_EVENT_FALLING_EDGE:
        push_and_apply_command(&cb, &st, command_set_clock(false));
        break;
      case CLOCK_EVENT_RISING_EDGE: {
        push_and_apply_command(&cb, &st, command_set_clock(true));
        if (st.mode == MODE_RUN) {
          push_and_apply_command(&cb, &st, state_command_add_to_playback_index(&st, 1));
          current_step = state_current_playback_step(&st);
          if (current_step.enabled) {
            new_current_note = current_step.note_index;
          }
          if (!state_is_live(&st)) {
            // Use the current tick duration to determine the next gate duration.
            prev_note_duration = note_timer_value();
            note_timer_reset();
          }
        }
        if (warmup_countdown > 0) {
          warmup_countdown--;
        }
      }
    }

    key_matrix_scan(&key_states);
    uint32_t delta = key_states.curr ^ key_states.prev;
    uint32_t pressed = delta & key_states.curr;

    bool clear = (key_states.curr & KEY_CLEAR_BIT) != 0;
    bool shift = (key_states.curr & KEY_SHIFT_BIT) != 0;
    if (!shift) {
      if (st.setting_field != SETTING_FIELD_NONE) {
        push_and_apply_command(&cb, &st, command_setting_field(SETTING_FIELD_NONE));
      }
    }
    while (pressed) {
      int pressed_bit = __builtin_ctzl(pressed);
      pressed &= ~BIT(pressed_bit);
      key_t key = keys_by_key_matrix_bit[pressed_bit];
      if (key < KEY_NOTE_COUNT) {
        key_note_t key_note = (key_note_t)key;
        if (shift) {
          switch (key_note) {
            case KEY_WITH_SHIFT_EDIT_MODE_STEP:
              push_and_apply_command(&cb, &st, command_set_edit_mode(EDIT_MODE_STEP));
              break;
            case KEY_WITH_SHIFT_EDIT_MODE_IN_PLACE:
              push_and_apply_command(&cb, &st, command_set_edit_mode(EDIT_MODE_IN_PLACE));
              break;
            case KEY_WITH_SHIFT_SET_ACCENT_TYPE_RISE:
              push_and_apply_command(&cb, &st, command_set_accent_type(ACCENT_TYPE_RISE));
              break;
            case KEY_WITH_SHIFT_SET_ACCENT_TYPE_FLAT:
              push_and_apply_command(&cb, &st, command_set_accent_type(ACCENT_TYPE_FLAT));
              break;
            case KEY_WITH_SHIFT_SET_ACCENT_TYPE_FALL:
              push_and_apply_command(&cb, &st, command_set_accent_type(ACCENT_TYPE_FALL));
              break;
            case KEY_WITH_SHIFT_SET_TEMPO:
              push_and_apply_command(&cb, &st, command_setting_field(SETTING_FIELD_TEMPO_BPM));
              break;
            case KEY_WITH_SHIFT_SET_GATE:
              push_and_apply_command(
                &cb,
                &st,
                command_setting_field(SETTING_FIELD_GATE_DURATION_RATIO));
              break;
            case KEY_WITH_SHIFT_SET_GLIDE:
              push_and_apply_command(
                &cb,
                &st,
                command_setting_field(SETTING_FIELD_GLIDE_DURATION_RATIO));
              break;
            case KEY_WITH_SHIFT_SET_ACCENT_SIZE:
              push_and_apply_command(&cb, &st, command_setting_field(SETTING_FIELD_ACCENT_SIZE));
              break;
            case KEY_WITH_SHIFT_SET_ACCENT_DURATION_RATIO:
              push_and_apply_command(
                &cb,
                &st,
                command_setting_field(SETTING_FIELD_ACCENT_DURATION_RATIO));
              break;
            case KEY_WITH_SHIFT_TOGGLE_LIVE:
              push_and_apply_command(&cb, &st, command_set_live(!st.live));
              break;
            case KEY_WITH_SHIFT_OCTAVE_DOWN:
              if (st.octave > 0) {
                push_and_apply_command(&cb, &st, command_set_octave(st.octave - 1));
                // Decrease all pressed notes by an octave so if a note is held
                // while the octave changes it doesn't get stuck.
                for (int i = 0; i < note_stack_size; i++) {
                  note_stack[i] -= 12;
                }
              }
              break;
            case KEY_WITH_SHIFT_OCTAVE_UP:
              if (st.octave < MAX_OCTAVE) {
                push_and_apply_command(&cb, &st, command_set_octave(st.octave + 1));
                // Increase all pressed notes by an octave so if a note is held
                // while the octave changes it doesn't get stuck.
                for (int i = 0; i < note_stack_size; i++) {
                  note_stack[i] += 12;
                }
              }
              break;
            case KEY_WITH_SHIFT_SET_SEQUENCE_LENGTH:
              push_and_apply_command(
                &cb,
                &st,
                command_setting_field(SETTING_FIELD_SEQUENCE_LENGTH));
              break;
            default:
          }
        } else {
          key_note += (st.octave * 12);
          note_stack[note_stack_size] = key_note;
          note_stack_size++;

          if (st.live) {
            // In live mode the note timer counter is used to track the
            // duration the note has been held for.
            note_timer_reset();
          } else {
            // Set the current step to the newly pressed note.
            push_and_apply_command(&cb, &st, command_set_step_note(st.edit_index, key_note));
            if (st.edit_mode == EDIT_MODE_STEP) {
              push_and_apply_command(&cb, &st, state_command_add_to_edit_index(&st, 1));
            }
          }
        }
      } else if (key == KEY_CLEAR) {
        if (shift) {
          push_and_apply_command(&cb, &st, command_clear_sequence());
        } else {
          // Clear the current step
          push_and_apply_command(&cb, &st, command_clear_step_note(st.edit_index));
          if (st.edit_mode == EDIT_MODE_STEP) {
            push_and_apply_command(&cb, &st, state_command_add_to_edit_index(&st, 1));
          }
        }
      } else if (key == KEY_ACCENT) {
        push_and_apply_command(&cb, &st, state_command_toggle_flags(&st, FLAG_ACCENT));
      } else if (key == KEY_GLIDE) {
        push_and_apply_command(&cb, &st, state_command_toggle_flags(&st, FLAG_GLIDE));
      } else if (key == KEY_CLOCK_SOURCE) {
        push_and_apply_command(&cb, &st, command_set_clock_source(CLOCK_SOURCE_INTERNAL));
        set_clock_source(CLOCK_SOURCE_INTERNAL);
      }
    }

    uint32_t released = delta & key_states.prev;
    while (released) {
      int released_bit = __builtin_ctzl(released);
      released &= ~BIT(released_bit);
      key_t key = keys_by_key_matrix_bit[released_bit];
      key_note_t key_note = (key_note_t)key;
      if (shift) {
        switch (key_note) {
          case KEY_WITH_SHIFT_SET_TEMPO:
          case KEY_WITH_SHIFT_SET_GATE:
          case KEY_WITH_SHIFT_SET_GLIDE:
          case KEY_WITH_SHIFT_SET_ACCENT_DURATION_RATIO:
          case KEY_WITH_SHIFT_SET_ACCENT_SIZE:
            if (st.setting_field != SETTING_FIELD_NONE) {
              push_and_apply_command(&cb, &st, command_setting_field(SETTING_FIELD_NONE));
            }
            break;
          default:
        }
      } else if (key == KEY_CLOCK_SOURCE) {
        push_and_apply_command(&cb, &st, command_set_edit_mode(CLOCK_SOURCE_EXTERNAL));
        set_clock_source(CLOCK_SOURCE_EXTERNAL);
      }
      key_note += (st.octave * 12);
      for (int i = 0; i < note_stack_size; i++) {
        if (note_stack[i] == key_note) {
          for (; i < note_stack_size - 1; i++) {
            note_stack[i] = note_stack[i + 1];
          }
          note_stack_size--;
          break;
        }
      }
    }

    switch (st.mode) {
      case MODE_RUN:
        uint16_t prev_note_duration_scaled =
          (prev_note_duration * (uint16_t)st.gate_duration_ratio) / 255;
        if (current_step.enabled && (note_timer_value() < prev_note_duration_scaled)) {
          gate_on();
        } else {
          gate_off();
        }
        break;
      case MODE_PROGRAM_OR_LIVE:
        if (st.live) {
          if (note_stack_size == 0) {
            gate_off();
          } else {
            gate_on();
          }
        } else {
          // In programming mode the gate is always off.
          gate_off();
        }
        break;
    }

    int8_t rotary_encoder_delta = rotary_encoder_read_delta();
    if (warmup_countdown != 0) {
      rotary_encoder_delta = 0;
    }
    if (rotary_encoder_delta != 0) {
      switch (st.setting_field) {
        case SETTING_FIELD_NONE:
          push_and_apply_command(
            &cb,
            &st,
            state_command_add_to_edit_index(&st, rotary_encoder_delta));
          if (clear) {
            push_and_apply_command(&cb, &st, command_clear_step_note(st.edit_index));
          }
          break;
        case SETTING_FIELD_TEMPO_BPM:
          push_and_apply_command(
            &cb,
            &st,
            state_command_add_to_tempo_bpm(&st, rotary_encoder_delta));
          program_timer_ticks_per_minute(state_ticks_per_minute(&st));
          break;
        case SETTING_FIELD_GATE_DURATION_RATIO:
          push_and_apply_command(
            &cb,
            &st,
            state_command_add_to_gate_duration_ratio(&st, rotary_encoder_delta));
          break;
        case SETTING_FIELD_GLIDE_DURATION_RATIO:
          push_and_apply_command(
            &cb,
            &st,
            state_command_add_to_glide_duration_ratio(&st, rotary_encoder_delta));
          // Set the timer's output compare register so the comparison match
          // interrupt fires at a rate as determined by the glide duration.
          timer0_set_output_compare_a(st.glide_duration_ratio);
          break;
        case SETTING_FIELD_ACCENT_DURATION_RATIO:
          push_and_apply_command(
            &cb,
            &st,
            state_command_add_to_accent_duration_ratio(&st, rotary_encoder_delta));
          break;
        case SETTING_FIELD_ACCENT_SIZE:
          push_and_apply_command(
            &cb,
            &st,
            state_command_add_to_accent_size(&st, rotary_encoder_delta));
          break;
        case SETTING_FIELD_SEQUENCE_LENGTH:
          push_and_apply_command(
            &cb,
            &st,
            state_command_add_to_sequence_length(&st, rotary_encoder_delta));
          break;
      }
    }

    if (note_stack_size > 0 && st.live) {
      new_current_note = note_stack[note_stack_size - 1];
    }

    if (new_current_note != current_note) {
      current_note = new_current_note;
      if (state_current_has_glide(&st)) {
        // Start interpolating from the current dac value rather than the
        // previous note's dac value so if there are two glides in a row and
        // the second glide starts before the first glide finishes we start
        // from wherever the first glide was up to rather than jumping to its
        // target.
        pitch_dac_value_base = pitch_dac_value_current;
        pitch_dac_value_target = note_dac_value(current_note);
        glide_reset();
        push_and_apply_command(&cb, &st, command_set_note(current_note));
      } else {
        pitch_dac_value_current = note_dac_value(current_note);
        pitch_dac_value_base = pitch_dac_value_current;
        pitch_dac_value_target = pitch_dac_value_current;
        push_and_apply_command(&cb, &st, command_set_note(current_note));
      }
    }
    if (state_current_has_glide(&st)) {
      // Interpolate between the base and target dac values.
      uint8_t glide_progress = glide_get_progress();
      int16_t delta = (((int32_t)pitch_dac_value_target - (int32_t)pitch_dac_value_base) *
                       (int32_t)glide_progress) /
        255;
      pitch_dac_value_current = (uint16_t)((int16_t)pitch_dac_value_base + delta);
    }
    set_pitch_dac_value(pitch_dac_value_current);

    // When this value is under 256 and the current step has accent enabled, a
    // non-zero voltage will be set on the accent dac. The position between 0
    // and 255 of this value determines the current progress of the accent.
    uint32_t accent_index =
      (uint16_t)((note_timer_value() * (uint32_t)255 * (uint32_t)255) /
                 ((state_is_live(&st) ? (uint32_t)ACCENT_LIVE_NOTE_EFFECTIVE_DURATION
                                      : (uint32_t)prev_note_duration) *
                  (uint32_t)st.accent_duration_ratio));

    uint16_t accent_dac_value = 0;
    if (state_current_has_accent(&st)) {
      switch (st.mode) {
        case MODE_RUN: {
          accent_dac_value =
            accent_value_at_time_index(st.accent_type, accent_index, st.accent_size);
          break;
        }
        case MODE_PROGRAM_OR_LIVE: {
          if (st.live) {
            switch (st.accent_type) {
              // For accent types that end high, clamp the accent index at 255
              // so the accent stays high while the note is held.
              case ACCENT_TYPE_FLAT:
              case ACCENT_TYPE_RISE: {
                if (note_stack_size == 0) {
                  accent_dac_value = 0;
                } else {
                  if (accent_index > 255) {
                    accent_index = 255;
                  }
                  accent_dac_value =
                    accent_value_at_time_index(st.accent_type, accent_index, st.accent_size);
                }
                break;
              }
              default: {
                accent_dac_value =
                  accent_value_at_time_index(st.accent_type, accent_index, st.accent_size);
                break;
              }
            }
          }
          break;
        }
      }
    }
    set_accent_dac_value(accent_dac_value);

    command_buffer_send(&cb);
  }

  return 0;
}
