gridbugs/modular2/note-sequencer/arduino/common/state.h

#pragma once

#include "accent.h"
#include "types.h"
#include "util.h"
#include <stdbool.h>
#include <stdint.h>

#define FLAG_ACCENT BIT(0)
#define FLAG_GLIDE BIT(1)

typedef struct {
  uint8_t note_index;
  bool enabled;
  uint8_t flags;
} step_t;

static inline bool step_has_accent(step_t *step) {
  return (step->flags & FLAG_ACCENT) != 0;
}

static inline bool step_has_glide(step_t *step) {
  return (step->flags & FLAG_GLIDE) != 0;
}

#define MAX_SEQUENCE_LENGTH 16

typedef struct {
  step_t steps[MAX_SEQUENCE_LENGTH];
} sequence_t;

typedef struct {
  sequence_t sequence;
  uint8_t sequence_length;
  uint8_t playback_index;
  uint8_t edit_index;
  mode_t mode;
  clock_source_t clock_source;
  bool clock_state;
  uint8_t tempo_bpm;
  uint8_t ticks_per_beat;
  setting_field_t setting_field;
  uint8_t gate_duration_ratio;
  uint8_t glide_duration_ratio;
  bool live;
  uint8_t octave;
  uint8_t live_flags;
  edit_mode_t edit_mode;
  accent_type_t accent_type;
  uint8_t accent_duration_ratio;
  uint8_t accent_size;
} state_t;

void state_init(state_t *state);
void state_add_to_playback_index(state_t *state, int8_t delta);
command_t state_command_add_to_playback_index(state_t *state, int8_t delta);
command_t state_command_add_to_edit_index(state_t *state, int8_t delta);

// Toggles flags set in the bitfield `flags` of the live flags in live mode or
// the current step in non-live mode.
command_t state_command_toggle_flags(state_t *state, uint8_t flags);
void state_clear_sequence(state_t *state);
step_t *state_current_edit_step_ptr(state_t *state);
step_t state_current_playback_step(state_t *state);
bool state_current_has_glide(state_t *state);
bool state_current_has_accent(state_t *state);
void state_apply_command(state_t *state, command_t command);

static inline uint16_t state_ticks_per_minute(state_t *state) {
  return state->tempo_bpm * state->ticks_per_beat;
}

static inline bool state_live_has_accent(state_t *state) {
  return (state->live_flags & FLAG_ACCENT) != 0;
}

static inline bool state_live_has_glide(state_t *state) {
  return (state->live_flags & FLAG_GLIDE) != 0;
}

static inline bool state_is_live(state_t *state) {
  return state->live && state->mode == MODE_PROGRAM_OR_LIVE;
}
