gridbugs/modular2/note-sequencer/arduino/common/types.h

#pragma once

typedef enum {
  MODE_RUN,
  MODE_PROGRAM_OR_LIVE,
} mode_t;

typedef enum {
  CLOCK_SOURCE_INTERNAL,
  CLOCK_SOURCE_EXTERNAL,
} clock_source_t;

typedef enum {
  EDIT_MODE_STEP,
  EDIT_MODE_IN_PLACE,
} edit_mode_t;

typedef enum {
  SETTING_FIELD_NONE,
  SETTING_FIELD_TEMPO_BPM,
  SETTING_FIELD_GATE_DURATION_RATIO,
  SETTING_FIELD_GLIDE_DURATION_RATIO,
  SETTING_FIELD_ACCENT_DURATION_RATIO,
  SETTING_FIELD_ACCENT_SIZE,
  SETTING_FIELD_SEQUENCE_LENGTH,
} setting_field_t;

typedef enum {
  ACCENT_TYPE_RISE,
  ACCENT_TYPE_FLAT,
  ACCENT_TYPE_FALL,
} accent_type_t;
