gridbugs/modular2/note-sequencer/arduino/common/debug.h

#pragma once

#include "util.h"
#include <stdio.h>

#define PANIC(...)                                                                                 \
  do {                                                                                             \
    printf(__VA_ARGS__);                                                                           \
    printf("\n\r");                                                                                \
    loop_forever();                                                                                \
  } while (0);

// #define DEBUG_PRINTING
#ifdef DEBUG_PRINTING
#define dprintf(...) printf(__VA_ARGS__)
#else
#define dprintf(...)
#endif
