gridbugs/modular2/note-sequencer/arduino/common/mcp4725.h

#pragma once

#include "util.h"
#include <stdint.h>

#define DAC_MAX MASK(12)

// Set the value of the DAC with I2C address 0x60. Only the low 12 bits of the
// value are used.
int dac0_set_value(uint16_t value);

// Set the value of the DAC with I2C address 0x61 (A0 pin is pulled high). Only
// the low 12 bits of the value are used.
int dac1_set_value(uint16_t value);
