gridbugs/modular2/note-sequencer/arduino/common/timer.c

#include "util.h"
#include <avr/io.h>
#include <stdint.h>

void timer2_init_pwm_port_d_bit_3(uint8_t duty) {
  DDRD |= BIT(3);
  TCCR2A = BIT(COM2B1) | BIT(WGM21) | BIT(WGM20);
  TCCR2B = BIT(CS22);
  OCR2B = duty;
}
