gridbugs/modular2/note-sequencer/arduino/common/uart.c

#include "clock.h"
#include "util.h"
#include <avr/io.h>
#include <stdio.h>

// The USART0 clock divides the oscillator clock rate by 16.
#define USART0_CLOCK_HZ (OSC_HZ / 16)
#define BAUD_RATE_HZ 9600
#define UBRR_VALUE ((USART0_CLOCK_HZ / BAUD_RATE_HZ) - 1)

// Send a character over USART0.
int USART0_tx(char data, struct __file *_f) {
  while (!(UCSR0A & (1 << UDRE0)))
    ;          // wait for the data buffer to be empty
  UDR0 = data; // write the character to the data buffer
  return 0;
}

// Create a stream associated with transmitting data over USART0 (this will be
// used for stdout so we can print to a terminal with printf).
static FILE uartout = FDEV_SETUP_STREAM(USART0_tx, NULL, _FDEV_SETUP_WRITE);

void USART0_init(void) {
  UBRR0H = (UBRR_VALUE >> 8) & 0xF; // set the high byte of the baud rate
  UBRR0L = UBRR_VALUE & 0xFF;       // set the low byte of the baud rate
  UCSR0B = 1 << TXEN0;              // enable the USART0 transmitter
  UCSR0C = 3 << UCSZ00;             // use 8-bit characters
  stdout = &uartout;
}

void USART0_reset(void) {
  UCSR0B &= ~(1 << TXEN0); // disable the USART0 transmitter
}
