gridbugs/modular2/(commit log)

2025-11-22 Pot socket
    [pot-socket-B_Cu.gbr, pot-socket-B_Mask.gbr, pot-socket-B_Paste.gbr, pot-socket-B_Silkscreen.gbr, pot-socket-Edge_Cuts.gbr, pot-socket-F_Cu.gbr, pot-socket-F_Mask.gbr, pot-socket-F_Paste.gbr]
2025-11-23 Freecad design for pot socket
    [base.stl, pcb.stl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]
2025-11-25 Update pot socket model
    [base.stl, pot-socket.FCStd, pot-socket.kicad_pcb, shell.stl]
2025-11-25 Update pcb outputs
    [pot-socket-B_Cu.gbr, pot-socket-B_Mask.gbr, pot-socket-B_Paste.gbr, pot-socket-B_Silkscreen.gbr, pot-socket-Edge_Cuts.gbr, pot-socket-F_Cu.gbr, pot-socket-F_Mask.gbr, pot-socket-F_Paste.gbr]
2025-11-25 Remove redundant pcb stl
    [pcb.stl, pot-socket-pcb.stl]
2025-12-03 Update pot socket
    [pot-socket.FCStd]
2025-12-03 Tidy pot socket design
    [pot-socket.FCStd]
2025-12-03 Update pot socket stl files
    [base.stl, shell.stl]
2025-12-03 Add padding to bottom of pot socket
    [base.stl, pot-socket.FCStd]
2025-12-03 Update pot socket pcb
    [pcb.stl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]
2025-12-04 Power supply
    [power-supply.kicad_pcb, power-supply.kicad_sch]
2025-12-04 First pass of power supply
    [power-supply-B_Cu.gbr, power-supply-B_Mask.gbr, power-supply-B_Paste.gbr, power-supply-B_Silkscreen.gbr, power-supply-Edge_Cuts.gbr, power-supply-F_Cu.gbr, power-supply-F_Mask.gbr, power-supply-F_Paste.gbr]
2025-12-11 Add oscillator
    [oscillator-B_Cu.gbr, oscillator-B_Mask.gbr, oscillator-B_Paste.gbr, oscillator-B_Silkscreen.gbr, oscillator-Edge_Cuts.gbr, oscillator-F_Cu.gbr, oscillator-F_Mask.gbr, oscillator-F_Paste.gbr]
2025-12-25 Update power supply
    [power-supply.kicad_pcb, power-supply.kicad_sch]
2025-12-25 Fix L812 orientation in power supply
    [power-supply-B_Cu.gbr, power-supply-B_Mask.gbr, power-supply-B_Paste.gbr, power-supply-B_Silkscreen.gbr, power-supply-Edge_Cuts.gbr, power-supply-F_Cu.gbr, power-supply-F_Mask.gbr, power-supply-F_Paste.gbr]
2025-12-26 Redesign oscillator
    [oscillator.kicad_pcb, oscillator.kicad_sch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]
2025-12-27 V2 of oscillator
    [oscillator-B_Cu.gbr, oscillator-B_Mask.gbr, oscillator-B_Paste.gbr, oscillator-B_Silkscreen.gbr, oscillator-Edge_Cuts.gbr, oscillator-F_Cu.gbr, oscillator-F_Mask.gbr, oscillator-F_Paste.gbr]
2025-12-27 Update oscillator
    [oscillator-B_Cu.gbr, oscillator-B_Mask.gbr, oscillator-B_Paste.gbr, oscillator-B_Silkscreen.gbr, oscillator-Edge_Cuts.gbr, oscillator-F_Cu.gbr, oscillator-F_Mask.gbr, oscillator-F_Paste.gbr]
2025-12-27 Add mixer and power expander
    [audio-mixer-B_Cu.gbr, audio-mixer-B_Mask.gbr, audio-mixer-B_Paste.gbr, audio-mixer-B_Silkscreen.gbr, audio-mixer-Edge_Cuts.gbr, audio-mixer-F_Cu.gbr, audio-mixer-F_Mask.gbr, audio-mixer-F_Paste.gbr]
2025-12-27 Add cv mixer
    [cv-mixer-B_Cu.gbr, cv-mixer-B_Mask.gbr, cv-mixer-B_Paste.gbr, cv-mixer-B_Silkscreen.gbr, cv-mixer-Edge_Cuts.gbr, cv-mixer-F_Cu.gbr, cv-mixer-F_Mask.gbr, cv-mixer-F_Paste.gbr]
2025-12-28 Low-pass filter
    [low-pass-filter-B_Cu.gbr, low-pass-filter-B_Mask.gbr, low-pass-filter-B_Paste.gbr, low-pass-filter-B_Silkscreen.gbr, low-pass-filter-Edge_Cuts.gbr, low-pass-filter-F_Cu.gbr, low-pass-filter-F_Mask.gbr, low-pass-filter-F_Paste.gbr]
2025-12-28 Add label to low-pass filter
    [low-pass-filter-B_Cu.gbr, low-pass-filter-B_Mask.gbr, low-pass-filter-B_Paste.gbr, low-pass-filter-B_Silkscreen.gbr, low-pass-filter-Edge_Cuts.gbr, low-pass-filter-F_Cu.gbr, low-pass-filter-F_Mask.gbr, low-pass-filter-F_Paste.gbr]
2025-12-28 Envelope generator
    [envelope-generator-B_Cu.gbr, envelope-generator-B_Mask.gbr, envelope-generator-B_Paste.gbr, envelope-generator-B_Silkscreen.gbr, envelope-generator-Edge_Cuts.gbr, envelope-generator-F_Cu.gbr, envelope-generator-F_Mask.gbr, envelope-generator-F_Paste.gbr]
2025-12-28 Add label to envelope generator
    [envelope-generator-B_Cu.gbr, envelope-generator-B_Mask.gbr, envelope-generator-B_Paste.gbr, envelope-generator-B_Silkscreen.gbr, envelope-generator-Edge_Cuts.gbr, envelope-generator-F_Cu.gbr, envelope-generator-F_Mask.gbr, envelope-generator-F_Paste.gbr]
2026-01-01 Allow alternative heatsink on power supply
    [power-supply-B_Cu.gbr, power-supply-B_Mask.gbr, power-supply-B_Paste.gbr, power-supply-B_Silkscreen.gbr, power-supply-Edge_Cuts.gbr, power-supply-F_Cu.gbr, power-supply-F_Mask.gbr, power-supply-F_Paste.gbr]
2026-01-04 Add vca
    [voltage-controlled-amplifier-B_Cu.gbr, voltage-controlled-amplifier-B_Mask.gbr, voltage-controlled-amplifier-B_Paste.gbr, voltage-controlled-amplifier-B_Silkscreen.gbr, voltage-controlled-amplifier-Edge_Cuts.gbr, voltage-controlled-amplifier-F_Cu.gbr, voltage-controlled-amplifier-F_Mask.gbr, voltage-controlled-amplifier-F_Paste.gbr]
2026-01-05 Buffer output of vca
    [voltage-controlled-amplifier-B_Cu.gbr, voltage-controlled-amplifier-B_Mask.gbr, voltage-controlled-amplifier-B_Paste.gbr, voltage-controlled-amplifier-B_Silkscreen.gbr, voltage-controlled-amplifier-Edge_Cuts.gbr, voltage-controlled-amplifier-F_Cu.gbr, voltage-controlled-amplifier-F_Mask.gbr, voltage-controlled-amplifier-F_Paste.gbr]
2026-01-09 More space for backup pot
    [audio-mixer-B_Cu.gbr, audio-mixer-B_Mask.gbr, audio-mixer-B_Paste.gbr, audio-mixer-B_Silkscreen.gbr, audio-mixer-Edge_Cuts.gbr, audio-mixer-F_Cu.gbr, audio-mixer-F_Mask.gbr, audio-mixer-F_Paste.gbr]
2026-01-09 Envelope generator fixes
    [envelope-generator-B_Cu.gbr, envelope-generator-B_Mask.gbr, envelope-generator-B_Paste.gbr, envelope-generator-B_Silkscreen.gbr, envelope-generator-Edge_Cuts.gbr, envelope-generator-F_Cu.gbr, envelope-generator-F_Mask.gbr, envelope-generator-F_Paste.gbr]
2026-01-09 More envelope generator fixes
    [envelope-generator-B_Cu.gbr, envelope-generator-B_Mask.gbr, envelope-generator-B_Paste.gbr, envelope-generator-B_Silkscreen.gbr, envelope-generator-Edge_Cuts.gbr, envelope-generator-F_Cu.gbr, envelope-generator-F_Mask.gbr, envelope-generator-F_Paste.gbr]
2026-01-10 Various improvements
    [audio-mixer-B_Cu.gbr, audio-mixer-B_Mask.gbr, audio-mixer-B_Paste.gbr, audio-mixer-B_Silkscreen.gbr, audio-mixer-Edge_Cuts.gbr, audio-mixer-F_Cu.gbr, audio-mixer-F_Mask.gbr, audio-mixer-F_Paste.gbr]
2026-01-11 Update low-pass filter
    [low-pass-filter-B_Cu.gbr, low-pass-filter-B_Mask.gbr, low-pass-filter-B_Paste.gbr, low-pass-filter-B_Silkscreen.gbr, low-pass-filter-Edge_Cuts.gbr, low-pass-filter-F_Cu.gbr, low-pass-filter-F_Mask.gbr, low-pass-filter-F_Paste.gbr]
2026-01-15 Fix issues with audio mixer
    [audio-mixer-B_Cu.gbr, audio-mixer-B_Mask.gbr, audio-mixer-B_Paste.gbr, audio-mixer-B_Silkscreen.gbr, audio-mixer-Edge_Cuts.gbr, audio-mixer-F_Cu.gbr, audio-mixer-F_Mask.gbr, audio-mixer-F_Paste.gbr]
2026-01-15 Various fixes
    [audio-mixer-B_Cu.gbr, audio-mixer-B_Mask.gbr, audio-mixer-B_Paste.gbr, audio-mixer-B_Silkscreen.gbr, audio-mixer-Edge_Cuts.gbr, audio-mixer-F_Cu.gbr, audio-mixer-F_Mask.gbr, audio-mixer-F_Paste.gbr]
2026-01-20 Add attenuverter
    [attenuverter-B_Cu.gbr, attenuverter-B_Mask.gbr, attenuverter-B_Paste.gbr, attenuverter-B_Silkscreen.gbr, attenuverter-Edge_Cuts.gbr, attenuverter-F_Cu.gbr, attenuverter-F_Mask.gbr, attenuverter-F_Paste.gbr]
2026-01-20 Clean up attenuverter
    [attenuverter-B_Cu.gbr, attenuverter-B_Mask.gbr, attenuverter-B_Paste.gbr, attenuverter-B_Silkscreen.gbr, attenuverter-Edge_Cuts.gbr, attenuverter-F_Cu.gbr, attenuverter-F_Mask.gbr, attenuverter-F_Paste.gbr]
2026-01-20 Pattern sequencer
    [pattern-sequencer-B_Cu.gbr, pattern-sequencer-B_Mask.gbr, pattern-sequencer-B_Paste.gbr, pattern-sequencer-B_Silkscreen.gbr, pattern-sequencer-Edge_Cuts.gbr, pattern-sequencer-F_Cu.gbr, pattern-sequencer-F_Mask.gbr, pattern-sequencer-F_Paste.gbr]
2026-02-08 Fix attenuverter
    [attenuverter-B_Cu.gbr, attenuverter-B_Mask.gbr, attenuverter-B_Paste.gbr, attenuverter-B_Silkscreen.gbr, attenuverter-Edge_Cuts.gbr, attenuverter-F_Cu.gbr, attenuverter-F_Mask.gbr, attenuverter-F_Paste.gbr]
2026-02-08 Update gerbers
    [audio-mixer-B_Cu.gbr, audio-mixer-B_Mask.gbr, audio-mixer-B_Paste.gbr, audio-mixer-B_Silkscreen.gbr, audio-mixer-Edge_Cuts.gbr, audio-mixer-F_Cu.gbr, audio-mixer-F_Mask.gbr, audio-mixer-F_Paste.gbr]
2026-02-08 Vca fixes
    [attenuverter-B_Cu.gbr, attenuverter-B_Mask.gbr, attenuverter-B_Paste.gbr, attenuverter-B_Silkscreen.gbr, attenuverter-Edge_Cuts.gbr, attenuverter-F_Cu.gbr, attenuverter-F_Mask.gbr, attenuverter-F_Paste.gbr]
2026-02-15 Arduino code for pattern sequencer
2026-02-23 Delay to allow debouncing caps to charge
2026-02-23 More pattern sequencer fixes
    [main.c]
2026-03-22 Update pattern sequencer
    [pattern-sequencer-B_Cu.gbr, pattern-sequencer-B_Mask.gbr, pattern-sequencer-B_Paste.gbr, pattern-sequencer-B_Silkscreen.gbr, pattern-sequencer-Edge_Cuts.gbr, pattern-sequencer-F_Cu.gbr, pattern-sequencer-F_Mask.gbr, pattern-sequencer-F_Paste.gbr]
2026-05-02 Progress on diode ladder
    [diode-ladder-filter.kicad_pcb, diode-ladder-filter.kicad_sch]
2026-05-03 Update diode ladder
    [diode-ladder-filter.kicad_pcb]
2026-05-11 Update some modules
    [attenuverter-B_Cu.gbr, attenuverter-B_Mask.gbr, attenuverter-B_Paste.gbr, attenuverter-B_Silkscreen.gbr, attenuverter-Edge_Cuts.gbr, attenuverter-F_Cu.gbr, attenuverter-F_Mask.gbr, attenuverter-F_Paste.gbr]
2026-05-15 Start fixing issues with diode ladder
    [diode-ladder-filter.kicad_pcb, diode-ladder-filter.kicad_sch]
2026-05-15 Diode ladder fixes and relayout
    [diode-ladder-filter-B_Cu.gbr, diode-ladder-filter-B_Mask.gbr, diode-ladder-filter-B_Paste.gbr, diode-ladder-filter-B_Silkscreen.gbr, diode-ladder-filter-Edge_Cuts.gbr, diode-ladder-filter-F_Cu.gbr, diode-ladder-filter-F_Mask.gbr, diode-ladder-filter-F_Paste.gbr]
2026-05-18 Start of note sequencer
    [note-sequencer.kicad_pcb, note-sequencer.kicad_sch]
2026-05-18 Add ear protector
    [ear-protector.kicad_pcb, ear-protector.kicad_sch]
2026-05-18 Remove ear protector
    [ear-protector.kicad_pcb, ear-protector.kicad_sch]
2026-05-18 Start gate sequencer
    [gate-sequencer.kicad_pcb, gate-sequencer.kicad_sch]
2026-05-18 Progress gate sequencer
    [gate-sequencer.kicad_pcb]
2026-05-19 Update note sequencer
    [note-sequencer.kicad_pcb, note-sequencer.kicad_sch]
2026-05-21 Renumber some components
    [diode-ladder-filter.kicad_pcb, diode-ladder-filter.kicad_sch, gate-sequencer.kicad_pcb, gate-sequencer.kicad_sch, note-sequencer.kicad_pcb, note-sequencer.kicad_sch]
2026-05-21 Revert "Renumber some components"
    This reverts commit 4c9a93e4336de2276d9b49e02718b6a92f997a6a.
    [diode-ladder-filter.kicad_pcb, diode-ladder-filter.kicad_sch, gate-sequencer.kicad_pcb, gate-sequencer.kicad_sch, note-sequencer.kicad_pcb, note-sequencer.kicad_sch]
2026-05-21 Fix issue with extra button
    [note-sequencer.kicad_pcb]
2026-05-21 More fixes
    [note-sequencer.kicad_pcb, note-sequencer.kicad_sch]
2026-05-21 Check in fabrication outputs
    [diode-ladder-filter-B_Cu.gbr, diode-ladder-filter-B_Mask.gbr, diode-ladder-filter-B_Paste.gbr, diode-ladder-filter-B_Silkscreen.gbr, diode-ladder-filter-Edge_Cuts.gbr, diode-ladder-filter-F_Cu.gbr, diode-ladder-filter-F_Mask.gbr, diode-ladder-filter-F_Paste.gbr]
2026-05-23 Fix bug where cv mixer output was flipped
    [cv-mixer-B_Cu.gbr, cv-mixer-B_Mask.gbr, cv-mixer-B_Paste.gbr, cv-mixer-B_Silkscreen.gbr, cv-mixer-Edge_Cuts.gbr, cv-mixer-F_Cu.gbr, cv-mixer-F_Mask.gbr, cv-mixer-F_Paste.gbr]
2026-05-23 Tweak cv mixer text
    [cv-mixer-B_Cu.gbr, cv-mixer-B_Mask.gbr, cv-mixer-B_Paste.gbr, cv-mixer-B_Silkscreen.gbr, cv-mixer-Edge_Cuts.gbr, cv-mixer-F_Cu.gbr, cv-mixer-F_Mask.gbr, cv-mixer-F_Paste.gbr]
2026-05-23 More cv mixer updates
    [cv-mixer.kicad_pcb]
2026-05-23 Fix inverted output in audio mixer
    [audio-mixer-B_Cu.gbr, audio-mixer-B_Mask.gbr, audio-mixer-B_Paste.gbr, audio-mixer-B_Silkscreen.gbr, audio-mixer-Edge_Cuts.gbr, audio-mixer-F_Cu.gbr, audio-mixer-F_Mask.gbr, audio-mixer-F_Paste.gbr]
2026-05-27 Start arduino delay design
    [arduino-delay.kicad_pcb, arduino-delay.kicad_sch]
2026-05-27 Arduino delay progress
    [arduino-delay.kicad_pcb, arduino-delay.kicad_sch]
2026-05-27 Complete arduino delay
    [arduino-delay.kicad_pcb, arduino-delay.kicad_sch]
2026-05-28 Update audio mixer to new format
    [arduino-delay.kicad_pcb, arduino-delay.kicad_sch, audio-mixer.kicad_pcb, audio-mixer.kicad_sch]
2026-05-28 Fix some warnings
    [audio-mixer.kicad_pcb]
2026-06-03 Fix pwm pin controlling screen brightness
    [note-sequencer.kicad_pcb, note-sequencer.kicad_sch]
2026-06-04 Show current note on the screen
2026-06-05 Start firmware for gate sequencer
    [gate-sequencer.kicad_pcb]
2026-06-05 Multilayer cv-mixer
    [cv-mixer.kicad_pcb, cv-mixer.kicad_sch]
2026-06-06 Update some designs
    [arduino-delay.kicad_pcb, audio-mixer.kicad_pcb, cv-mixer.kicad_pcb, cv-mixer.kicad_sch, diode-ladder-filter.kicad_pcb, diode-ladder-filter.kicad_sch, gate-sequencer.kicad_pcb, gate-sequencer.kicad_sch]
2026-06-07 Gate sequencer fixes
    [gate-sequencer.kicad_pcb, gate-sequencer.kicad_sch]
2026-06-07 Update gate sequencer
    [gate-sequencer.kicad_pcb]
2026-06-07 Update diode ladder filter pdf
2026-06-12 Remove bitbanged uart
    Turns out the problem with uart on some arduinos isn't that the
    uart<->usb is broken, but that some (fake) arduinos appear to be
    effectively clocked 4x slower than expected, and this manifests in
    the speed of the cpu clock (programs run 4x slower) and devices like the
    uart.
    [clock.h, uart.c]
2026-06-12 Update pattern sequencer schematic
2026-06-13 Basic pattern programming
    [pattern-sequencer.kicad_pcb, pattern-sequencer.kicad_sch]
2026-06-17 Account for faster arduinos in note sequencer
2026-06-20 Refactor to share code between note seq arduinos
2026-06-20 Command framework for note sequencer
2026-07-03 Extra channels in audio mixer
    [audio-mixer.kicad_pcb, audio-mixer.kicad_sch]
2026-07-05 Update some gerbers
    [arduino-delay-B_Cu.gbr, arduino-delay-B_Mask.gbr, arduino-delay-B_Paste.gbr, arduino-delay-B_Silkscreen.gbr, arduino-delay-Edge_Cuts.gbr, arduino-delay-F_Cu.gbr, arduino-delay-F_Mask.gbr, arduino-delay-F_Paste.gbr]
2026-07-05 Another arduino refactor
2026-07-06 Update arduino delay
    [arduino-delay.kicad_pcb]
2026-07-06 Fix bug where if the first note pressed is C0 it doesn't register properly
    [main.c, util.c]
2026-07-15 Update some pdfs
    [arduino-delay.kicad_sch, audio-mixer.kicad_sch]
2026-07-19 Add code for arduino delay
2026-07-25 Fix some name breaks
    [command.c, command.h, main.c]
2026-07-27 Set up timer 1 for internal clock
2026-07-30 Fix strange bug in note sequence arduino code
    Moving the buffers from global to static arrays fixed the issue I was
    working around by adding delays. Not sure why this works.
    [main.c, util.h]
2026-08-12 Initializing gate pin, printing is optional
2026-08-12 Add some schematic pdfs
2026-08-22 Pressing the rotary encoder causes its value to raise faster
2026-10-05 Switching octaves
2026-10-23 Add missing header in timer.h
2026-10-24 style: indent case statements
2026-10-24 Remove debug prints
2026-10-26 Update some schematics
2026-11-02 Add (currently unused) state_apply_command
